purrrock/purrmidi/Platform/display/st7735/README.md

# Драйвер ST7735 (STMicroelectronics BSP)

Четыре файла скопированы без изменений из репозитория WeActStudio/MiniSTM32H7xx
(коммит `0425ea9ff305205aff1c62a85c2e8b0f32a143bc`):

`SDK/HAL/STM32H743/08-DCMI2LCD/Drivers/BSP/ST7735/{st7735.c, st7735.h, st7735_reg.c, st7735_reg.h}`

Лицензия этих файлов — BSD-3-Clause (указана в заголовках, © STMicroelectronics).
Остальной репозиторий MiniSTM32H7xx лицензирован GPL-3.0 и в проект не входит.
