purrrock/purrmidi/PINOUT.md

# PurrMidi — Физическое подключение (Распиновка)

Целевая платформа: **WeAct STM32H743VIT6 Mini**.

## Сводка зарезервированных выводов MCU
* **PA8–PA12:** USB-интерфейс.
* **PA13, PA14:** Отладка SWD.
* **PE4, PE5, PE6:** Аудиовыход SAI1 Block A.
* **PB10, PB11:** Диагностический UART (USART3).
* **PE3:** Отладочный светодиод (DEBUG_LED).
* **PE10–PE14:** Встроенный TFT-экран ST7735 (SPI4 + управляющие линии).
* **PC8–PC12, PD2 (+PD4):** Встроенный слот microSD / SDMMC1 *(см. ниже)*.
* **PB2, PB6, PD11, PD12, PD13, PE2:** Встроенная QSPI Flash 8 МБ (QUADSPI, банк SoundFont в режиме XIP).

## USB MIDI Host
Интерфейс USB OTG FS.
**Внимание к VBUS:** MIDI-клавиатуре требуется питание **5 В USB VBUS**. На физической плате наличие 5В на USB отсутствует. Вам нужно внешнее питание MIDI-клавиатуры, рекомендуется Y-разветвитель.

| Вывод STM32 | Назначение | Подключение |
|---|---|---|
| PA11 | USB_OTG_FS_DM | USB D− | белый
| PA12 | USB_OTG_FS_DP | USB D+ | зеленый
| PA10 | USB ID | *зарезервировано* |
| PA9 | USB VBUS | *зарезервировано* |
| PA8 | USB SOF | *зарезервировано* |

## Аудио ЦАП PCM5102A
Используется интерфейс **SAI1 Block A**. Сигнал MCLK не используется, ЦАП подключен по трёхпроводной схеме.

| Вывод STM32 | Сигнал SAI | Подключение PCM5102A |
|---|---|---|
| PE6 | SAI1_SD_A | DIN (Данные) |
| PE5 | SAI1_SCK_A | BCK (Тактирование) |
| PE4 | SAI1_FS_A | LRCK / WS (Выбор канала) |
| - | - | GND → GND (Земля) |
| - | - | VCC → Внешнее питание |
| - | - | OUTL/OUTR → Аудиовыход (Наушники/Усилитель) |

## Диагностический UART
Используется для вывода отладочных логов процесса запуска, состояния USB, MIDI и синтезатора.
Настройки: `115200, 8N1`.

| Вывод STM32 | Назначение | Подключение к USB-UART адаптеру |
|---|---|---|
| PB10 | USART3_TX | RX (белый)
| PB11 | USART3_RX | TX (зеленый)
| GND | GND | GND (черный)

## Встроенный TFT-экран ST7735
Экран 160×80 на плате WeAct, подключён к SPI4 (только передача, режим Simplex Bidirectional Master). Используется для вывода статуса MIDI, активных нот и названия аккорда.

| Вывод STM32 | Сигнал | Назначение |
|---|---|---|
| PE12 | SPI4_SCK | LCD_SCL |
| PE14 | SPI4_MOSI | LCD_SDA |
| PE11 | GPIO Output | LCD_CS (программный) |
| PE13 | GPIO Output | LCD_DC (команда/данные) |
| PE10 | GPIO Output | LCD_BL (подсветка, **включается низким уровнем**) |

## Отладочный светодиод
| Вывод STM32 | Назначение |
|---|---|
| PE3 | DEBUG_LED: горит, пока удерживается хотя бы одна нота |

## microSD / SDMMC1
Слот microSD на плате WeAct подключён к периферии SDMMC1. Используется 4-битный режим. Для загрузки банков `.SF2` при запуске устройства.

| Вывод STM32 | Сигнал SDMMC1 | Линия карты |
|---|---|---|
| PC8 | SDMMC1_D0 | DAT0 |
| PC9 | SDMMC1_D1 | DAT1 |
| PC10 | SDMMC1_D2 | DAT2 |
| PC11 | SDMMC1_D3 | DAT3 / CD |
| PC12 | SDMMC1_CK | CLK |
| PD2 | SDMMC1_CMD | CMD |

**Примечания:**
* Линия датчика карты PD4 не используется.
* На линиях D0–D3 и CMD должны быть включены подтяжки к питанию.
* Для всех линий SDMMC1 задаётся скорость выводов `Very High`.
* Настройки CubeMX (тактирование, делитель, NVIC, FatFs) описаны в разделе «Работа с SD-картой» файла `README_RU.md`.

## QSPI Flash (банк SoundFont, XIP)
Встроенная на плате микросхема Winbond W25Q64 (8 МБ) подключена к QUADSPI, Bank1. Линии разведены на плате жёстко,
поэтому в CubeMX нужно выбрать именно эти выводы (настройки и логика: `docs/SOUNDFONT_QSPI_SYNTH.md`):

| Вывод | Сигнал | AF | Назначение |
|---|---|---|---|
| PB2 | QUADSPI_CLK | AF9 | Тактирование |
| PB6 | QUADSPI_BK1_NCS | AF10 | Выбор кристалла |
| PD11 | QUADSPI_BK1_IO0 | AF9 | Данные 0 |
| PD12 | QUADSPI_BK1_IO1 | AF9 | Данные 1 |
| PE2 | QUADSPI_BK1_IO2 | AF9 | Данные 2 |
| PD13 | QUADSPI_BK1_IO3 | AF9 | Данные 3 |

* **IO3 - только PD13.** `PA1` тоже умеет `QUADSPI_BK1_IO3`, и CubeMX может назначить его по умолчанию, но на плате WeAct
  линия IO3 флеша заведена на PD13. С PA1 флеш не определится (JEDEC ID `00 00 00` / `FF FF FF`). PA1 остаётся свободным.
* Скорость всех шести выводов - `Very High` (по умолчанию CubeMX ставит Low, на 80-120 МГц это приводит к ошибкам чтения).
* Подтяжки не нужны, DMA и прерывания QUADSPI не используются. Flash Size в CubeMX - 22 (8 МБ).

## Интерфейс отладки (SWD)
Этот порт должен всегда оставаться доступным для прошивки.

| Вывод | Назначение |
|---|---|
| PA13 | SWDIO |
| PA14 | SWCLK |
| NRST | Reset (Сброс) |

## Временно не используется
Следующая периферия намеренно исключена из распиновки и не используется:
* Вторая внешняя память: 8 МБ SPI Flash (QSPI Flash используется, см. раздел «QSPI Flash»).
* Камера DCMI.
