purrrock/purrmidi/docs/PCM5102A_PINOUT.md

| STM32| Функция | PCM5102A |
| --- | --- | --- |
| ****  | I2S2_CK | BCK |
| ****  | I2S2_WS | LRCK / LCK |
| ****  | I2S2_SD | DIN |
| **3.3V**  | питание | VCC |
| **GND** | земля | GND |

Один из самых главных нюансов фиолетовых плат PCM5102A. Если оставить перемычки нераспаянными, модуль вообще не будет выдавать звук (уйдёт в режим «Mute») или начнёт сильно искажать аудиопоток из-за неверного формата данных. 
На оборотной стороне платы  расположены четыре конфигурационные группы контактов: H1L, H2L, H3L и H4L. Центральная площадка в каждой группе соединена с конкретной ножкой микросхемы, а боковые — с высоким уровнем (H — 3.3V) или низким (L — GND).
Для стандартных DIY-проектов (например, воспроизведение MP3/FLAC через ESP32 или Raspberry Pi) их необходимо распаять строго определённым образом, соединив каплей припоя центральный контакт с нужной буквой: 

## Стандартная конфигурация перемычек для большинства проектов
* 
* H1L (FLT) — Запаять на L (GND): Переключает цифровой фильтр в режим обычного времени задержки (Normal latency FIR filter) для стандартного качественного звука.
* H2L (DEMP) — Запаять на L (GND): Отключает функцию деэмфазиса (уменьшение искажений для старых CD-форматов 44.1 кГц). В обычном состоянии она должна быть выключена.
* H3L (XSMT) — Запаять на H (3.3V): Самая критичная перемычка. Переводит плату в рабочий режим (Soft un-mute). Если оставить её пустой или припаять к L, плата останется в беззвучном режиме сна (Mute).
* H4L (FMT) — Запаять на L (GND): Задаёт формат входящих цифровых данных как стандартный I2S. Если припаять к H, активируется формат Left-Justified, и вместо музыки вы услышите громкий цифровой шум. 
* 
------------------------------
## Перемычка SCK на лицевой стороне
На лицевой стороне платы (рядом с надписью SCK) есть ещё одна нераспаянная перемычка. Она замыкает пин системного тактового сигнала SCK на GND.
* 
* Зачем это нужно: Такие микроконтроллеры, как ESP32 или Raspberry Pi, выдают только 3 сигнальные линии (BCK, LCK, DIN) и не генерируют мастер-клок SCK. Замыкание этой перемычки заставляет внутренний умножитель частоты (PLL) чипа PCM5102A генерировать SCK автоматически из сигнала BCK.
* Рекомендация: Её тоже желательно капнуть припоем, чтобы не тянуть лишний внешний провод от пина SCK к земле вручную. 
*
