purrrock/purrmidi/docs/SD_CARD_AND_QSPI.md

# SD-карта (SDMMC1) и QSPI Flash

Как прибор обновляет банк SoundFont и что делать, если карта не читается. Устройство QSPI XIP и синтезатора SoundFont — в [SOUNDFONT_QSPI_SYNTH.md](SOUNDFONT_QSPI_SYNTH.md).

## Обновление банка SoundFont

SD-карта нужна **только для обновления банка**. Банк SoundFont хранится во внешней QSPI Flash и читается синтезатором оттуда (XIP); с SD-карты звук не воспроизводится. Чтобы обновить банк, положите новый файл в корень microSD-карты по пути `0:/SNDFNT.SF2`, вставьте карту и включите прибор. Если карты нет, прибор запускается с банком, который уже записан во флеш. Карту можно вынимать после старта.

При старте микроконтроллера загрузчик проверяет заголовок во внешней QSPI Flash W25Q64:
- Если заголовок совпадает с файлом на картe (размер, штамп времени, CRC32), старт происходит мгновенно, и синтезатор читает сэмплы напрямую из флеш-памяти в режиме XIP.
- Если файла на карте нет, но во флеш-памяти закоммичен валидный банк, синтезатор запускается сразу из флеш-памяти.
- Если банк на карте новый или изменён, загрузчик автоматически стирает и переписывает QSPI Flash (30–60 секунд, прогресс виден на дисплее и в UART).

Основные настройки CubeMX для SDMMC1:

1. **Connectivity → SDMMC1:** режим `SD 4 bits Wide bus`, Clock Edge — Rising, Clock Power Save — Disable, Hardware Flow Control — Disable.
2. **Clock divide factor:** `4` при источнике SDMMC 192 МГц, что даёт частоту SDMMC_CK 24 МГц по формуле `192 МГц / (2 × 4)`.
3. **GPIO:** скорость выводов `Very High`; подтяжки вверх на D0–D3 и CMD, без подтяжки на CLK.
4. **Clock Configuration:** источник тактирования SDMMC — PLL1Q (192 МГц).
5. **Middleware → FATFS:** режим `User-defined` (диск-драйвер — `Platform/sd/sd_storage.c`, только чтение; вызовы `MX_SDMMC1_SD_Init` и `MX_FATFS_Init` в CubeMX отключены), `USE_LFN` — Enabled with static working buffer, `MAX_SS`/`MIN_SS` — 512, `USE_FASTSEEK` — Enabled, **`FS_READONLY` — 1 (Read only)**, **`FS_LOCK` — 0** (при `FS_READONLY = 1` блокировки файлов должны быть отключены), `USE_MKFS` — 0.

> Почему не режим «SD Card» в CubeMX: сгенерированная инициализация SDMMC1 при отсутствии карты вызывает `Error_Handler()` и вешает прибор, а теперь карта вставлена только на время обновления. Кроме того, IDMA SDMMC1 не видит DTCM (там `.bss` и буферы FatFs), и сгенерированному драйверу нужны ручные обходы; в `sd_storage.c` они уже есть (bounce-буфер, проверка выравнивания и кэша).

Карту следует форматировать в FAT32.

### Диагностика: SD не монтируется / файл не открывается
При сбое в UART выводятся строки `[SD] ...` и `[SF2] ...`, по ним видно, на каком этапе остановилось:

| Строка в логе | Что означает |
|---|---|
| `SD mount failed: INIT`, `hsd.ErrorCode=0x...` | `HAL_SD_Init` не смог поднять карту: контакт, питание, тактирование, несовместимая карта. Код расшифровывается по маске `HAL_SD_ERROR_*`. |
| `SD mount failed: LINK` | `FATFS_LinkDriver` не удался: в проекте остался вызов `MX_FATFS_Init` или `_VOLUMES` ≠ 1. |
| `SD mount failed: MOUNT`, `f_mount=13` | Карта читается, но FatFs не нашёл файловую систему (`FR_NO_FILESYSTEM`). Проверьте разметку и формат. |
| `SD mount failed: MOUNT`, `f_mount=1`, `first read failure: stage=...` | `FR_DISK_ERR`: чтение сектора не удалось. `stage=1` - карта не вернулась в состояние TRANSFER, `2` - `HAL_SD_ReadBlocks_DMA` отказал, `3` - таймаут/ошибка DMA; рядом печатаются `hsd.ErrorCode` и состояние карты. |
| `f_open(...) failed: FRESULT=4` | Файла с таким именем в корне нет. Следом печатается список корня `[SD] root directory`, там видны реальные имена (частый случай: Windows скрыл расширение, и файл называется `SNDFNT.SF2.sf2`). |

Датчик наличия карты (`SD_DETECT`, PD4) не используется: карта определяется самой инициализацией `HAL_SD_Init`.

Подробности работы QSPI Flash XIP и конфигурации сэмплирования: `docs/SOUNDFONT_QSPI_SYNTH.md`.
