purrrock/purrmidi/docs/USB-UART adapter.md

Преобразователь USB - UART PL2303TA (с кабелем)
USB к UART TTL кабель PL2303 TA RS232 передаёт информацию со скоростью от 75 до 128 000 Кбит/с. Кабель может работать с 3.3 В или 5 В выходным напряжением, которое чаще всего имеют микроконтроллеры. Поддерживает USB 1.1 и 2.0.

На одном конце имеется USB разъём, а на другом – 4 разъёма-вывода «мама», которые удобно подсоединяются к любой плате с UART интерфейсом. Красный провод – Vcc c +5 В, белый – RXD, зелёный – TXD, чёрный – GND.
