purrrock/purrmidi/ROADMAP.md

# PurrMIDI: планы развития

 Что планируется сделать и в каком порядке.

**Главный принцип:** PurrMIDI остаётся простым в использовании. Собрать и настроить и использовать прибор должен уметь человек без опыта в электронике и без знаний музыкальной теории. Любая новая возможность либо работает «из коробки» с разумными значениями по умолчанию, либо остаётся необязательной.

Обозначения: `[ ]` — не начато, `[~]` — сделано частично, `[x]` — готово.

## Приоритеты

| Очередь | Что делаем | Зачем | Статус |
| --- | --- | ----- | --- |
| 1 | Сайт на GitHub Pages, фото и видео, FAQ, «Что умеет и чего нет» | Проект понятен новичку | сделана заготовка, нужны фото и видео |
| 2 | Единая таблица CC | Понятно, что делают ручки клавиатуры | таблица и иллюстрация готовы, осталось описать конкретные клавиатуры |
| 2 | Подбор ЦАП без пайки | Меньше барьеров при сборке | — |
| 2 | Опрос: нужен ли вариант без внешнего ЦАП | Понять, что важнее: простота сборки или качество звука | форма и блок на сайте добавлены, ждём ответов |
| 3 | Общая реверберация (и, возможно, хорус) | Заметно более «взрослый» звук | реверберация готова в коде и тестах, нужны замер времени и прослушивание на плате |
| 3 | CC и ударные в SoundFont | Больше возможностей банков | — |
| 4 | Новые движки | Больше тембров | — |
| 4 | Версии для Linux и macOS | Больше пользователей, которые могут проверить звук на ПК | — |

Очередь 1 — первым делом, 4 — когда остальное стабилизируется.

## 1. Релизы и прошивка

Цель: чтобы получить рабочий прибор, не требовалось собирать проект.

- [X] **Веб-прошивальщик (WebUSB DFU)**: `site/flash/` (страницы `/flash/` и `/ru/flash/`), без зависимостей и без отправки файлов на сервер.
- [x] **Проверено на реальной плате (Windows, Chrome)**: стирание двух секторов, запись 163 КБ блоками по 1024 Б, чтение назад и запуск прошивки прошли; драйвер ставить не нужно, STM32CubeProgrammer после веб-прошивки по-прежнему видит плату. Chrome не передаёт имя интерфейса, поэтому прошивальщик берёт alt 0 как внутреннюю flash (запасной вариант в `dfuse.js`).
  - [ ] Проверить Linux (правило udev), macOS и Android.

## 2. Сайт проекта

## 3. Единое поведение движков

**Сделано.** Описание нового поведения — в `docs/ENGINES.md`, раздел «Единое поведение движков»; тесты — `tests/test_engine_unified.cpp`. Ниже сохранён исходный план.

### Единая таблица CC

Для новичка полезнее картинка «что делают ручки вашей клавиатуры», чем описание по движкам.

- [x] Таблица типовых контроллеров: что делает каждый CC в каждом движке одной строкой на контроллер (готовая версия — в `docs/ENGINES.md`, раздел «Что делают ручки и колёса вашей клавиатуры»; ниже сохранён исходный набросок):

  | CC | Типичное название на клавиатуре | Что меняет |
  | -- | ------------------------------- | ---------- |
  | 1 | Mod wheel | «живее, ярче»: яркость (E-Piano, Pluck), фильтр (Lead), вибрато (Violin, SoundFont), хорус (Organ); в нуле звук не меняется |
  | 7 | Volume | общая громкость |
  | 64 | Sustain | педаль сустейна |
  | 71 | Resonance / Harmonic | резонанс или яркость (по движку) |
  | 74 | Brightness / Cutoff | яркость или срез фильтра |
  | 91 | Reverb | глубина реверберации (реализована) |
  | 93 | Chorus | глубина хоруса (после появления эффекта) |

- [x] Иллюстрация «ручки и колёса клавиатуры → что они делают» (SVG, русская и английская): `docs/controls_{ru,en}.svg`, `site/controls_{ru,en}.svg`; используется в README, `docs/ENGINES.md` и на сайте. Пересборка: `python3 tools/gen_controls_svg.py`.
- [ ] Отдельно описать, какие контроллеры есть на типовых недорогих клавиатурах (например, у NTK-61 и SMK-25 их набор отличается), чтобы пользователь понимал, что доступно именно ему. Общая подсказка («двигайте ручку, на дисплее появится её название или номер CC») уже в `docs/ENGINES.md`; конкретные модели нужно проверить на приборе, это пересекается с `docs/KEYBOARDS.md` (раздел 7).
- [x] Коротко показывать на дисплее подсказку при изменении CC («Bright 80%») и статус педалей (SUSTAIN ON/OFF): `Display_ShowControl()`.

## 4. Звук: эффекты и SoundFont

### Общая реверберация и хорус

Глобального эффекта сейчас нет (хорус есть только внутри Organ). Реверберация сильнее всего улучшает звучание при минимальной сложности для пользователя.

- [x] Выбрать алгоритм реверберации: лёгкий, с небольшим объёмом памяти. Выбрана FDN из 8 линий (Хаусхолдер, потери высоких частот, два диффузора, моно вход и стерео выход), `Engine/synth/reverb.h`. Варианты на 4, 6 и 8 линий сравнивались по импульсному отклику: время плотности эхо 127 / 99 / 65 мс, память 25 / 34 / 38 КБ; взято 8 линий (≈38 КБ).
- [ ] **Измерить бюджет рендера на плате.** По сгенерированному коду (около 300 инструкций на кадр) эффект занимает порядка 3–4,5% бюджета блока (2,67 мс), но это оценка, не замер. Нужно:
  - собрать диагностическую сборку (`-DAUDIO_DIAG_UART=1 -DSF2_DIAG_STATS=1`) и измерить время рендера с эффектом (`CC91 = 40`) и без него (`CC91 = 0`) на плотных аккордах SoundFont;
  - проверить, что пороги защиты (`SYNTH_REVERB_SHED_PCT` = 70%, `SYNTH_REVERB_RESTORE_PCT` = 55%) не отключают эффект на обычной игре.
- [x] **Что делать при нехватке времени:** реверберация плавно отключается раньше, чем гасятся голоса (`synth::ReverbLoadGuard`, порог 70% против 75% у SoundFont), и возвращается с гистерезисом.
- [x] Один параметр для пользователя; значение по умолчанию «немного» (`SYNTH_REVERB_DEFAULT` = 20; в GM по умолчанию 40). **Подобрать на слух:** кривую `SYNTH_REVERB_MAX_WET * (CC/127)^1.25`, значения по умолчанию и время затухания (`kRt60Seconds`, `kDamping` в `reverb.h`) выбирал расчёт по уровню (хвост ≈ −15 дБ при CC91 = 40), а не прослушивание.
- [x] **CC91** для тех, кто хочет управлять. **Значение намеренно не сохраняется:** после включения всегда «немного» (в RTC хранятся только инструмент и громкость), чтобы забытая ручка не портила звук. **CC93** (хорус) не реализован.
- [x] Буферы эффекта лежат в DTCM (`.bss`, ≈38 КБ): занятость DTCM 36% → 66%, AXI SRAM не изменилась (≈80%), FLASH +2,4 КБ. `tools/check_firmware_size.sh` и `tools/check_firmware_flags.sh` проходят.
- [ ] Хорус как второй шаг, только если останется запас по CPU (после замера на плате). Это необязательно.
- [x] Тесты: `tests/test_reverb.cpp` (обход бит-в-бит при нуле, спад, устойчивость, уровень, стерео, отсутствие щелчков при изменении глубины, Kill, защита по нагрузке) и `tests/test_engine_reverb.cpp` (CC91, сохранение при смене инструмента и Panic, сброс хвоста, All Sound Off, громкость 0, перегрузка). Существующие golden-тесты теперь идут с включённой реверберацией.

### SoundFont: контроллеры и ударные

- [ ] **Пробросить CC в SoundFont.** Сейчас у движка нет собственных CC. Как минимум: колесо модуляции (CC1), яркость (CC74), реверберация (CC91 уже есть на общем уровне, в TinySoundFont она не нужна), хорус (CC93). Проверить, какие из них TinySoundFont поддерживает штатно, а что придётся добавить.
- [ ] **Ударные (канал 10).** Сейчас канал не учитывается (omni), поэтому ударные из GM-банка на канале 10 не сыграют. Сначала проверить, как банк `__Florestan_Basic_GM_GS.sf2` ведёт себя в Windows-приложении и на приборе. Затем один из вариантов:
  - поддержать канал 10 как отдельный режим (ударная пресет-банка 128);
  - либо честно написать в документации, что ударные не поддерживаются, и объяснить, как выбрать ударный пресет вручную через Program Change.
- [ ] Оценить стоимость: отдельная обработка канала означает, что событие MIDI должно нести номер канала. Сейчас диспетчер его отбрасывает (`MIDI_Dispatch` не передаёт канал). Это затрагивает `midi_event.h`, `usb_midi_packet.c` и тесты.

## 5. Документация и сообщество

- [ ] **Фото готового устройства и короткое видео** (подключение и первый звук) в начале README и на сайте.
- [ ] **Список проверенных клавиатур** (`docs/KEYBOARDS.md`). Сейчас проверены:
  - NTK-61;
  - SMK-25.
  Для каждой указать: питание, какие CC и Program Change она отправляет, известные особенности (в `ARCHITECTURE.md` упомянут случай клавиатур на чипах Jieli, которым нужно восстановление USB-порта). Принимать дополнения от сообщества через Issues.
- [ ] Двуязычность (русский и английский) документации в `docs/`.

## 6. Аппаратная часть: ЦАП без пайки

Сейчас PCM5102A без пайки перемычек не работает: нужны H1L–H4L и перемычка SCK (см. `docs/HARDWARE.md`). Это главный барьер для людей без паяльника.

- [~] **Опрос: нужен ли дополнительный вариант без внешнего ЦАП.** ЦАП PCM5102A остаётся основным вариантом. Вопрос в том, нужен ли ещё и упрощённый: звук выводит встроенный ЦАП микроконтроллера (PA4 и PA5, 12 бит), а вместо модуля нужны только гнездо 3,5 мм и разделительный конденсатор. Форма голосования: `.github/ISSUE_TEMPLATE/audio_poll.yml` (метка `poll`), блок «Нужен ли вариант проще?» на сайте.
  - [ ] Собрать ответы и записать итог здесь. Заранее решить, какой результат считать достаточным для начала работы.
  - [ ] Если вариант нужен, сначала собрать прототип на плате и измерить уровень шума и фона от питания (USB, дисплей, QSPI). Только после этого обещать качество в документации.
  - [ ] При положительном решении: параметр сборки `AUDIO_OUT` (`I2S` по умолчанию, `DAC` как дополнительный), без удаления пути I2S. Для `DAC`: DAC1 + TIM6/TIM7 + DMA, преобразование знаковых отсчётов в беззнаковые, плавный старт и остановка против щелчков, при необходимости дизеринг. Описать в `docs/HARDWARE.md` схему с конденсатором и RC-фильтром и оговорить, что наушники напрямую подключать не стоит.
- [ ] **Критерии подбора ЦАП:**
  - работает с тремя линиями I2S (BCK, LRCK, DIN), без MCLK, 16 бит, 48 кГц;
  - питание 3,3 В;
  - не требует пайки (выводы уже распаяны, настройка перемычками-джамперами или вообще не нужна);
  - доступен и недорог, продаётся под понятным названием;
  - линейный выход подходит для наушников и усилителя; желательно с разъёмом 3,5 мм.
- [ ] **Кандидаты для проверки** (не проверены на приборе, это только список для проверки):
  - модули на PCM5102A, у которых нужные перемычки уже выставлены на заводе (в продаже встречаются варианты, где SCK замкнут на GND и формат I2S установлен изначально), нужно найти конкретные модели и сверить схему;
  - модули на UDA1334A (например, Adafruit I2S Stereo Decoder): ЦАП сам получает такт из BCK и не требует MCLK, настройка делается без пайки. Проверить формат данных (16 бит, 48 кГц) и уровень выхода.
- [ ] Для каждого проверенного модуля: фото, схема подключения, список настроек, результат прослушивания (шум, искажения, уровень).
- [ ] Обновить `docs/HARDWARE.md`, список покупок и сайт. Если подключение другого ЦАП меняет код (например, формат данных SAI), вынести его в параметр сборки или документированную настройку.

## 7. Новые движки

Одновременно звучит один движок, и они делят общую арену голосов (72 КБ). Новый движок не должен превышать размер самого большого (Pluck, 66 КБ), иначе придётся увеличивать арену (`SYNTH_ARENA_BYTES`).

- [ ] **Духовые** (флейта, саксофон, труба): физическая модель с волноводом и шумом дыхания либо субтрактивный синтез. Управление дыханием через aftertouch и CC2/CC11.
- [ ] **Ударные**: отдельный движок или режим SoundFont-канала 10 (см. раздел 4). Простой синтез барабанов (бочка, малый, хэт) может быть компактнее сэмплов.
- [ ] **Бас**: простой субтрактивный или FM-бас.
- [ ] **Пэд** (медленные струнные/«облачные» звуки): несколько детюнированных генераторов с медленной атакой.
- [ ] **Клавинет**: щипково-клавишный звук, близкий по устройству к Pluck/E-Piano.

Для каждого нового движка:

- [ ] строка в `docs/ENGINES.md` (голоса, описание, управление) и в таблицу Program Change;
- [ ] хостовый тест и golden-тест (`tests/`);
- [ ] проверка размера арены, времени рендера и размера прошивки;
- [ ] поддержка Pitch Bend, All Notes Off и единого смысла CC1 с самого начала (раздел 3).

## 8. Другие платформы

Хостовые тесты на Linux уже собираются в CI, RtMidi кроссплатформенный.

- [ ] **Linux:** сборка Windows-приложения (`Platform/windows/`) под Linux. Для этого, вероятно, нужно переименовать каталог в нейтральное имя (например, `Platform/desktop/`) и заменить Windows-специфичный вывод звука на miniaudio или аналог. Добавить сборку в CI.
- [ ] **macOS:** то же самое; учесть права доступа к MIDI и аудио.
- [ ] Обновить `docs/WINDOWS_BUILD.md` (переименовать в общий `DESKTOP_BUILD.md` или добавить разделы).

## 9. Идеи на потом

Идеи, которые пока не берём в работу, но не забываем:

- Профили velocity (мягкая / обычная / жёсткая) для клавиатур с плохой динамикой.
- Транспонирование.
- Разделение клавиатуры (split) на два инструмента.
- MIDI DIN вход (UART 31250 бод + оптрон) для старых клавиатур. Это уже электроника, поэтому только как необязательное расширение.
- Потенциометр громкости на АЦП или энкодер как необязательное расширение корпуса.
- USB-MIDI Device (подключение к ПК как MIDI-интерфейс): на плате WeAct есть только один USB-порт, поэтому потребовало бы другого аппаратного решения.
- Запись игры (MIDI-файл или WAV) на microSD.
- Метроном.

## Как предложить идею или помочь

Идеи, замечания и результаты проверки оборудования (клавиатуры, ЦАП) присылайте через [Issues](https://github.com/purrrock/purrmidi/issues). Чем подробнее описание (модель, что на дисплее, что в UART), тем легче воспроизвести проблему.
