purrrock/purrmidi/Review.md

## Ошибки и недоработки (на основе кода и TODO.md)

### Производительность и математика
*   **Использование `double`:** В `TODO.md` отмечено использование `double` в фильтрах и расчетах `pow`/`tan`. Для аудио-синтеза на Cortex-M7 (даже с DP-FPU) `float` является стандартом. `double` в два раза медленнее в некоторых операциях и увеличивает нагрузку на память/кэш.
*   **Вычислительная стоимость SoundFont:** 300 тактов на голос — это много для линейной интерполяции. Вероятно, проблема в отсутствии использования CMSIS-DSP или неоптимальном доступе к памяти QSPI.

### Аудио-тракт
*   **Отсутствие единообразного AutoGain:** В некоторых движках (Lead, Violin) зафиксировано усиление, что может приводить к клиппингу на плотных аккордах. 
*   **Обработка ошибок:** `Error_Handler()`, который просто перезагружает прибор, недопустим для конечного продукта. Пользователь не должен слышать резкий щелчок и ждать перезагрузки при возникновении программной ошибки.
Вместо простого ребута в Error_Handler, записывать код ошибки и адрес инструкции в небольшую область SRAM (которая не затирается при Soft Reset) и выводить краткий код ошибки на TFT-дисплей

## Рекомендации по улучшению

### Оптимизация (Performance)
1.  **Миграция на `float`:** Замените все `double` на `float`. Используйте литералы `0.0f` вместо `0.0`.
2.  **CMSIS-DSP:** Интегрируйте библиотеку `arm_math.h`. Вместо самописных функций используйте `arm_sin_f32`, `arm_exp_f32` и т.д. Они оптимизированы под инструкции SIMD Cortex-M7.
3.  **TCM для критических циклов:** Если джиттер в аудио-потоке сохранится, попробуйте перенести наиболее часто вызываемые функции рендеринга (inner loops) в **ITCM** (Instruction Tightly Coupled Memory), чтобы исключить влияние кэша инструкций.

### Функциональность и UX
1.  **Персистентность настроек:** Сейчас выбор инструмента не запоминается. Рекомендую выделить небольшой сектор во внутренней Flash (или использовать EEPROM/Backup SRAM) для сохранения последнего выбранного пресета и настроек громкости.
2.  **Сглаживание (Interpolation):** Для параметров CC (например, громкость или частота среза) внедрите простую линейную интерполяцию между кадрами (smoothing), чтобы избежать «ступенчатого» звука (zipper noise).

### Тестирование
1.  **CI/CD для Windows-версии:** Настройте GitHub Actions для автоматического прогона тестов в `tests/` при каждом пуше.
2.  **Unit-тесты на граничные случаи:** Добавьте тесты на «панику» (одновременное нажатие 128 нот) для проверки устойчивости `SynthArena` и `SoftLimit`.

### Прочее

Перевести README.md на English, Ссылку на README_RU.md сделать в начале.

Добавьте проверку, что SNDFNT.SF2 < 8МБ перед загрузкой

---
**Итог:** Основной вектор развития сейчас — переход от «работающего прототипа» к «оптимизированному продукту» через замену `double` на `float` и внедрение CMSIS-DSP.
