purrrock/purrmidi/docs/ENGINES.md

# Звуковые движки и управление

Справочник по инструментам PurrMidi: список движков, выбор программы, управление с MIDI-клавиатуры и устройство каждого
движка. Краткая инструкция по работе с прибором — в [README](../README_RU.md), внутреннее устройство прошивки — в
[ARCHITECTURE.md](ARCHITECTURE.md), банк SoundFont — в [SOUNDFONT.md](SOUNDFONT.md).

## Список движков

Одновременно звучит один движок. Один и тот же код работает в прошивке и в Windows-приложении.

| Программа | Инструмент | Голоса | Описание | Исходники (`Engine/synth/`) |
| ---: | --- | -----: | --- | --- |
| `0` | **E-Piano** | 8 | FM-электропиано в духе Rhodes / DX7 (по умолчанию) | `epiano_synth.cpp` |
| `1` | **Pluck** | 8 | Нейлоновая гитарная струна (Карплус — Стронг + корпус) | `pluck_synth.cpp` |
| `2` | **Lead** | 8 | Аналоговый субтрактивный лид на DaisySP (`Oscillator`, `Svf`, `Adsr`) | `lead_synth.cpp` |
| `3` | **Organ** | 12 | Тонколесный орган на `bfreeOrgan2`, drawbars и хорус | `organ_synth.cpp` |
| `4` | **Violin** | 8 | Физическая модель смычковой струны (волновод, как STK `Bowed`) и резонансы деки | `violin_synth.cpp` |
| `5…` | **SoundFont** | до 32 | SoundFont2 на TinySoundFont: каждый пресет банка — отдельная программа | `soundfont_synth.cpp` |

## Выбор инструмента (Program Change)

Нумерация значения Program Change (`data1`) начинается с нуля. Некоторые клавиатуры показывают номера с единицы, тогда `127`
отображается как №128. На дисплее номер тоже показан с единицы (программа `0` → «01»).

Всего программ `5 + N`, где `N` — число пресетов в загруженном SF2. Если банка нет, `N` считается равным 1: под номером `5`
остаётся программа «SoundFont», выбор которой сообщает об ошибке. Число программ возвращает `SynthEngine_GetProgramCount()`.

| `data1` | Действие |
| ---: | --- |
| `0…4` | Выбрать E-Piano, Pluck, Lead, Organ, Violin |
| `5…(5+N−1)` | Выбрать SoundFont и его пресет №(`data1` − 5) |
| до `126` | Номера за пределами списка: `program % (5 + N)` |
| **`127`** | **Следующая программа по кругу** (Next Instrument) |

Порядок цикла `127`: E-Piano → Pluck → Lead → Organ → Violin → SF: пресет 1 → … → SF: пресет N → E-Piano.
Недоступные движки (например, SoundFont без банка) пропускаются. Напрямую выбрать программу `127` нельзя.

Правила переключения:

* Канал не учитывается (omni).
* Повторный выбор активного инструмента состояние не сбрасывает. Смена пресета SoundFont внутри активного движка не обрывает
  звучащие ноты: они доигрывают прежним тембром, новые берут новый пресет. Выбранный пресет сохраняется при `Panic` и при
  переключении на другой инструмент и обратно.
* При смене инструмента новый движок стартует с чистого состояния; возможна короткая пауза тишины.
* **Кнопка K1 (PC13)** на плате работает как Program Change `127`, с неблокирующим debounce.
  Если ваш контроллер умеет отправлять Program Change, назначьте `127` на любую кнопку (например, SUS).
* **Сохранение.** На STM32 выбор программы и громкость сохраняются в резервных регистрах RTC (`Platform/system/backup.c`) и
  восстанавливаются после перезапуска. После отключения питания они остаются только при установленной батарейке на VBAT
  (см. [HARDWARE.md](HARDWARE.md#батарейка-vbat-необязательно)). Без батарейки, а также при пустых или повреждённых данных
  запускается E-Piano (`SYNTH_ENGINE_DEFAULT` в `synth_engine.h`).
* В UART выводится строка `[PC] program N -> <имя>`.

## Общая громкость (CC7)

Громкость всего синтезатора задаётся Control Change **CC7** (канал не учитывается). У PCM5102A нет аппаратной регулировки, поэтому
`SynthEngine_FillStereoBuffer()` умножает выход активного движка на коэффициент.

* Кривая квадратичная: `127` → 1,0, `64` → ≈0,25 (−12 дБ), `0` → тишина.
* Коэффициент меняется плавно внутри блока, щелчков при вращении ручки нет.
* CC7 перехватывается в `SynthEngine_ControlChange()` и в движки не передаётся.
* Громкость не сбрасывается при смене инструмента; начальное значение — `SYNTH_MASTER_VOLUME_DEFAULT` (127).
* Макросы `SYNTH_MASTER_VOLUME_CC`, `SYNTH_MASTER_VOLUME_DEFAULT`; API: `SynthEngine_SetMasterVolume()` / `GetMasterVolume()`.

## Общая реверберация (CC91)

Один эффект поверх звука любого инструмента: добавляет ощущение помещения, не меняя тембр. Управляется Control Change **CC91**
(канал не учитывается); пользователю нужен всего один параметр.

* **По умолчанию «немного»:** значение `40` (так в стандарте GM), хвост примерно на 15 дБ тише прямого звука. `0` выключает
  эффект полностью (звук бит-в-бит такой же, как без него, процессор не тратится), `127` даёт заметный «зал».
* **Не сохраняется при выключении.** После включения питания реверберация всегда стартует со значения по умолчанию. Это
  сделано намеренно: в RTC сохраняются только выбранный инструмент и громкость, а любую другую настройку (в том числе
  забытую в максимуме ручку) выключение питания сбрасывает, чтобы прибор не звучал «плохо» из-за вчерашней крутилки.
* **Как громкость, это общая настройка прибора:** она не сбрасывается сменой инструмента и `Panic()`. А вот *хвост* эффекта
  сбрасывается при смене инструмента и `Panic()` (звук предыдущего инструмента не «перетекает» в новый), а CC120 (All Sound
  Off) гасит его за ~21 мс вместе с голосами; после этого ещё ~170 мс вход эффекта заглушён, чтобы доигрывающие остатки
  движка не породили новый хвост. CC123 хвост не трогает: ноты отпускаются как обычно, хвост затухает сам.
* **Стоит до регулятора громкости**, поэтому CC7 = 0 заглушает и хвост.
* **Без щелчков:** любое изменение глубины, включение и выключение идут линейной рампой внутри блока (2,67 мс).
* **Защита от перегрузки.** Если сам движок занял больше 70% бюджета блока два блока подряд (`SYNTH_REVERB_SHED_PCT`),
  реверберация плавно отключается, чтобы не мешать, а голоса SoundFont (см. [SOUNDFONT.md](SOUNDFONT.md), «Защита от
  перегрузки») начинают гаситься только с 75%. Вернётся она, когда нагрузка будет ниже 55% 128 блоков подряд (≈0,34 с).
  Время меряется по самому движку без эффекта, поэтому решение не раскачивается. На ПК часов нет, там эффект всегда включён.
* **Алгоритм** (`Engine/synth/reverb.h`): сеть задержек с обратной связью (FDN) из 8 линий 13–37 мс с матрицей Хаусхолдера,
  потерями высоких частот и двумя диффузорами на входе; вход моно, выход стерео с разными ортогональными наборами для левого и
  правого канала. Время затухания около 1,4 с. Состояние занимает ≈38 КБ в `.bss` (DTCM), AXI SRAM не затрагивается.
* **Цена.** Около 300 инструкций на кадр, то есть по оценке 3–4,5% бюджета блока; это оценка по сгенерированному коду, на плате
  время не измерялось (см. ROADMAP). Хорус (CC93) пока не реализован и CC93 игнорируется.
* Макросы `SYNTH_REVERB_ENABLE` (0 убирает эффект из сборки целиком), `SYNTH_REVERB_CC`, `SYNTH_REVERB_DEFAULT`,
  `SYNTH_REVERB_MAX_WET`, `SYNTH_REVERB_SHED_PCT`, `SYNTH_REVERB_RESTORE_PCT`, `SYNTH_REVERB_RESTORE_BLOCKS`; API:
  `SynthEngine_SetReverb()` / `GetReverb()` / `IsReverbShed()`. Тесты: `test_reverb` (алгоритм) и `test_engine_reverb` (CC91,
  смена инструмента, All Sound Off, перегрузка).

## Что делают ручки и колёса вашей клавиатуры

Ручки и колёса клавиатуры и что они делают в PurrMidi

Одна строка на контроллер. Названия в колонке «Как называется на клавиатуре» типовые: на вашей модели надпись может быть
другой, важен **номер CC**. Если инструмент контроллер не использует, он просто игнорируется.

| CC | Как называется на клавиатуре | Что меняет |
| -: | --- | --- |
| Pitch Bend | Колесо высоты тона | Высота звука ±2 полутона, во всех инструментах |
| 1 | Mod wheel, мод-колесо | «Живее, ярче»; в нуле звук не меняется. E-Piano, Pluck: яркость. Lead: глубина огибающей фильтра. Violin, SoundFont: вибрато. Organ: с 64 и выше включает хорус |
| 2, 11 | Breath, Expression | Violin: экспрессия (сила смычка). SoundFont: CC11 меняет экспрессию (TinySoundFont); CC2 не используется. Остальные: ничего |
| 7 | Volume, громкость | Общая громкость, во всех инструментах |
| 10 | Pan, панорама | Только SoundFont (обрабатывает TinySoundFont) |
| 20–28 | Drawbars, фейдеры | Только Organ: регистры 16′ … 1′ |
| 64 | Sustain, педаль | Педаль сустейна, во всех инструментах, кроме Organ (у органа сустейна нет) |
| 70 | Sound Variation | Organ: хорус вкл/выкл. Violin: положение смычка |
| 71 | Resonance, Harmonic | E-Piano, Pluck: яркость. Lead: резонанс фильтра. Organ: скорость хоруса. Violin: прижим смычка |
| 72 | Release, отпускание | E-Piano, Lead, Violin: время отпускания. Pluck: длительность затухания. Organ: глубина хоруса |
| 73 | Attack, атака | Lead, Violin: время атаки |
| 74 | Brightness, Cutoff | E-Piano, Pluck, Violin: яркость. Lead: частота среза фильтра |
| 75 | Sound Controller 6 | Violin: шум смычка |
| 77, 78 | Sound Controller 8, 9 | Только Organ: атака и отпускание |
| 91 | Reverb | Общая реверберация, во всех инструментах: «немного» после включения, не сохраняется при выключении (раздел выше) |
| 93 | Chorus | Пока не используется (появится вместе с общим хорусом) |
| 120 | All Sound Off | Мгновенная тишина, во всех инструментах |
| 123 | All Notes Off | Отпустить все ноты, во всех инструментах |

Channel Pressure (aftertouch) использует только Violin: сильнее нажали на уже взятые клавиши, смычок звучит активнее.

**Как узнать, что отправляет ваша ручка.** Двигайте её при включённом приборе: на дисплее примерно на секунду появится
название контроллера и полоса со значением («Bright 80%»). Для ручек без названия показывается номер («CC 21»), а
педали показывают «ON» и «OFF». Ручка, номера которой нет в таблице, просто ничего не меняет; многие клавиатуры позволяют
назначить ручке другой CC в собственном редакторе.

## Управление с клавиатуры

Общее для **всех** движков (одинаково, независимо от выбранного инструмента):

| Сообщение | Что делает |
| --- | --- |
| Pitch Bend | ±2 полутона (у SoundFont — по RPN 0, по умолчанию тоже ±2) |
| CC1 (мод-колесо) | «Живее / ярче»: в нуле звук ровно такой, как без колеса, вверх — добавляется выразительность (см. таблицу ниже) |
| CC7 | общая громкость (в движки не передаётся) |
| CC91 | общая реверберация (в движки не передаётся; по умолчанию «немного», не сохраняется при выключении) |
| CC64 | педаль сустейна (кроме Organ: у органа нет сустейна) |
| CC120 | All Sound Off: все голоса и хвост реверберации гаснут быстро (10–20 мс, без щелчка), даже при зажатых клавишах и педали |
| CC123 | All Notes Off: отпускает все удерживаемые ноты и снимает педаль; хвосты доигрывают обычным затуханием |

Подробнее — в разделе «Единое поведение движков» ниже.

| Движок | Управление |
| --- | --- |
| E-Piano | CC71, CC74 — яркость (индекс FM, `64` ≈ штатная); CC1 **добавляет** яркость (до значения, как при CC74 = 127; действует на новые ноты); CC72 — время отпускания 0,08–1,7 с |
| Pluck | CC71, CC74 — яркость (`0` мягкий нейлон … `127` яркий); CC72 — длительность затухания; CC1 (мод-колесо) **добавляет** яркость, в нуле тембр не меняется |
| Lead | CC1 **добавляет** глубину огибающей фильтра (с 4000 до 10 000 Гц: фильтр «раскрывается» сильнее на атаке); CC74 — частота среза (30–12 000 Гц); CC71 — резонанс; CC73 — атака (0,002–1,5 с); CC72 — отпускание (0,02–2 с) |
| Organ | CC20–28 — drawbars (16′ … 1′); CC70 — хорус вкл/выкл; CC1 ≥ 64 — тоже включает хорус (как переключатель Leslie; хорус включён, если включён любым из двух); CC71 / CC72 — скорость / глубина хоруса; CC77 / CC78 — атака / отпускание |
| Violin | CC1 **добавляет** вибрато (в нуле — вибрато по умолчанию, вверх — до максимума); CC2 / CC11 — экспрессия; CC70 — положение смычка; CC71 — прижим; CC72 / CC73 — отпускание / атака; CC74 — яркость; CC75 — шум смычка |
| SoundFont | CC1 — вибрато (качание высоты ±30 центов, 5,5 Гц; делается в движке, TinySoundFont модуляторов не умеет); Pitch Bend по RPN 0 (по умолчанию ±2 полутона) |

**Channel Pressure (aftertouch)**: только Violin (усиливает смычок). Polyphonic Key Pressure доходит до движка, но пока не
используется ни одним. Остальные движки aftertouch игнорируют. Velocity меняет громкость, а у E-Piano, Pluck и Violin ещё и тембр.

## Единое поведение движков

Поведение для четырёх сообщений одинаково во всех шести движках
(`tests/test_engine_unified.cpp` проверяет каждое из них на каждом движке).

**Pitch Bend (±2 полутона).** Хранится как «последнее значение» без очереди: потеря промежуточных значений безвредна, а возврат
в центр потеряться не может. Положение колеса сглаживается (≈1–2 мс), поэтому при плавном ходе колеса щелчков нет. Новая нота
сразу берёт текущее положение колеса. Как это сделано в каждом движке:

| Движок | Как меняется высота |
| --- | --- |
| E-Piano, Violin, SoundFont | как раньше (множитель частоты голосов; у SoundFont — колесо канала TinySoundFont, диапазон по RPN 0) |
| Pluck | Перестраивается линия задержки струны: целая задержка и all-pass дробной части пересчитываются раз в 16 отсчётов. При смене целой части задержки согласуется состояние all-pass (иначе на каждом переходе щёлкало бы). Хвост линии обнуляется при каждой ноте, чтобы удлинение задержки не читало остатки прошлой ноты. Частота зажимается в допустимый диапазон (линия 2048 отсчётов, потолок 0,45·fs). Остаточные слабые «тики» (порядка 2× от обычных пиков сигнала) возможны на быстром ходе колеса: это свойство перестройки физической модели |
| Lead | Частота осциллятора каждого голоса умножается на множитель колеса на control-rate тике (каждые 8 отсчётов); фаза не сбрасывается |
| Organ | Общая временная ось тоновых колёс получила дробную часть: все колёса сдвигаются на одно отношение, фаза непрерывна. Реализовано в `bfreeOrgan2` (`synth_organ::set_pitch_delta`, `voice_organ::render_block_bent`); пока колесо в центре и ни разу не двигалось, используется прежний путь (звук бит-в-бит прежний). После первого движения колеса остаётся путь с дробной частью (чуть дороже по CPU), чтобы возврат в центр не сдвигал фазу колёс |

**All Notes Off (CC123)** выполняется в общем коде `SynthEngine`, а не в движках. `SynthEngine` ведёт счётчик нажатий по нотам
(по входящим Note On / Note Off) и по CC123 отправляет движку обычные Note Off для всех удерживаемых нот, затем снимает педаль
(CC64 = 0). Поэтому отпускание идёт тем же путём, что и от настоящей клавиатуры (очередь событий, естественное затухание,
педаль); результат бит-в-бит совпадает с ручным отпусканием всех нот и снятием педали (тест). Ноты, которые держала только
педаль, тоже затухают. Счётчик сбрасывается при смене инструмента, `Panic` и All Sound Off.

**All Sound Off (CC120)**: `SynthEngine` сбрасывает счётчик удерживаемых нот и передаёт CC120 движку; как именно гасить голоса,
знает только движок, поэтому здесь код разный, а результат одинаковый — тишина за 10–20 мс без щелчка, педаль сброшена, а
остальные настройки (яркость, регистры органа, колесо высоты тона) не меняются:

| Движок | Реакция на CC120 |
| --- | --- |
| E-Piano | как прежде (быстрое гашение голосов, 20 мс) |
| Pluck | демпфер струн с постоянной 20 мс |
| Lead | отпускание обеих огибающих 10 мс |
| Violin | быстрый спад смычка и струны, 20 мс |
| Organ, SoundFont | как прежде (обрыв голосов органа; `tsf_channel_sounds_off_all`) |

**`Panic()` и смена инструмента** одинаково сбрасывают всё состояние движка: голоса, контроллеры, педаль, очередь событий,
счётчики, генераторы шума. Тест `test_engine_unified` проверяет это для каждого движка: после «грязного» сценария (все
контроллеры, колесо, педаль, ноты, RPN) звук бит-в-бит такой же, как у только что выбранного движка. Эта проверка нашла
ошибку в SoundFont: `tsf_reset()` лишь запускает быстрый спад голосов, и хвост прежних нот несколько миллисекунд попадал в
новый звук. Теперь после `tsf_reset()` вызывается `tsf_kill_all_voices()` (добавлена в TinySoundFont). Исключение, сделанное
намеренно: положение колеса высоты тона `SynthEngine` помнит при смене инструмента (колесо физически стоит где стоит), а
`Panic()` возвращает его в центр. Общая громкость (CC7) и глубина реверберации (CC91) не сбрасываются, а хвост реверберации сбрасывается вместе с голосами.

**CC1 (мод-колесо)** везде означает «звук живее, ярче»; в нуле звук **ровно** такой же, как без колеса (бит-в-бит), а вверх
добавляется выразительность. Технически по-разному: E-Piano и Pluck — яркость (индекс FM / яркость струны), Lead — глубина
огибающей фильтра, Violin — вибрато, Organ — хорус (переключатель, как Leslie «быстро»), SoundFont — вибрато. Изменение
по сравнению с прежним: раньше у E-Piano, Lead и Violin колесо в нуле *понижало* значение параметра ниже штатного (для Lead и
Violin вибрато пропадало совсем), а у Organ и SoundFont колесо не делало ничего.

## E-Piano

FM-синтезатор в духе Rhodes / Yamaha DX7 «E.PIANO 1». Звучит по умолчанию после включения. Все операторы — синусоиды
(таблица 2048 точек, линейная интерполяция), частота ноты `f`:

| Пара | Модулятор → несущая | Роль |
|---|---|---|
| BODY | `1·f → 1·f` | тело звука; индекс растёт с velocity и затухает («лай» при сильном ударе мягчеет) |
| TINE | `14·f → 1·f` | «звон» молоточка, T60 ≈ 0,3 с; отключается плавно, когда `14·f` приближается к 18 кГц (защита от алиасинга) |

`voice = amp_env · velocity_gain · (BODY + tine_level · TINE)`. Индексы модуляции пропорциональны `velocity²`, громкость
~ `velocity^1,5`; к верхним нотам индекс убывает, басы звучат дольше (T60 от ~18 с на C2 до ~4,5 с на C6). После отпускания клавиши
T60 = 0,25 с (CC72), при педали нота затухает по «удерживаемой» огибающей. Повторная нота переиспользует свой голос; при нехватке
голосов крадётся самый тихий отпущенный, затем самый старый (атака 2 мс, без щелчков). Лёгкая панорама по положению клавиши
(`EPIANO_STEREO_SPREAD`, 0 = моно), уровень — `EPIANO_MASTER_GAIN` и мягкий лимитер.

Константы тембра — в начале `epiano_synth.cpp` (`EPIANO_TINE_RATIO`, `EPIANO_BARK_T60_SEC`, `EPIANO_TINE_T60_SEC`,
`EPIANO_MASTER_GAIN`), индексы модуляции — в `start_voice()`. Размер для Cortex-M7: около 3 КБ кода и 9 КБ RAM.

## Pluck

Собственная модель Карплуса — Стронга с корпусом классической гитары. Выход моно, дублируется в оба канала.

```text
шум → два ФНЧ → гребёнка положения щипка → убрать DC → нормировка RMS
                           │ (заполняет линию задержки при Note On)
                           ▼
        ┌────────── линия задержки (2048 сэмплов) ◄───────────┐
        ▼                                                      │
   all-pass (дробная часть задержки) → ФНЧ потерь → усиление g ┘
                           │
                     демпфер (release)
                           ▼
        сумма голосов → корпус → мягкий ограничитель → int16
```

* **Возбуждение.** Шум (xorshift32 со сбросом в `PluckSynth_Init()`, звук воспроизводим бит-в-бит) проходит два ФНЧ со срезом
  `500 + 3000·яркость + 1500·velocity` Гц, затем гребёнку `e[j] −= e[j − P]`, `P = 0,17·длина` (подавляет гармоники, кратные
  положению щипка). Уровень нормируется по RMS, поэтому при одной velocity все ноты одинаково громкие.
* **Петля.** `g` подбирается так, чтобы основной тон падал на 60 дБ за T60, а ФНЧ потерь гасит обертоны быстрее. На C4
  `T60 = 5·decay − 1,3` с (ограничено 0,15–3,7 с, по умолчанию `decay = 0,88`, около 3,1 с); для другой высоты умножается на
  `(261,63 / f)^0,35`. Настройка (задержка) считается один раз при Note On.
* **Корпус.** Три общих резонатора на 98 Гц (воздух), 205 Гц (верхняя дека) и 410 Гц.
* **Выход.** Нормировка `1/(1+0,4·(N−1))`, `PLUCK_OUTPUT_GAIN` (1,9), `synth::SoftLimit` (колено 0,85, потолок 0,99).
  После Note Off демпфер гасит струну за 0,2 с (`PLUCK_RELEASE_TIME_SEC`).

Параметры по умолчанию (`pluck_synth.cpp`): `PLUCK_BRIGHT_DEFAULT` 0,40, `PLUCK_DECAY_DEFAULT` 0,88, `PLUCK_PICK_POSITION` 0,17,
`PLUCK_EXCITE_RMS` 0,30. Яркость из CC71/74: `0,10 + значение·0,90`; CC1 даёт `яркость + (1 − яркость)·колесо`; CC72:
`0,50 + значение·0,495`. API: `PluckSynth_SetDecay(0…1)`, `PluckSynth_SetDamp(0…1)` (Damp = яркость).

Ограничения: если менять яркость во время ноты, высота плывёт на несколько центов; минимальная частота около 23,5 Гц; корпус
моделируется тремя резонансами, а не импульсным откликом настоящей гитары.

## Lead

Полифонический субтрактивный синтезатор: осциллятор и фильтр `Svf` из DaisySP, огибающие `Adsr`. Параметры управляются CC
(см. таблицу выше), CC1 добавляет глубину огибающей фильтра. Pitch Bend (±2 полутона) меняет частоту осцилляторов.

## Organ

Адаптер `organ_synth.cpp` над библиотекой `bfreeOrgan2` (`Middlewares/Third_Party/bfreeOrgan2/`). Библиотека доработана
(помечено `PurrMidi` в коде): блочный рендер, нестатичные таблицы и поддержка Pitch Bend (дробная часть общей временной оси,
см. «Единое поведение движков»).
Библиотека рассчитана на большой запас по уровню, поэтому в адаптере добавлено усиление `ORGAN_OUTPUT_GAIN` (×3,5, около +11 дБ)
и мягкий ограничитель `synth::SoftLimit` (колено 0,80, потолок 0,98), как у Lead и Violin. Громкость органа выровнена с остальными
движками по одному и тому же аккорду C–E–G; для коррекции меняется одна константа.

На плотных аккордах фиксированное усиление ×3,5 выводило пик за колено ограничителя и давало хрип. Поэтому усиление ведёт
медленный регулятор `synth::AutoGain` (`synth_common.h`): на 1–3 нотах остаётся ×3,5, на плотных аккордах плавно снижается так,
чтобы пик блока не превышал колено (быстрое снижение за 32 отсчёта, возврат с постоянной времени 0,25 с, `ORGAN_AGC_RELEASE`).
Форма волны не искажается, `SoftLimit` остаётся страховкой. Цена: громкость аккорда перестаёт расти выше примерно −11 дБFS
(RMS), уже звучащие ноты слегка «приседают» при добавлении новых.

## Violin

Физическая модель смычковой струны (волновод + нелинейное трение смычка, как в STK `Bowed`), резонансы деки, 8 голосов.
Управление — в таблице выше; Pitch Bend (±2 полутона) и aftertouch (усиливает смычок) поддерживаются. CC1 добавляет вибрато
к вибрато по умолчанию.

## SoundFont

Синтезатор SoundFont2 на базе TinySoundFont. Сэмплы читаются прямо из QSPI Flash (XIP), банк обновляется с SD-карты при
запуске. На дисплее показывается «SF:имя пресета». Подробности — в [SOUNDFONT.md](SOUNDFONT.md).

## Общий программный интерфейс

* `SynthEngine_Init()` — запуск движка по умолчанию.
* `SynthEngine_NoteOn()`, `SynthEngine_NoteOff()`, `SynthEngine_ControlChange()`.
* `SynthEngine_ProgramChange()` — выбор по номеру программы; `SynthEngine_Select()` — по идентификатору движка;
  `SynthEngine_GetCurrent()`.
* `SynthEngine_FillStereoBuffer()` — заполнение стереобуфера (движок → реверберация → громкость).
* `SynthEngine_SetReverb()` / `GetReverb()` — глубина реверберации (не сохраняется).

`SynthEngine` сам выбор не сохраняет, это делает `main.c`, и сохраняет он **только выбранный инструмент и громкость**: ни реверберация, ни яркость, ни регистры органа, ни другие ручки при выключении не запоминаются. Вызовы управления идут из основного цикла или MIDI-контекста, а
заполнение буфера — из аудиопрерывания (STM32) или аудиопотока (ПК).

## Тесты

Для каждого движка есть хостовой тест `tests/test_<движок>_host.cpp`; `test_queue_dispatch` проверяет цепочку «очередь →
диспетчер → синтезатор», `test_synth_switch` — переключение по Program Change, `test_engine_golden` — бит-в-бит одинаковый
результат при повторных прогонах с переключением движков (с включённой реверберацией), `test_reverb` и `test_engine_reverb` — общую реверберацию. Запуск — в [WINDOWS_BUILD.md](WINDOWS_BUILD.md#прогон-тестов).
