purrrock/purrmidi/docs/Libs.md

# Новые алгоритмы синтеза для PurrMidi

Я изучил основные файлы репозитория [purrrock/purrmidi](https://github.com/purrrock/purrmidi), прежде всего диспетчер звуковых движков, реализацию E-Piano, Pluck и Sine. Для проекта я бы предложил не просто добавлять новые варианты генерации волны, а расширять набор инструментов с принципиально разным тембром и характером звучания, учитывая возможности STM32H743 и существующий аудиотракт.

## 1. Что уже реализовано

0. E-Piano — FM-синтез

[epiano_synth.cpp](https://github.com/purrrock/purrmidi/blob/main/Engine/synth/epiano_synth.cpp)

Полифонический синтез электропиано с модуляцией частоты, затухающими составляющими тембра и стереопанорамированием. До 8 голосов по умолчанию. Подходит для Rhodes-подобных тембров.

1. Pluck — физическое моделирование струны

[pluck_synth.cpp](https://github.com/purrrock/purrmidi/blob/main/Engine/synth/pluck_synth.cpp)

Модель Karplus–Strong через `daisysp::Pluck`. Имитирует возбуждение струны и её затухание. Подходит для щипковых тембров, но в первую очередь ориентирована на одну активную струну.

2. Sine — синусоидальный генератор

[sine_synth.c](https://github.com/purrrock/purrmidi/blob/main/Engine/synth/sine_synth.c)

Одноголосный генератор с огибающей, громкостью и поддержкой sustain. Сейчас это скорее диагностический инструмент, чем полноценный музыкальный тембр.

Источники: [диспетчер движков](https://github.com/purrrock/purrmidi/blob/main/Engine/synth/synth_engine.cpp), [общий интерфейс](https://github.com/purrrock/purrmidi/blob/main/Engine/synth/synth_engine.h).

Уже имеющиеся алгоритмы дают три разных отправных точки: FM, физическое моделирование струны и базовый осциллятор. Поэтому я бы выбирал следующие алгоритмы по двум критериям: насколько новый тембр отличается от существующих и насколько разумно его реализовать на микроконтроллере.

## 2. Какие алгоритмы стоит добавить

Я бы рассматривал следующие шесть вариантов. Они различаются не только вычислительной сложностью, но и тем, какие музыкальные задачи решают.

## 3. Субтрактивный синтез (Subtractive)

Приоритет № 1

Тембры: аналоговые лиды, басы, пэды, синтезаторные струны.

Генерация богатой гармониками волны — saw, square или pulse — с последующей фильтрацией и огибающими ADSR.

Реализация: несколько осцилляторов на голос, цифровой фильтр low-pass (например, biquad или state-variable filter), ADSR и опциональная LFO-модуляция.

Преимущества: очень широкий диапазон узнаваемых синтезаторных тембров при умеренных вычислительных затратах.

Сложность: средняя. Важно реализовать ограничение алиасинга при генерации пилообразных и прямоугольных волн — например, PolyBLEP или таблицы с band-limiting.

Почему нужен: сейчас в проекте нет универсального классического аналогового синтезатора.

## 4. Аддитивный синтез / Tonewheel Organ

Низкая сложность

Тембры: электроорган, церковный орган, мягкие синусоидальные тембры.

Звук формируется суммированием нескольких синусоид с частотами, кратными основной частоте. Для органа особенно удобна модель drawbars: уровни гармоник 1-й, 2-й, 3-й и последующих регулируются независимо.

Реализация: несколько фазовых аккумуляторов и таблица синуса. Для более точного Hammond-подобного характера можно добавить утечки между тональными колёсами и лёгкую модуляцию.

Преимущества: предсказуемая нагрузка, низкие требования к памяти, хорошая полифония.

Сложность: низкая–средняя.

Почему нужен: это принципиально другой способ построения тембра, чем FM, и он особенно подходит для аккордов.

## 5. Wavetable-синтез

Приоритет № 2

Тембры: цифровые синтезаторы, evolving pads, колокольные и стеклянные тембры, классические цифровые лиды.

Вместо вычисления сложной формы волны на каждом сэмпле используется заранее подготовленная таблица. Между таблицами можно плавно переключаться или интерполировать их для изменения тембра.

Реализация: фазовый аккумулятор, таблицы разных гармонических составов, интерполяция и ADSR. Для уменьшения алиасинга полезны таблицы с ограниченным спектром для разных диапазонов высоты ноты.

Преимущества: высокая производительность и возможность получить очень разные тембры без дорогих вычислений на каждом сэмпле.

Сложность: низкая–средняя для фиксированных таблиц, средняя для качественного морфинга.

Почему нужен: удобно получать десятки тембров на основе одного движка, не добавляя десятки отдельных алгоритмов.

## 6. Phase Distortion (фазовое искажение)

Тембры: цифровые басы, яркие лиды, колокольные звуки, ретро-тембры в духе Casio CZ.

Вместо прямого изменения амплитуды волны изменяется скорость прохождения фазового цикла. Это позволяет получать богатый спектр с относительно простой математикой.

Реализация: фазовый аккумулятор с нелинейным отображением фазы, несколько форм фазового преобразования и огибающая глубины искажения.

Преимущества: вычислительно лёгкий алгоритм, который хорошо дополняет существующий FM E-Piano.

Сложность: средняя.

Почему нужен: позволяет получить характерные цифровые тембры, не повторяя в точности FM.

## 7. Modal synthesis — модальное физическое моделирование

Тембры: маримба, ксилофон, колокольчики, металлические пластины, гонги.

Инструмент представляется набором резонансных мод — колебаний на определённых частотах с разными скоростями затухания. Каждая нота возбуждает эти резонансы коротким импульсом или шумом.

Реализация: несколько резонаторов второго порядка на голос, каждый с собственной частотой, коэффициентом затухания и амплитудой.

Преимущества: физически убедительные перкуссионные и колокольные тембры без больших PCM-сэмплов.

Сложность: средняя. Потребление CPU зависит от количества мод и полифонии.

Почему нужен: Pluck моделирует струну, а modal synthesis позволяет перейти к совершенно другим физическим объектам — деревянным и металлическим резонаторам.

## 8. PCM sample playback — воспроизведение сэмплов

Отдельный класс движка

Тембры: акустическое пианино, струнные, духовые, реалистичные гитары и готовые звуки ударных.

Воспроизводятся записанные образцы, подготовленные для отдельных нот или диапазонов нот, с изменением скорости воспроизведения и огибающими.

Реализация: таблица PCM, дробный указатель позиции, интерполяция, управление огибающей и, при необходимости, циклические участки sustain.

Преимущества: реалистичные инструменты, которых трудно добиться чистым алгоритмическим синтезом.

Сложность: низкая для простого воспроизведения, высокая для качественного мультисэмплинга, управления памятью и переключения между слоями velocity.

Почему нужен: открывает путь к значительно более широкому набору GM-подобных инструментов. Основной вопрос — где хранить образцы и как ограничить расход Flash/RAM.

## 3. Сравнение с точки зрения STM32H743

Оценки ниже качественные: фактическая нагрузка зависит от числа голосов, частоты дискретизации, количества осцилляторов и качества фильтрации.

| Алгоритм | CPU | RAM | Полифония | Главная ниша |
| --- | --- | --- | --- | --- |
| Subtractive | Средний | Низкая | Хорошая | Аналоговые синтезаторы |
| Additive / Organ | Низкий–средний | Низкая | Очень хорошая | Органы, аккорды |
| Wavetable | Низкий | Средняя | Очень хорошая | Универсальные цифровые тембры |
| Phase Distortion | Низкий–средний | Низкая | Хорошая | Цифровые лиды и басы |
| Modal synthesis  | Средний | Низкая–средняя | Зависит от числа мод | Колокольные и перкуссионные тембры |
| PCM samples | Низкий–средний | Зависит от хранения | Хорошая при достаточной пропускной способности памяти | Реалистичные инструменты |

На STM32H743 с аудиовыходом 48 кГц все эти направления технически реалистичны. Однако качество реализации и максимальное количество одновременно звучащих нот необходимо проверять измерениями на целевом устройстве.

## 4. Что я рекомендую реализовать первым

Первым — Subtractive Synth

Он добавит самый востребованный класс тембров: аналоговые басы, лиды и пэды. Заодно появится полноценная архитектура осцилляторов, фильтров и ADSR, пригодная для дальнейшего расширения.

Вторым — Wavetable

Он создаст основу для цифровых тембров и позволит добавлять новые звуки преимущественно данными, а не новыми реализациями DSP.

Третьим — Tonewheel Organ

Это относительно недорогой в реализации алгоритм с хорошей музыкальной отдачей. Его можно сделать на основе синусоидальных генераторов и переиспользовать часть инфраструктуры будущего аддитивного движка.

Четвёртым — Modal synthesis

Он добавит семейство ударных и колокольных инструментов, которое практически не пересекается с уже реализованными движками.

PCM я бы оставил на следующий этап: до его разработки стоит определить доступный бюджет памяти, формат хранения сэмплов и механизм загрузки инструментальных банков.

## 5. Как встроить новые алгоритмы в текущую архитектуру

Сейчас в [synth_engine.cpp](https://github.com/purrrock/purrmidi/blob/main/Engine/synth/synth_engine.cpp) используется статическая таблица из трёх движков. Она связывает имя инструмента с функциями `Init`, `NoteOn`, `NoteOff`, `ControlChange` и `FillStereoBuffer`. Общий контракт уже позволяет добавлять новые алгоритмы без изменения MIDI-тракта.

Для каждого нового движка потребуется:

1. Создать отдельные `*_synth.h` и `*_synth.cpp` либо `.c`.

2. Реализовать все функции общего интерфейса, включая обработку MIDI CC и заполнение стереобуфера.

3. Добавить новый идентификатор в `SynthEngineId` и запись в `kEngines`.

4. Обновить тесты рендеринга на ПК: частота основной ноты, поведение Note Off, отсутствие NaN/Inf и клиппинга, корректность стереовыхода.

5. Проверить максимальное время обработки аудиоблока на STM32, особенно при максимальной полифонии.

Есть один важный архитектурный момент: в текущем коде номер MIDI-программы преобразуется по модулю `SYNTH_ENGINE_COUNT`. При добавлении инструментов это поведение сохранится, но нумерацию стоит согласовать с предполагаемым управлением Next/Previous и MIDI Program Change. Если в будущем потребуется полноценный набор General MIDI, простого циклического выбора между алгоритмами будет недостаточно — понадобится таблица пресетов, где несколько программ могут ссылаться на один движок с разными параметрами.

Итог: я бы начал с субтрактивного синтеза, затем добавил wavetable и орган. Эти три направления дадут наиболее полезное расширение тембров при контролируемой сложности и позволят в дальнейшем развивать движок без необходимости писать отдельный DSP-алгоритм для каждого инструмента.
