purrrock/purrmidi/docs/STM32H743VIT6/PCB_sizes.pdf

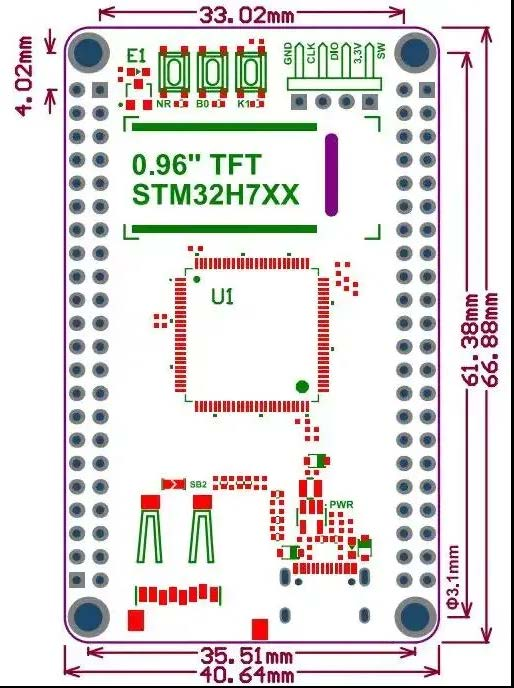
[picture p4: page 1]
