purrrock/purrmidi/OLD_NUCLEO_FILES/README.md

# PurrMidi
**PurrMidi** — экспериментальный автономный MIDI-синтезатор на базе STM32.
Цель проекта — создать компактный аппаратный MIDI-модуль (sound module): подключить USB MIDI-клавиатуру, генерировать звук силами микроконтроллера и выводить его через внешний аудио ЦАП.
Основное направление - качественный звук фортепиано.
Проект развивается как практический embedded-аудио проект с постепенным переходом от простого прототипа к полноценному полифоническому синтезатору.

## Аппаратное обеспечение

### Текущий прототип
* **Микроконтроллер (MCU):***WeAct STM32H743VIT6**
* **Аудио ЦАП (DAC):** PCM5102A (стереовыход, аудиоинтерфейс I2S).
* **MIDI-вход:** USB MIDI-клавиатура.

## Архитектура программного обеспечения и звуковой тракт
Разработка ведётся инкрементально: каждый аппаратный блок сначала тестируется отдельно, а затем интегрируется в синтезатор. Проект задуман достаточно компактным, чтобы его можно было понимать и модифицировать на уровне прошивки без использования громоздких внешних фреймворков.
Прошивка разделяет аппаратно-зависимый код и сам движок синтезатора. Движок не должен напрямую зависеть от API периферии STM32, что позволит разрабатывать и тестировать его независимо от конечного микроконтроллера.

**Основной тракт прохождения сигнала:**
1. Подключение с USB MIDI-клавиатуры.
2. Драйвер USB MIDI и парсер MIDI-событий.
3. Движок синтезатора и аудиомикшер.
4. Заполнение буфера цифровых PCM-сэмплов.
5. Передача данных через периферию I2S с использованием DMA.
6. Внешний аудио ЦАП PCM5102A.
7. Вывод аналогового звука на наушники или колонки.

Использование DMA для непрерывной потоковой передачи аудио позволяет освободить процессор от необходимости ручной отправки каждого сэмпла.

## План разработки
Проект развивается поэтапно.

### Этап 1 — Аппаратный запуск (Hardware bring-up)
* [ ] Базовая настройка прошивки и тактирования STM32H743VIT6.
* [ ] Отладочный UART.
* [ ] Вход USB MIDI и парсер MIDI-сообщений.
* [ ] Подключение PCM5102A и интерфейса I2S.
* [ ] Генерация тестового тона.
* [ ] Воспроизведение тестового тона через PCM5102A.

### Этап 2 — Базовый синтезатор
* [ ] Обработка MIDI-событий Note On / Note Off.
* [ ] Один осциллятор и выбор базовых форм волны.
* [ ] Несколько одновременных голосов.
* [ ] Огибающая ADSR.
* [ ] Регулировка общей громкости (Master volume).
* [ ] Воспроизведение звука на базе аудиобуфера и DMA.

### Этап 3 — Полноценный инструмент
* [ ] Полифония.
* [ ] Обработка скорости нажатия клавиш (Velocity).
* [ ] Изменение высоты тона (Pitch bend).
* [ ] Поддержка педали сустейна.
* [ ] Поддержка послекасания.
* [ ] Обработка MIDI Control Change.
* [ ] Пресеты.

* [ ] Управление с помощью кнопок и светодиодная индикация.

### Этап 4 — Звуковой движок
Возможные технологии синтеза:
* Субтрактивный синтез.
* Таблично-волновой синтез (wavetable).
* Воспроизведение сэмплов.
* Цифровые фильтры, генераторы низкой частоты (LFO), модуляция и эффекты.

Точная архитектура звукового движка будет зависеть от возможностей целевого микроконтроллера и требований к звучанию.

## Текущий статус
**Ранняя стадия разработки.**
Текущий приоритет — проверка аппаратной части и создание минимально работающего тракта: клавиатура → микроконтроллер → тон → I2S → ЦАП → звук. Как только этот базовый путь заработает надёжно, начнётся постепенная разработка движка синтезатора.

## Репозиторий
Исходный код проекта: github.com/purrrock/purrmidi
