purrrock/purrmidi/docs/NUCLEO-F446RE/front.jpg

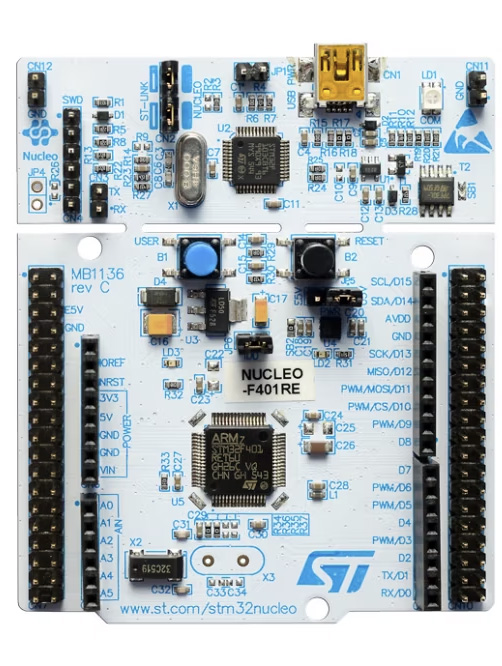
docs/NUCLEO-F446RE/front.jpg
