purrrock/purrmidi/docs/NUCLEO-F446RE/nucleo-f446re pinout.png

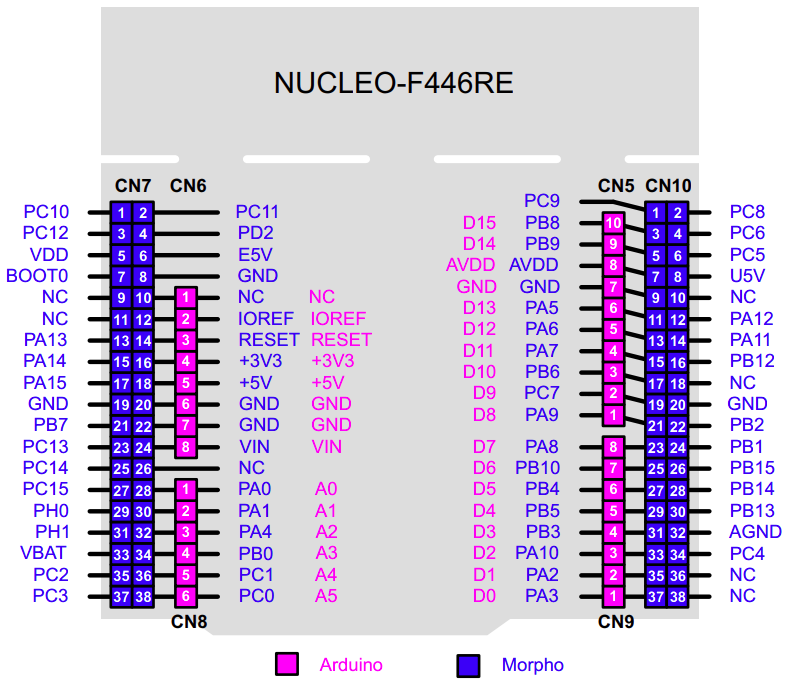
docs/NUCLEO-F446RE/nucleo-f446re pinout.png
