purrrock/purrmidi/docs/PCM5102 board sizes.png

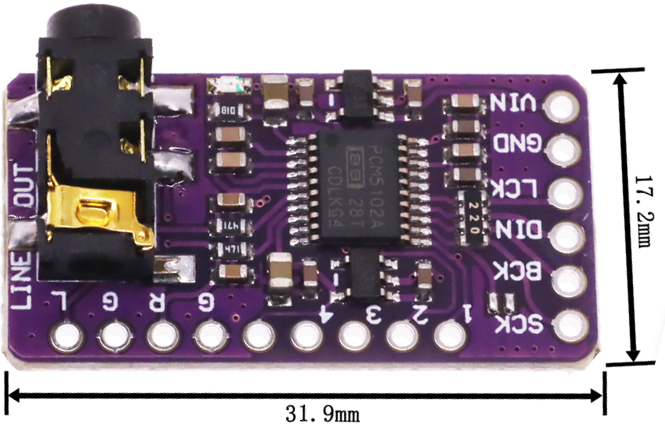
docs/PCM5102 board sizes.png
