purrrock/purrmidi/docs/PCM5102.webp

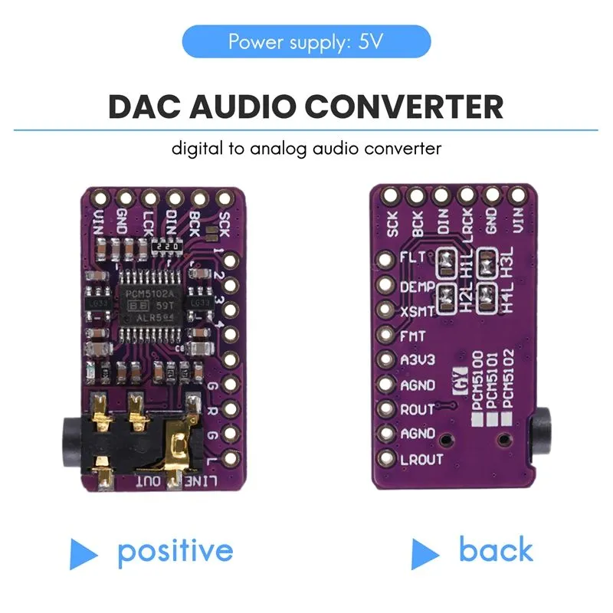
docs/PCM5102.webp
