purrrock/purrmidi/docs/STM32H743VIT6/WeAct_STM32H743VIT6_mini.png

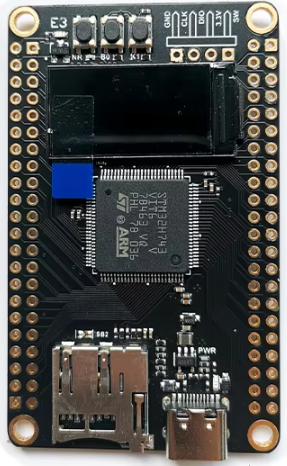
docs/STM32H743VIT6/WeAct_STM32H743VIT6_mini.png
