purrrock/purrmidi/docs/STM32H743VIT6/WeActStudio_Mini_STM32H7xx_pinout.png

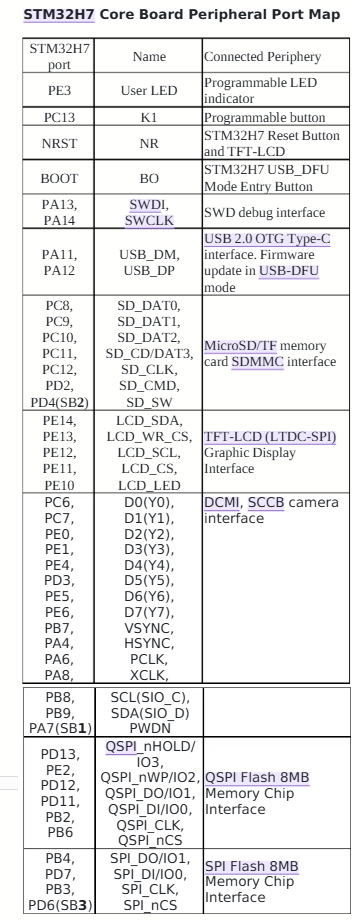
docs/STM32H743VIT6/WeActStudio_Mini_STM32H7xx_pinout.png
