purrrock/purrmidi/enclosure/preview_layout_top.png

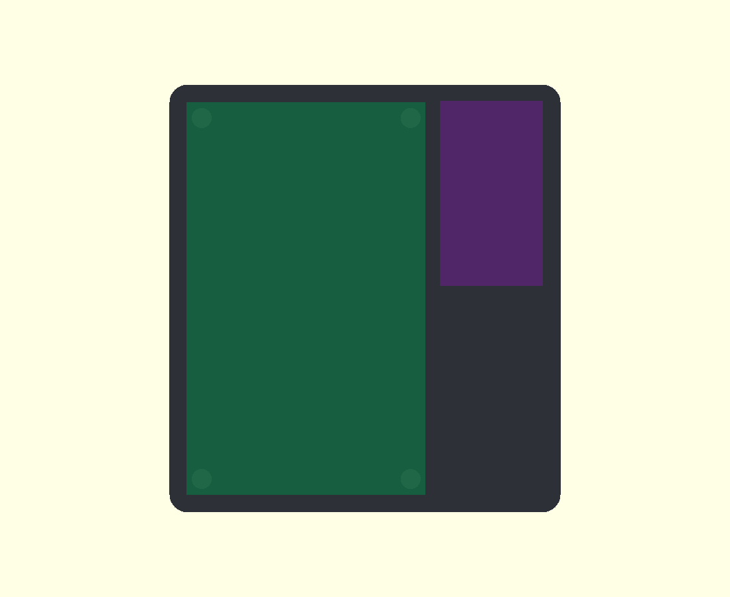
enclosure/preview_layout_top.png
