purrrock/purrmidi/enclosure/WeAct MiniH7 box - 4940529/images/MiniSTM32H7xx_box_bottom.png

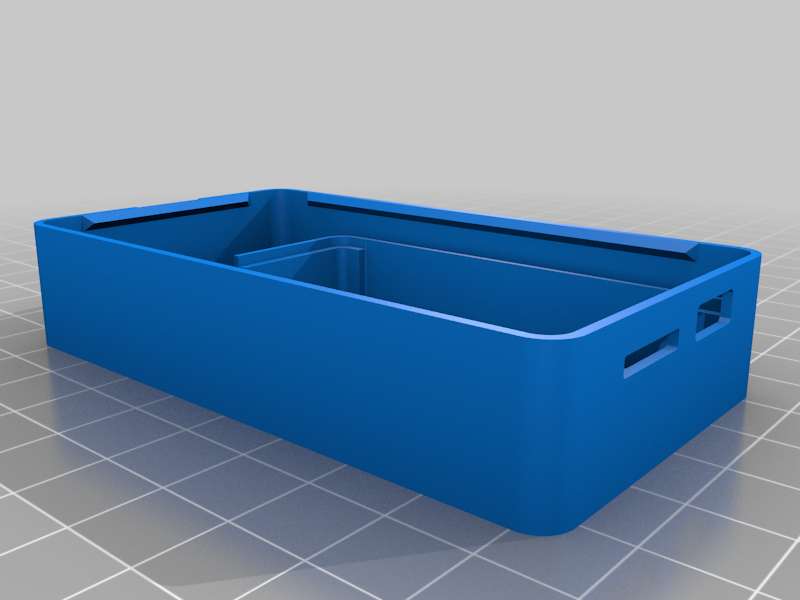
enclosure/WeAct MiniH7 box - 4940529/images/MiniSTM32H7xx_box_bottom.png
