purrrock/purrmidi/site/og-image.png

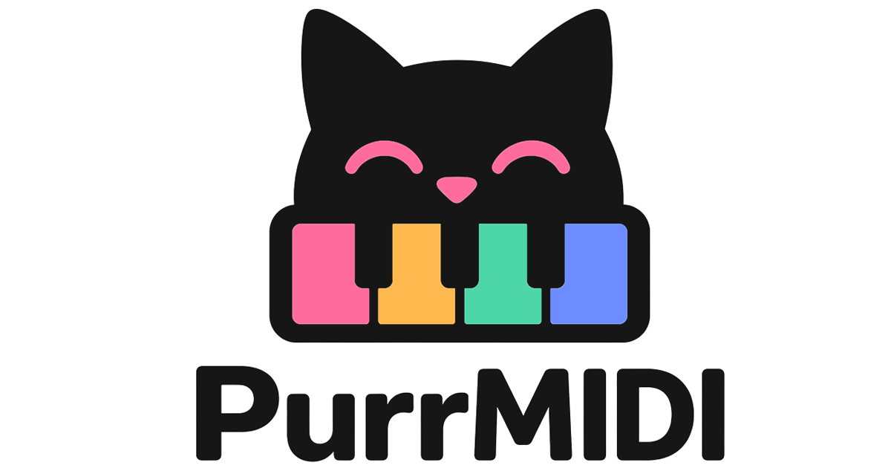
site/og-image.png
