purrrock/purrmidi/site/PCM5102.webp

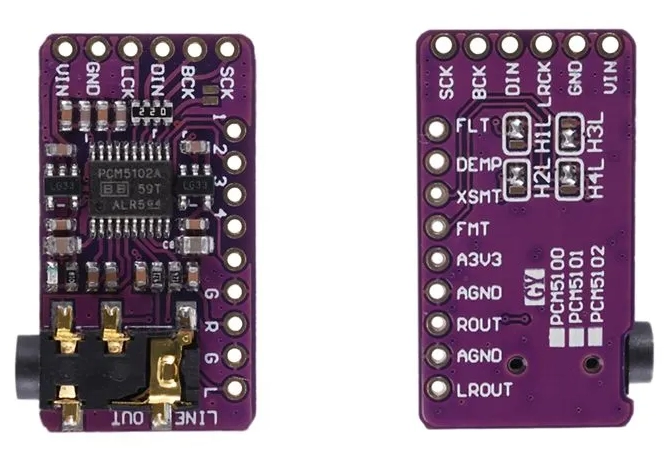
site/PCM5102.webp
