purrrock/purrmidi/site/PurrMIDI_without_enclosure.png

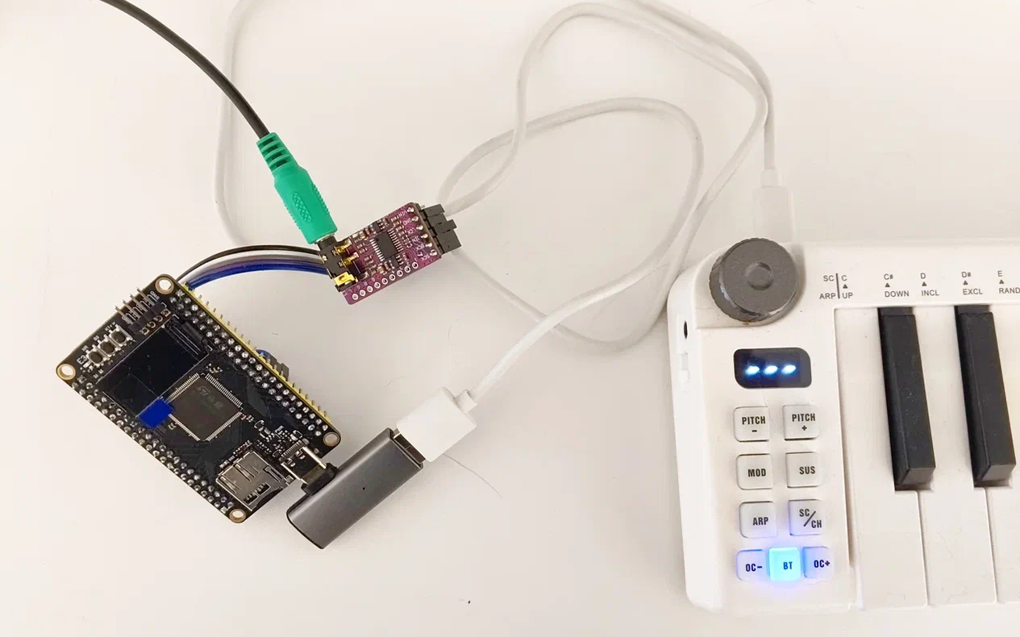
site/PurrMIDI_without_enclosure.png
