purrrock/purrmidi/enclosure/MiniSTM32H7xx_box_top_dac.stl

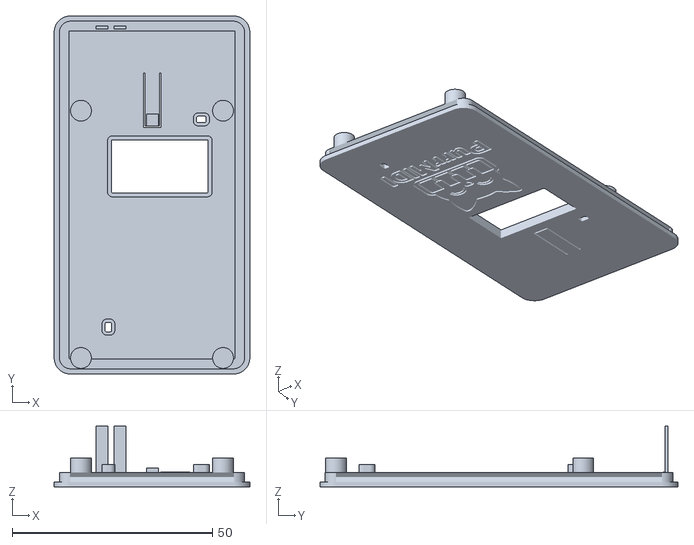
[picture p17: CAD file, 2026-10-23]
enclosure/MiniSTM32H7xx_box_top_dac.stl
48.8 x 89.3 x 15.1
