purrrock/purrmidi/enclosure/WeAct MiniH7 box - 4940529/files/MiniSTM32H7xx.stl

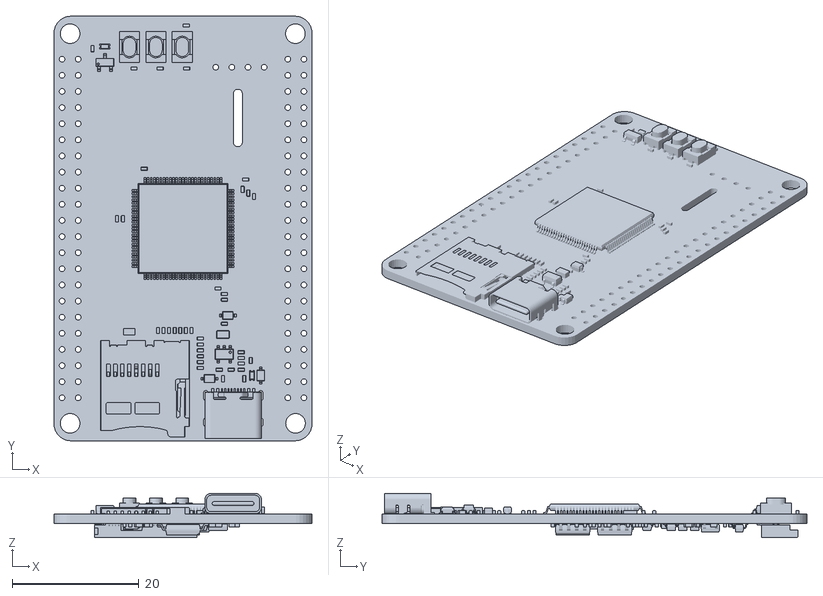
[picture p18: CAD file, 2026-10-23]
enclosure/WeAct MiniH7 box - 4940529/files/MiniSTM32H7xx.stl
40.6 x 66.9 x 6.98
