purrrock/purrmidi/enclosure/MiniSTM32H7xx_box_bottom_dac.stl

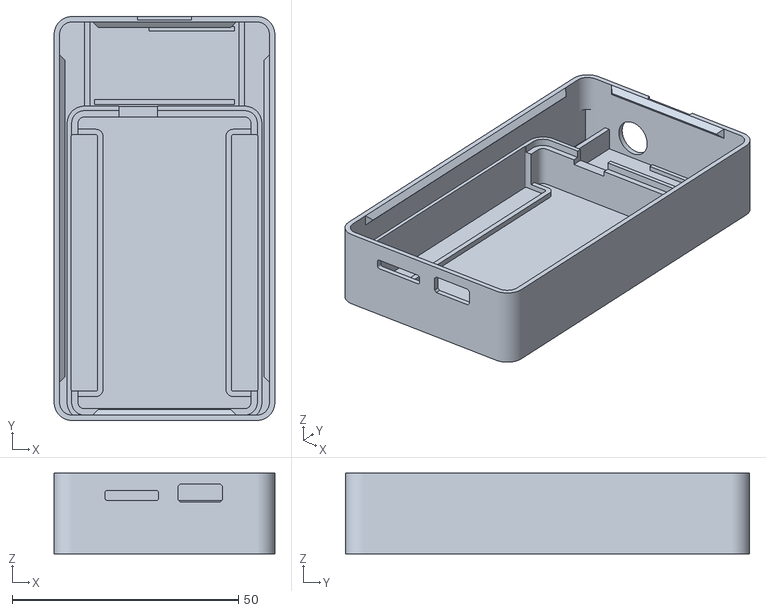
[picture p19: CAD file, 2026-10-22]
enclosure/MiniSTM32H7xx_box_bottom_dac.stl
48.8 x 89.3 x 17.8
