purrrock/purrmidi/enclosure/MiniSTM32H7xx_box_bottom_closed.stl

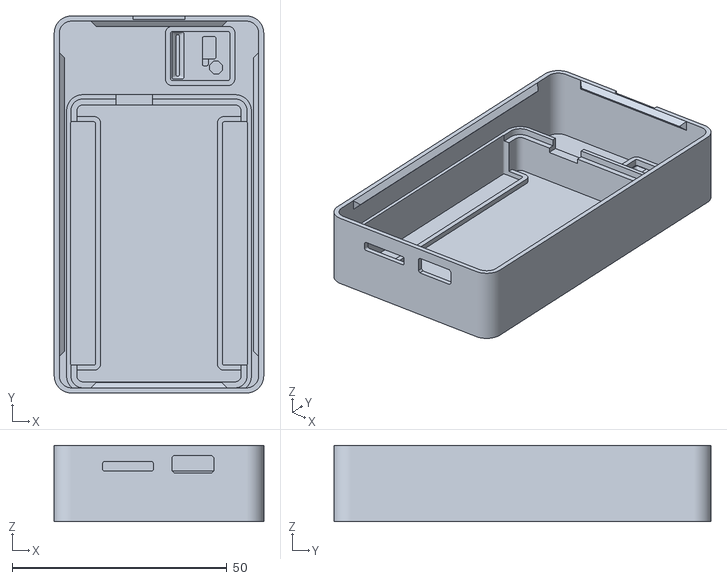
[picture p21: CAD file, 2026-10-22]
enclosure/MiniSTM32H7xx_box_bottom_closed.stl
48.8 x 87.8 x 17.8
