purrrock/purrmidi/enclosure/WeAct MiniH7 box - 4940529/files/MiniSTM32H7xx_box_bottom.stl

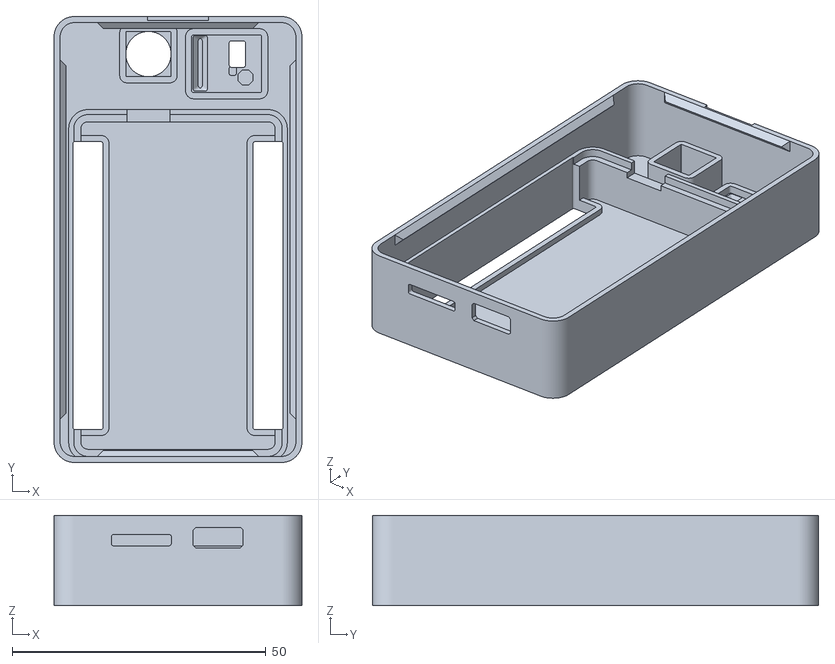
[picture p22: CAD file, 2026-10-22]
enclosure/WeAct MiniH7 box - 4940529/files/MiniSTM32H7xx_box_bottom.stl
48.8 x 87.8 x 17.8
