purrrock/purrmidi/enclosure/PCM5102_DAC_top.stl

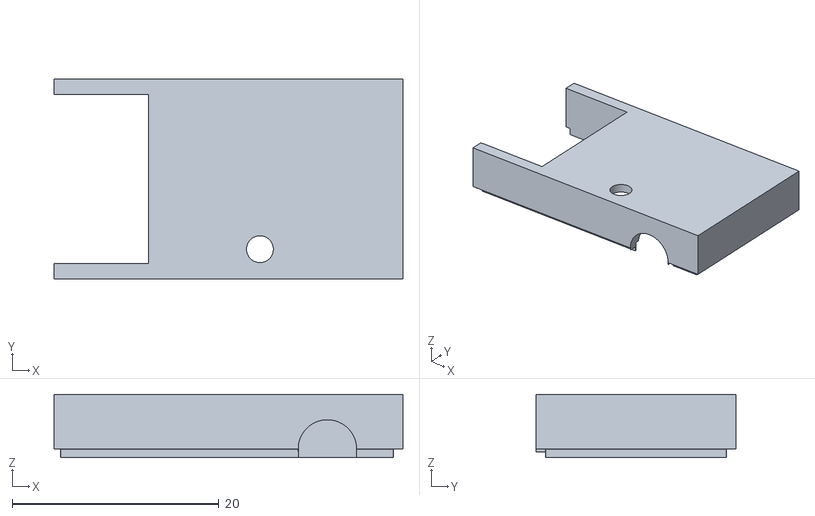
[picture p23: CAD file, 2026-10-22]
enclosure/PCM5102_DAC_top.stl
33.7 x 19.4 x 6.10
