purrrock/purrmidi/enclosure/PCM5102_DAC_bottom.stl

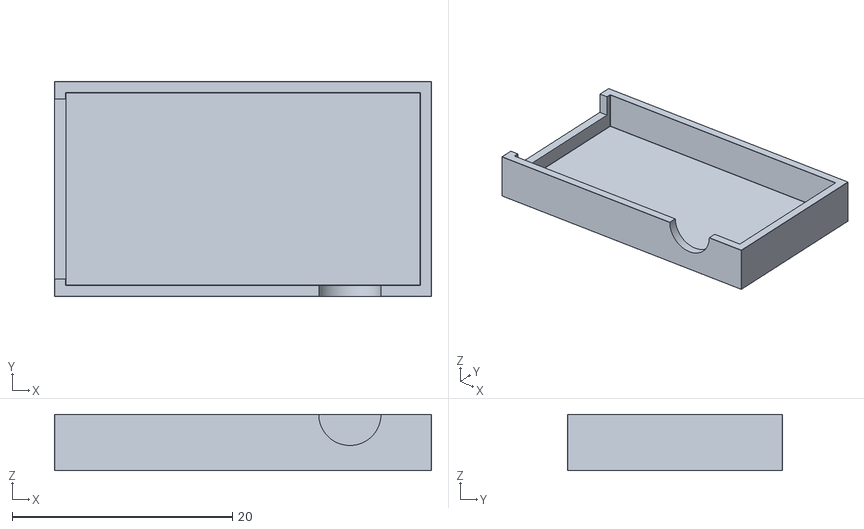
[picture p24: CAD file, 2026-10-22]
enclosure/PCM5102_DAC_bottom.stl
34.3 x 19.6 x 5.12
