purrrock/purrmidi/enclosure/box_esp32S3zero_pcm1502A.stl

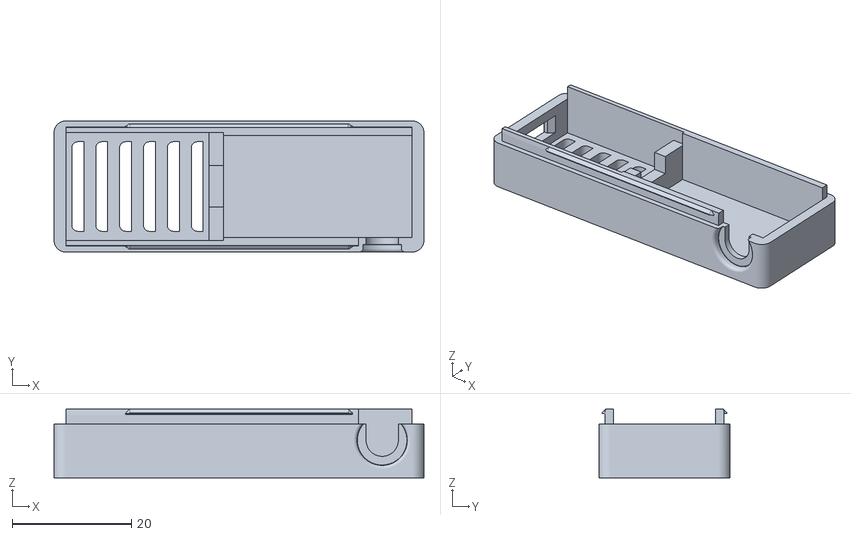
[picture p25: CAD file, 2026-10-22]
enclosure/box_esp32S3zero_pcm1502A.stl
62.0 x 22.0 x 11.5
