purrrock/purrmidi/enclosure/lid_esp32S3zero_pcm1502A.stl

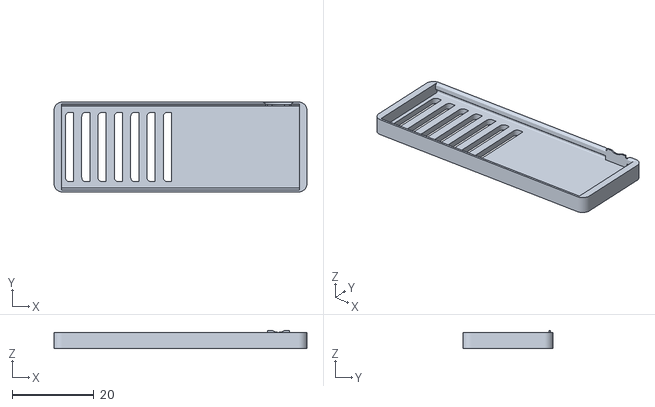
[picture p26: CAD file, 2026-10-22]
enclosure/lid_esp32S3zero_pcm1502A.stl
62.0 x 22.0 x 4.50
