purrrock/purrmidi/enclosure/k1_cap.stl

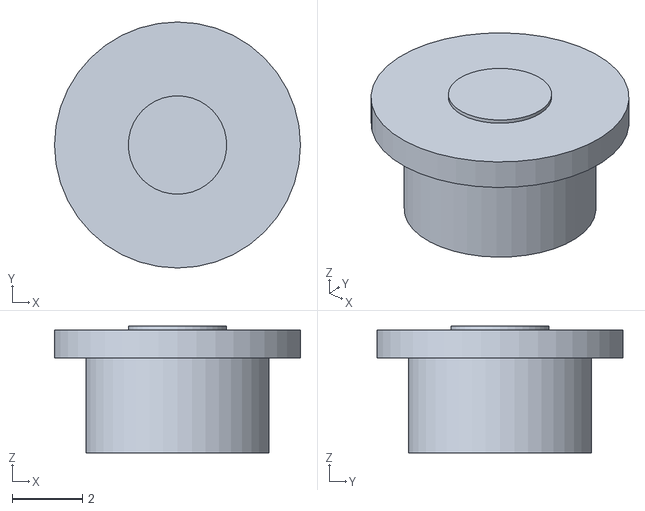
[picture p27: CAD file, 2026-10-21]
enclosure/k1_cap.stl
7.00 x 7.00 x 3.60
