purrrock/purrmidi/enclosure/lid.stl

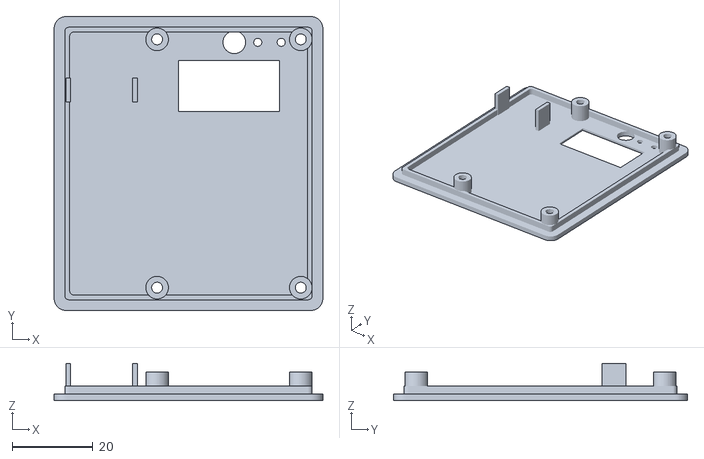
[picture p28: CAD file, 2026-10-21]
enclosure/lid.stl
66.4 x 72.7 x 9.20
