purrrock/purrmidi/enclosure/base.stl

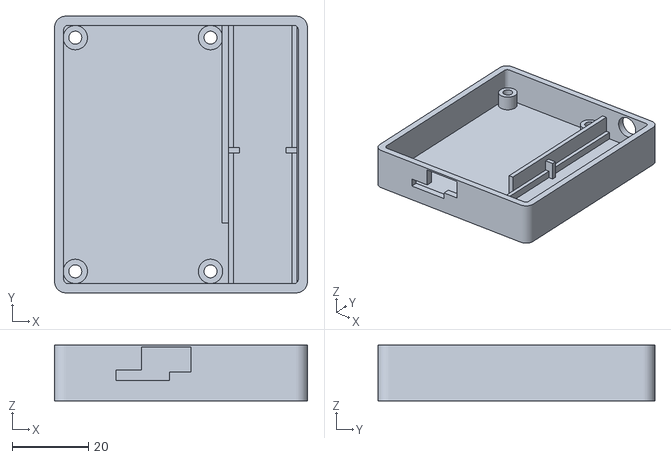
[picture p29: CAD file, 2026-10-21]
enclosure/base.stl
66.4 x 72.7 x 14.7
