purrrock/purrmidi/(list of files, cad)

Other CAD files:
enclosure/STM32H7xx CoreBoard WeAct Studio V12 3D.step
enclosure/PurrMIDI_enclosure.STL
