purrrock/purrmidi/enclosure/preview_assembly.png

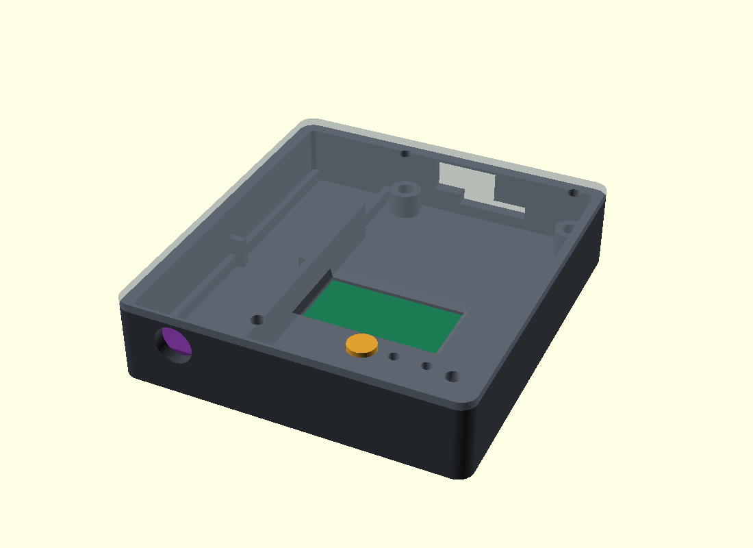
enclosure/preview_assembly.png
