purrrock/purrmidi/TODO.md

# TODO

## Тестирование и проверка на железе

- [ ] **P1. Пройти `docs/BOARD_CHECKLIST.md` на плате** перед тем, как считать текущее состояние готовым: в Release выключена
  диагностика, арена голосов уменьшена до 72 КБ, `Error_Handler()` теперь перезапускает прибор.
- [ ] **P1. Проверить на плате раздел 6 `docs/BOARD_CHECKLIST.md`** (плотные аккорды Organ и SoundFont после `AutoGain` и
  регулятора нагрузки). Для SoundFont пришлите строки `[SF2] 1s: ...`: в них число голосов, регионов на ноту и время обработки
  событий. Без них порог `SF2_EVENT_BUDGET_PCT` и цену старта голоса можно только оценивать.
- [ ] **P2. SoundFont: узнать, чем стоит голос.** Измеренная нагрузка (1,4–1,7 мс на 4–5 клавиш, то есть порядка 300 тактов на
  голос на отсчёт) заметно выше ожидаемой для линейной интерполяции с биквадом. Кандидаты после замеров: чтение банка из
  QSPI (частота QSPI 80 МГц, промахи кэша на 32-байтную строку), фильтр `tsf_voice_lowpass_process` в `double`, старт голоса
  с десятками `pow`/`tan`/`log10` в `double` (кэшировать или заменить на `float`). Менять только после цифр, звук трогать нельзя.
  План после замеров (по `Review.md`, с поправками): `double` заменять на `float` **точечно**, а не везде. Он есть только
  в сторонней `TinySoundFont` (`Middlewares/Third_Party/TinySoundFont/tsf.h`), а в собственном коде движков уже `float`.
  Кандидаты на `float`: расчёт старта голоса (`pow`/`tan`/`log10`) и `tsf_voice_lowpass_process`. **Не** трогать
  `sourceSamplePosition` и `pitchRatio`: во `float` (24 бита мантиссы) позиция в длинном сэмпле теряет дробную часть, и
  питч начинает «плыть». Любое изменение `tsf.h` оформлять отдельным патчем и вносить в `THIRD_PARTY_NOTICES.md`; проверять
  `test_engine_golden` и на слух. Если после замеров узким местом окажется внутренний цикл рендера, проверить запас ITCM
  (64 КБ, сейчас там код органа) и вынести в него цикл `tsf_voice_render`, как уже сделано для органа.

## Надёжность и диагностика сбоев

- [ ] **P2. Постоянная запись о сбое (post-mortem) вместо «тихого» ребута.** Сейчас `Error_Handler()` и fault-обработчики
  печатают `LR`/регистры в UART3 и перезапускают прибор; на самом приборе, без UART, причину увидеть нельзя. Сделать: при
  сбое записывать в отдельную `NOLOAD`-секцию (magic, версия, тип сбоя, `PC`/`LR`, `CFSR`/`HFSR`, счётчик) и показывать
  короткий код на TFT после перезапуска (плюс в UART). Включить в запись также сброс по IWDG (флаги `RCC->RSR`).
  Ограничения: `ram_init.c` обнуляет AXI SRAM и D2 SRAM целиком, поэтому секцию нужно размещать в DTCM или SRAM4
  (RAM_D3), вне `.bss`; после включения питания (POR/BOR) содержимое случайное и без ECC-инициализации чтение может дать
  ошибку шины, поэтому при POR/BOR сначала записать область нулями 32-битными словами и только после программного сброса
  читать и проверять magic+CRC. «Восстановление без ребута» для `Error_Handler()` из `MX_*_Init()` не имеет смысла: это
  ошибки инициализации, звука там ещё нет (SD уже обрабатывается отдельно, см. `sd_storage.c`).
- [ ] **P3. Стресс-тест «128 нот».** Для каждого движка (включая SoundFont) подать на `SynthEngine` одновременно 128 Note On
  (и отдельно через `midi_queue`, где лимит 28 из 32 слотов), затем несколько блоков рендера: проверить отсутствие
  NaN/inf, пик не выше потолка `SoftLimit`/`AutoGain`, отсутствие падений под ASan/UBSan, а после `All Notes Off`
  возврат к тишине и к исходному состоянию `SynthArena`. Сейчас отдельных тестов на `SynthArena` под такой нагрузкой нет
  (есть лимиты очереди в `test_synth_common.cpp` и переполнение в `test_organ_host.cpp`).

## Функциональность и UX

- [ ] **P2. Запоминать выбор при выключении питания.** Сейчас после включения всегда стартует E-Piano. Сохранять: движок,
  номер пресета SoundFont и master-громкость. Варианты хранилища: последний сектор внутренней Flash (128 КБ; лог из записей
  с CRC, чтобы не изнашивать сектор; запись не раньше чем через 1–2 с после последнего изменения и не во время игры;
  проверить, что стирание не останавливает аудио, т. к. код исполняется из Flash) или резервный сектор QSPI. Backup SRAM
  годится, только если на VBAT есть батарейка (на плате WeAct её, как правило, нет), иначе содержимое пропадёт с
  питанием. Учесть, что клавиатура может сама слать CC7 при подключении и перезаписывать сохранённую громкость.
