purrrock/purrmidi/docs/FAQ.md

# Вопросы и ответы

Ответы на самые частые вопросы по сборке и использованию PurrMIDI. Если ответа нет, расскажите о проблеме в [Issues](https://github.com/purrrock/purrmidi/issues/new/choose): какая клавиатура, что показывает дисплей и что выводит UART (если у вас есть USB-UART адаптер).

* [Клавиатура не определяется](#клавиатура-не-определяется)
* [Нет звука](#нет-звука)
* [Звук искажён или громко шумит](#звук-искажён-или-громко-шумит)
* [Как поменять SoundFont](#как-поменять-soundfont)
* [SoundFont не загружается](#soundfont-не-загружается)
* [Как переключать инструменты, если клавиатура не умеет Program Change](#как-переключать-инструменты-если-клавиатура-не-умеет-program-change)
* [Инструмент и громкость не запоминаются](#инструмент-и-громкость-не-запоминаются)
* [Красная плашка с кодом ошибки](#красная-плашка-с-кодом-ошибки)
* [Что умеет и чего нет](#что-умеет-и-чего-нет)

## Клавиатура не определяется

Точка в шапке дисплея показывает состояние: **серая** — клавиатуры нет, **жёлтая** — идёт определение, **зелёная** — готово.

1. **Питание клавиатуры.** Плата не подаёт 5 В на разъём USB (см. [HARDWARE.md](HARDWARE.md#usb-midi-host)), поэтому клавиатуре нужно внешнее питание. Если плата и клавиатура питаются от одного USB-источника, используйте Y-разветвитель.
2. **Кабель.** Нужен кабель с передачей данных, не «только для зарядки».
3. **Клавиатура должна быть USB MIDI.** Устройства с обычным MIDI-разъёмом (DIN) не подходят, это пока не поддерживается.
4. Отключите и снова подключите клавиатуру. Если точка остаётся жёлтой больше 5 секунд, появится ошибка E01 (см. [таблицу ниже](#красная-плашка-с-кодом-ошибки)).
5. Если клавиатура всё равно не работает, сообщите в Issues её модель. Известные работающие модели: NTK-61, SMK-25.

## Нет звука

1. **Перемычка H3L (XSMT) на PCM5102A должна быть замкнута на H.** Без этого ЦАП остаётся в режиме Mute.
2. **Перемычка SCK на лицевой стороне модуля** должна быть замкнута: она подаёт на ЦАП такт, который STM32 не выводит.
3. Проверьте подключение: PE6 → DIN, PE5 → BCK, PE4 → LCK, питание 3,3 В и общая земля. Таблица — в [HARDWARE.md](HARDWARE.md#аудио-цап-pcm5102a).
4. Проверьте громкость (CC7) на клавиатуре: при значении `0` звука нет.
5. Убедитесь, что выбран инструмент, который доступен. Если выбран SoundFont, а банк не загружен, появится ошибка E06 и звука не будет. Переключитесь на E-Piano кнопкой K1.
6. Проверьте наушники или усилитель: подключены ли они к выходам L/R модуля ЦАП.

## Звук искажён или громко шумит

Самая частая причина — перемычка **H4L (FMT)** замкнута на H. Для формата I2S она должна быть замкнута на **L**. Остальные перемычки: H1L (FLT) → L, H2L (DEMP) → L, H3L (XSMT) → H. Подробности — в [HARDWARE.md](HARDWARE.md#перемычки-на-плате-pcm5102a).

Если звук искажается только на плотных аккордах, возможно, не хватает вычислительного времени. Это показывает ошибка E05 (см. [таблицу](#красная-плашка-с-кодом-ошибки)).

## Как поменять SoundFont

1. Назовите файл **`SNDFNT.SF2`** и положите его в корень карты microSD (FAT32).
2. Размер не более **8 384 512 байт**. Если больше, уменьшите банк онлайн-инструментом на сайте, скриптом `SoundFonts/sf2_shrink.py` или бесплатной программой Polyphone.
3. Вставьте карту и включите прибор. Запись во флеш занимает 30–60 секунд, ход виден на дисплее.
4. Когда прибор заработает, карту можно вынуть: во время игры она не нужна.

Подробности — в [SOUNDFONT.md](SOUNDFONT.md).

## SoundFont не загружается

* Проверьте имя файла: ровно `SNDFNT.SF2` и в **корне** карты, не в папке.
* Карта должна быть отформатирована в **FAT32**.
* Размер файла не больше 8 384 512 байт.
* Если банка нет ни на карте, ни во флеш-памяти, пресеты SoundFont недоступны, а остальные пять инструментов работают как обычно.
* Подробные причины отказа выводятся в UART (строки `[SF2]`, `[SD]`, `[QSPI]`), см. раздел «Диагностика» в [SOUNDFONT.md](SOUNDFONT.md#диагностика).

## Как переключать инструменты, если клавиатура не умеет Program Change

Нажимайте кнопку **K1** на плате: она переключает на следующий инструмент по кругу (так же работает Program Change `127`). Порядок: E-Piano → Pluck → Lead → Organ → Violin → пресеты SoundFont → снова E-Piano.

## Инструмент и громкость не запоминаются

Выбранный инструмент и громкость хранятся в резервных регистрах RTC. Без батарейки они переживают только перезапуск, но не отключение питания. Чтобы они сохранялись, поставьте 3 В батарейку (например, CR2032) на вывод VBAT, см. [HARDWARE.md](HARDWARE.md#батарейка-vbat-необязательно). Без неё после включения всегда запускается E-Piano.

## Красная плашка с кодом ошибки

Красная плашка в шапке дисплея показывает код ошибки.

| Код | Текст | Что значит и что делать |
| --- | ----- | --- |
| E01 | USB ENUM FAIL | Клавиатура не определилась за 5 секунд. Проверьте внешнее питание клавиатуры и кабель, переподключите клавиатуру. |
| E02 | AUDIO DMA ERROR | Сбой аудиотракта. Гаснет через 3 секунды. Если повторяется, проверьте питание платы и сообщите в Issues. |
| E03 | MIDI QUEUE FULL | Очередь MIDI-событий переполнена. Гаснет через 3 секунды. Обычно возникает при очень плотном потоке событий. |
| E04 | USB RX ERROR | Ошибка приёма по USB. Гаснет через 3 секунды. Попробуйте другой кабель, переподключите клавиатуру. |
| E05 | AUDIO OVERLOAD | Прибор не успевает рассчитать звук (много голосов), часть блоков заменена тишиной. Гаснет через 3 секунды. Играйте с меньшим числом одновременных нот или выберите другой инструмент. |
| E06 | SF2 NOT LOADED | Выбран SoundFont, но банк не загружен. Проверьте карту и файл `SNDFNT.SF2` (см. выше) или переключитесь на другой инструмент. |

## Что умеет и чего нет

**Умеет:** работать как USB Host с USB MIDI-клавиатурой; шесть звуковых движков (E-Piano, Pluck, Lead, Organ, Violin, SoundFont); показывать ноты, аккорды и инструмент на дисплее; запоминать инструмент и громкость (с батарейкой на VBAT).

**Пока не умеет:**

* отправлять MIDI на компьютер (USB-MIDI в сторону ПК);
* принимать MIDI через разъём DIN;
* записывать игру;
* питать клавиатуру по USB (нужно внешнее питание).

Планы развития — в [ROADMAP.md](../ROADMAP.md).
