purrrock/purrmidi/PurrMidi.ioc

Mcu.UserName=STM32H743VITx
PA11.Signal=USB_OTG_FS_DM
PA12.Signal=USB_OTG_FS_DP
PA8.Signal=USB_OTG_FS_SOF
PA9.Signal=USB_OTG_FS_VBUS
PB10.Signal=USART3_TX
PB11.Signal=USART3_RX
PB2.Signal=QUADSPI_CLK
PB6.Signal=QUADSPI_BK1_NCS
PC10.Signal=SDMMC1_D2
PC11.Signal=SDMMC1_D3
PC12.Signal=SDMMC1_CK
PC13.GPIO_Label=USER_KEY_K1
PC13.Signal=GPIO_Input
PC8.Signal=SDMMC1_D0
PC9.Signal=SDMMC1_D1
PD11.Signal=QUADSPI_BK1_IO0
PD12.Signal=QUADSPI_BK1_IO1
PD13.Signal=QUADSPI_BK1_IO3
PD2.Signal=SDMMC1_CMD
PE10.GPIO_Label=LCD_BL
PE10.Signal=GPIO_Output
PE11.GPIO_Label=LCD_CS
PE11.Signal=GPIO_Output
PE12.Signal=SPI4_SCK
PE13.GPIO_Label=LCD_DC
PE13.Signal=GPIO_Output
PE14.Signal=SPI4_MOSI
PE2.Signal=QUADSPI_BK1_IO2
PE3.GPIO_Label=DEBUG_LED
PE3.Signal=GPIO_Output
PE4.Signal=SAI1_FS_A
PE5.Signal=SAI1_SCK_A
PE6.Signal=SAI1_SD_A
