purrrock/purrmidi/Core/Inc/main.h

#define DEBUG_LED_Pin GPIO_PIN_3
#define DEBUG_LED_GPIO_Port GPIOE
#define USER_KEY_K1_Pin GPIO_PIN_13
#define USER_KEY_K1_GPIO_Port GPIOC
#define LCD_BL_Pin GPIO_PIN_10
#define LCD_BL_GPIO_Port GPIOE
#define LCD_CS_Pin GPIO_PIN_11
#define LCD_CS_GPIO_Port GPIOE
#define LCD_DC_Pin GPIO_PIN_13
#define LCD_DC_GPIO_Port GPIOE
