purrrock/purrmidi/Platform/display/display.c

#include "display.h"
#include "chord_detector.h"

#include "main.h"
#include "stm32h7xx_hal.h"

#include "st7735.h"
#include "font_ascii.h"
#include "splash_logo.h"   /* логотип заставки (tools/gen_splash_logo.py) */
#include "version.h"

#include <stdio.h>
#include <string.h>

/* ------------------------------------------------------------------------- */
/* Hardware                                                                  */
/* ------------------------------------------------------------------------- */

#define DISPLAY_WIDTH   160U
#define DISPLAY_HEIGHT   80U

#define LCD_CS_PORT      GPIOE
#define LCD_CS_PIN       GPIO_PIN_11

#define LCD_DC_PORT      GPIOE
#define LCD_DC_PIN       GPIO_PIN_13

#define LCD_BL_PORT      GPIOE
#define LCD_BL_PIN       GPIO_PIN_10

/* Подсветка на этой плате включается низким уровнем */
#define LCD_BL_ON        GPIO_PIN_RESET
#define LCD_BL_OFF       GPIO_PIN_SET

extern SPI_HandleTypeDef hspi4;

/* 1 = поле canvas уходит на панель через DMA (SPI4_TX, DMA1_Stream0), процессор не ждёт ~5,5 мс на поле.
 * 0 = прежний блокирующий вывод построчно (для отладки). */
#define DISPLAY_USE_DMA 1

static ST7735_Object_t st7735;
static ST7735_Ctx_t st7735_ctx;
static bool display_ready = false;   /* true только после успешной инициализации */
static bool splash_active = false;   /* заставка на экране: Display_Task() не рисует интерфейс поверх неё */

/* ------------------------------------------------------------------------- */
/* Layout / palette                                                          */
/* ------------------------------------------------------------------------- */

#define HDR_Y        0U
#define HDR_H       14U
#define INS_Y       16U
#define INS_H       16U
#define NOTE_Y      34U
#define NOTE_H      32U
#define VOL_Y       67U
#define VOL_H       13U

#define DOT_X        3U
#define DOT_Y        3U
#define DOT_SIZE     7U

#define MIN_DRAW_INTERVAL_MS   10U   /* пауза между отрисовками полей        */
#define ERROR_TIMEOUT_MS     3000U   /* время показа "временной" ошибки      */
#define ENUM_TIMEOUT_MS      5000U   /* энумерация дольше этого -> E01       */
#define CC_TOAST_MS          1200U   /* сколько держится подсказка CC/педали  */

#define RGB565(r, g, b) \
    ((uint16_t)((((r) & 0xF8U) << 8) | (((g) & 0xFCU) << 3) | (((b) & 0xFFU) >> 3)))

#define C_BLACK     RGB565(  0,   0,   0)
#define C_WHITE     RGB565(240, 240, 240)
#define C_DIM       RGB565(105, 110, 125)
#define C_GRAY      RGB565( 90,  90, 100)
#define C_IDLE      RGB565( 70,  70,  80)
#define C_HDR       RGB565( 22,  27,  42)
#define C_CYAN      RGB565(  0, 200, 230)
#define C_AMBER     RGB565(255, 190,  40)
#define C_MINT      RGB565(120, 255, 160)
#define C_RED       RGB565(225,  45,  45)
#define C_GREEN     RGB565( 40, 220,  80)
#define C_YELLOW    RGB565(240, 210,  40)

/* Заставка (логотип слева, версия справа). Логотип - SPLASH_LOGO_W x SPLASH_LOGO_H, цвет фона задан генератором. */
#define C_SPLASH_BG    RGB565(SPLASH_BG_R, SPLASH_BG_G, SPLASH_BG_B)
#define C_SPLASH_TEXT  RGB565( 24,  24,  24)
#define SPLASH_LOGO_X  6U
#define SPLASH_LOGO_Y  ((DISPLAY_HEIGHT - SPLASH_LOGO_H) / 2U)
#define SPLASH_TEXT_X0 (SPLASH_LOGO_X + SPLASH_LOGO_W + 4U)   /* правая область: от логотипа до края экрана */

/* Поля, которые можно перерисовать независимо */
#define F_HEADER    (1U << 0)
#define F_INSTR     (1U << 2)
#define F_NOTE      (1U << 3)
#define F_VOLUME    (1U << 4)
#define F_ALL       (F_HEADER | F_INSTR | F_NOTE | F_VOLUME)

/* ------------------------------------------------------------------------- */
/* UI state                                                                  */
/* ------------------------------------------------------------------------- */

typedef enum { NOTE_KIND_NONE = 0, NOTE_KIND_SINGLE, NOTE_KIND_CHORD } NoteKind_t;

typedef struct
{
    bool     active;
    uint32_t expire;      /* tick, когда временная ошибка гаснет */
    uint32_t stamp;       /* порядковый номер появления          */
} ErrorSlot_t;

static const struct
{
    const char *text;
    bool        sticky;
} error_info[DISPLAY_ERR_COUNT] =
{
    [DISPLAY_ERR_NONE]       = { "",                 false },
    [DISPLAY_ERR_USB_ENUM]   = { "USB ENUM FAIL",    true  },
    [DISPLAY_ERR_AUDIO_DMA]  = { "AUDIO DMA ERROR",  false },
    [DISPLAY_ERR_MIDI_QUEUE] = { "MIDI QUEUE FULL",  false },
    [DISPLAY_ERR_USB_RX]     = { "USB RX ERROR",     false },
    [DISPLAY_ERR_AUDIO_OVERLOAD] = { "AUDIO OVERLOAD", false },
    [DISPLAY_ERR_SF2]        = { "SF2 NOT LOADED",   false },
};

static struct
{
    Display_Link_t link;
    uint32_t       link_since;       /* tick последней смены состояния линка */
    char           device[13];

    NoteKind_t     kind;
    bool           note_live;        /* клавиши сейчас нажаты; иначе - серая "последняя" */
    uint8_t        note;
    uint16_t       key_count;
    char           chord[16];
    uint8_t        velocity;
    bool           sustain;

    uint8_t        patch_index;
    char           patch_name[18];

    uint8_t        voices_used;
    uint8_t        voices_max;

    bool           volume_valid;
    uint8_t        volume;
    bool           clip;

    ErrorSlot_t    errors[DISPLAY_ERR_COUNT];
    uint32_t       error_stamp;

    uint32_t       dirty;
    uint32_t       last_draw_tick;
} ui =
{
    .link        = DISPLAY_LINK_NONE,
    .patch_index = 1,
    .patch_name  = "Pluck",
    .dirty       = F_ALL,
};

/* ---- Кратковременная подсказка (toast) в строке инструмента: ручка (CC) или педаль ----
 * Живёт в ui-состоянии только пока не истёк expire; Display_Task() убирает её и возвращает строку инструмента. */
typedef enum { TOAST_NONE = 0, TOAST_CC, TOAST_PEDAL } ToastKind_t;

static struct
{
    ToastKind_t kind;
    uint32_t    expire;     /* tick, когда подсказка гаснет */
    uint8_t     cc;
    uint8_t     value;      /* 0..127 (для педали не используется) */
    bool        on;         /* для педали */
} toast;

/* Состояние педалей (CC64/66/67): подсказка показывается только при смене ON/OFF, а не на каждое значение
 * (полупедаль шлёт CC потоком). */
static const struct { uint8_t cc; const char *name; } pedal_info[3] =
{
    { 64, "SUSTAIN"   },
    { 66, "SOSTENUTO" },
    { 67, "SOFT"      },
};
static bool pedal_on[3];

/* Имена CC для подсказки (до 8 символов, ASCII). Остальные показываются как "CC <номер>". */
static const struct { uint8_t cc; const char *name; } cc_names[] =
{
    {  1, "Mod"     }, {  2, "Breath"  }, { 10, "Pan"     }, { 11, "Expr"    },
    { 71, "Reson"   }, { 72, "Release" }, { 73, "Attack"  }, { 74, "Bright"  },
    { 91, "Reverb"  }, { 93, "Chorus"  },
};

static const char * const note_names[12] =
{
    "C", "C#", "D", "D#", "E", "F",
    "F#", "G", "G#", "A", "A#", "B"
};

/* ------------------------------------------------------------------------- */
/* ST7735 bus interface                                                      */
/* ------------------------------------------------------------------------- */

static int32_t Display_BusInit(void)
{
    return ST7735_OK;
}

static int32_t Display_GetTick(void)
{
    return (int32_t)HAL_GetTick();
}

/* Признак «DMA-передача поля ещё идёт». Сбрасывается в HAL_SPI_TxCpltCallback()/HAL_SPI_ErrorCallback()
 * (прерывание SPI4) - там же снимается CS. */
static volatile bool lcd_dma_busy = false;

/* Ждёт окончания DMA-передачи. Любое обращение к шине SPI4 (команды, блокирующая заливка) должно
 * сначала вызвать эту функцию: пока DMA занимает SPI, HAL_SPI_Transmit() вернёт HAL_BUSY.
 * Кадр занимает ~5,5 мс; при зависании (>50 мс) передача принудительно прерывается. */
static void Display_WaitIdle(void)
{
    if (!lcd_dma_busy) { return; }

    const uint32_t t0 = HAL_GetTick();
    while (lcd_dma_busy)
    {
        if ((HAL_GetTick() - t0) > 50U)
        {
            (void)HAL_SPI_Abort(&hspi4);
            HAL_GPIO_WritePin(LCD_CS_PORT, LCD_CS_PIN, GPIO_PIN_SET);
            lcd_dma_busy = false;
            break;
        }
    }
}

void HAL_SPI_TxCpltCallback(SPI_HandleTypeDef *hspi)
{
    if (hspi->Instance == SPI4)
    {
        HAL_GPIO_WritePin(LCD_CS_PORT, LCD_CS_PIN, GPIO_PIN_SET);
        lcd_dma_busy = false;
    }
}

void HAL_SPI_ErrorCallback(SPI_HandleTypeDef *hspi)
{
    if (hspi->Instance == SPI4)
    {
        HAL_GPIO_WritePin(LCD_CS_PORT, LCD_CS_PIN, GPIO_PIN_SET);
        lcd_dma_busy = false;
    }
}

static int32_t Display_WriteReg(
    uint8_t reg,
    uint8_t *data,
    uint32_t length)
{
    int32_t result;

    Display_WaitIdle();

    HAL_GPIO_WritePin(LCD_CS_PORT, LCD_CS_PIN, GPIO_PIN_RESET);
    HAL_GPIO_WritePin(LCD_DC_PORT, LCD_DC_PIN, GPIO_PIN_RESET);

    result = HAL_SPI_Transmit(&hspi4, &reg, 1, 100);

    if (result == HAL_OK && length > 0U)
    {
        HAL_GPIO_WritePin(LCD_DC_PORT, LCD_DC_PIN, GPIO_PIN_SET);
        result = HAL_SPI_Transmit(&hspi4, data, length, 500);
    }

    HAL_GPIO_WritePin(LCD_CS_PORT, LCD_CS_PIN, GPIO_PIN_SET);

    return (result == HAL_OK) ? ST7735_OK : ST7735_ERROR;
}

static int32_t Display_SendData(
    uint8_t *data,
    uint32_t length)
{
    int32_t result;

    Display_WaitIdle();
    HAL_GPIO_WritePin(LCD_CS_PORT, LCD_CS_PIN, GPIO_PIN_RESET);
    HAL_GPIO_WritePin(LCD_DC_PORT, LCD_DC_PIN, GPIO_PIN_SET);

    result = HAL_SPI_Transmit(&hspi4, data, length, 500);

    HAL_GPIO_WritePin(LCD_CS_PORT, LCD_CS_PIN, GPIO_PIN_SET);

    return (result == HAL_OK) ? ST7735_OK : ST7735_ERROR;
}

static ST7735_IO_t st7735_io =
{
    .Init     = Display_BusInit,
    .DeInit   = NULL,
    .Address  = 0,
    .WriteReg = Display_WriteReg,
    .ReadReg  = NULL, // Чтение недоступно
    .SendData = Display_SendData,
    .RecvData = NULL, // Чтение недоступно
    .GetTick  = Display_GetTick
};

/* ------------------------------------------------------------------------- */
/* Canvas: поле рисуется целиком в RAM и уходит на экран одним блитом        */
/* (нет мерцания "стёрли -> нарисовали", меньше SPI-команд)                  */
/* ------------------------------------------------------------------------- */

#define CANVAS_MAX_W   DISPLAY_WIDTH
#define CANVAS_MAX_H   32U

/* Буфер лежит в D2 SRAM (секция .dma_buffer, Non-cacheable по MPU): DMA1 не видит DTCM, а в D2 не нужна
 * очистка/инвалидация D-cache. 160x32x2 = 10 240 байт. */
static uint16_t canvas[CANVAS_MAX_W * CANVAS_MAX_H] __attribute__((section(".dma_buffer"), aligned(32)));
static uint16_t canvas_w;
static uint16_t canvas_h;

/*
 * ST7735_FillRGBRect() отправляет байты в порядке памяти (на Cortex-M это
 * младший байт первым), а панель ждёт старший первым. Поэтому в буфере
 * хранится цвет с переставленными байтами. (FillRect/DrawHLine меняют байты
 * сами - с ними такой проблемы нет.)
 */
static inline uint16_t Swap16(uint16_t c)
{
    return (uint16_t)((c << 8) | (c >> 8));
}

static void Canvas_Begin(uint16_t w, uint16_t h, uint16_t bg)
{
    Display_WaitIdle();   /* буфер ещё может уходить на панель по DMA */
    canvas_w = w;
    canvas_h = h;

    const uint16_t v = Swap16(bg);
    for (uint32_t i = 0; i < (uint32_t)w * h; i++)
    {
        canvas[i] = v;
    }
}

static void Canvas_Rect(int x, int y, int w, int h, uint16_t color)
{
    const uint16_t v = Swap16(color);

    for (int yy = y; yy < y + h; yy++)
    {
        if (yy < 0 || yy >= (int)canvas_h) { continue; }

        for (int xx = x; xx < x + w; xx++)
        {
            if (xx >= 0 && xx < (int)canvas_w)
            {
                canvas[yy * canvas_w + xx] = v;
            }
        }
    }
}

/*
 * Формат шрифта asc2_1206 / asc2_1608: глиф хранится по столбцам слева
 * направо, каждый столбец занимает (size + 7) / 8 байт, внутри байта
 * старший бит - верхняя строка. Рисуются только "включённые" пиксели,
 * фон уже залит Canvas_Begin().
 */
static void Canvas_Char(int x, int y, char c, uint8_t size, uint8_t scale, uint16_t color)
{
    if (c < ' ' || c > '~' || (size != 12U && size != 16U))
    {
        return;
    }

    const uint8_t width     = size / 2U;
    const uint8_t col_bytes = (size + 7U) / 8U;
    const uint8_t *glyph    = (size == 12U) ? asc2_1206[c - ' ']
                                            : asc2_1608[c - ' '];

    for (uint8_t col = 0; col < width; col++)
    {
        for (uint8_t row = 0; row < size; row++)
        {
            const uint8_t bits = glyph[col * col_bytes + (row >> 3)];

            if (bits & (0x80U >> (row & 7U)))
            {
                Canvas_Rect(x + col * scale, y + row * scale, scale, scale, color);
            }
        }
    }
}

/* Возвращает X сразу за последним символом */
static int Canvas_Text(int x, int y, const char *text, uint8_t size, uint8_t scale, uint16_t color)
{
    for (; *text != '\0'; text++)
    {
        Canvas_Char(x, y, *text, size, scale, color);
        x += (size / 2) * scale;
    }
    return x;
}

static void Canvas_Flush(uint16_t x, uint16_t y)
{
    if (!display_ready) { return; }

#if DISPLAY_USE_DMA
    /* Окно панели при инициализации задано на весь экран, поэтому при ширине поля = ширине экрана достаточно
     * один раз поставить курсор в начало поля: дальше строки заполняются подряд, и весь буфер уходит одним
     * DMA-запросом. Остальные случаи (и сбой запуска DMA) - прежним блокирующим путём. */
    if (x == 0U && canvas_w == DISPLAY_WIDTH)
    {
        Display_WaitIdle();
        if (ST7735_SetCursor(&st7735, x, y) == ST7735_OK)
        {
            HAL_GPIO_WritePin(LCD_CS_PORT, LCD_CS_PIN, GPIO_PIN_RESET);
            HAL_GPIO_WritePin(LCD_DC_PORT, LCD_DC_PIN, GPIO_PIN_SET);
            lcd_dma_busy = true;
            if (HAL_SPI_Transmit_DMA(&hspi4, (uint8_t *)canvas, (uint16_t)(canvas_w * canvas_h * 2U)) == HAL_OK)
            {
                return;   /* CS снимет HAL_SPI_TxCpltCallback() */
            }
            lcd_dma_busy = false;
            HAL_GPIO_WritePin(LCD_CS_PORT, LCD_CS_PIN, GPIO_PIN_SET);
        }
    }
#endif

    ST7735_FillRGBRect(&st7735, x, y, (uint8_t *)canvas, canvas_w, canvas_h);
}

/* ------------------------------------------------------------------------- */
/* Helpers                                                                   */
/* ------------------------------------------------------------------------- */

static void CopyText(char *dst, size_t dst_size, const char *src)
{
    if (src == NULL) { src = ""; }

    size_t i = 0;
    for (; i + 1 < dst_size && src[i] != '\0'; i++)
    {
        /* шрифт только ASCII */
        dst[i] = (src[i] >= ' ' && src[i] <= '~') ? src[i] : '?';
    }
    dst[i] = '\0';
}

static void MarkDirty(uint32_t fields)
{
    ui.dirty |= fields;
}

/* Какую ошибку показывать: липкая важнее временной, среди равных - более новая */
static Display_Error_t Error_Pick(uint8_t *extra)
{
    Display_Error_t best = DISPLAY_ERR_NONE;
    uint8_t count = 0;

    for (uint8_t i = 1; i < DISPLAY_ERR_COUNT; i++)
    {
        if (!ui.errors[i].active) { continue; }
        count++;

        if (best == DISPLAY_ERR_NONE)
        {
            best = (Display_Error_t)i;
            continue;
        }

        const bool best_sticky = error_info[best].sticky;
        const bool cur_sticky  = error_info[i].sticky;

        if ((cur_sticky && !best_sticky) ||
            (cur_sticky == best_sticky && ui.errors[i].stamp > ui.errors[best].stamp))
        {
            best = (Display_Error_t)i;
        }
    }

    if (extra != NULL) { *extra = (count > 0) ? (uint8_t)(count - 1) : 0; }
    return best;
}

/* ------------------------------------------------------------------------- */
/* Field renderers                                                           */
/* ------------------------------------------------------------------------- */

static uint16_t Dot_Color(void)
{
    if (ui.errors[DISPLAY_ERR_USB_ENUM].active) { return C_RED; }

    switch (ui.link)
    {
        case DISPLAY_LINK_READY:
            return C_GREEN;
        case DISPLAY_LINK_ENUMERATING:
            return C_YELLOW;
        default:
            return C_GRAY;
    }
}

static void Canvas_Dot(int x, int y, uint16_t color)
{
    /* Круг 7x7; бит 6 - левый столбец */
    static const uint8_t mask[DOT_SIZE] = { 0x1C, 0x3E, 0x7F, 0x7F, 0x7F, 0x3E, 0x1C };

    for (int row = 0; row < (int)DOT_SIZE; row++)
    {
        for (int col = 0; col < (int)DOT_SIZE; col++)
        {
            if (mask[row] & (0x40U >> col))
            {
                Canvas_Rect(x + col, y + row, 1, 1, color);
            }
        }
    }
}

static void Draw_Header(void)
{
    uint8_t extra = 0;
    const Display_Error_t err = Error_Pick(&extra);

    if (err != DISPLAY_ERR_NONE)
    {
        /* Красная плашка вместо шапки: "! E03 MIDI QUEUE FULL +1" (до 26 символов) */
        char text[32];
        snprintf(text, sizeof(text), "! E%02u %s", (unsigned)err, error_info[err].text);

        if (extra > 0)
        {
            size_t len = strlen(text);
            if (len > 22) { len = 22; }
            snprintf(&text[len], sizeof(text) - len, " +%u", (unsigned)extra);
        }
        text[26] = '\0';

        Canvas_Begin(DISPLAY_WIDTH, HDR_H, C_RED);
        Canvas_Text(2, 1, text, 12, 1, C_WHITE);
        Canvas_Flush(0, HDR_Y);
        return;
    }

    Canvas_Begin(DISPLAY_WIDTH, HDR_H, C_HDR);
    Canvas_Dot(DOT_X, DOT_Y, Dot_Color());

    const char *name;
    uint16_t name_color = C_DIM;

    switch (ui.link)
    {
        case DISPLAY_LINK_READY:
            name = (ui.device[0] != '\0') ? ui.device : "USB MIDI";
            name_color = C_WHITE;
            break;
        case DISPLAY_LINK_ENUMERATING:
            name = "connecting...";
            break;
        default:
            name = "no keyboard";
            break;
    }
    Canvas_Text(14, 1, name, 12, 1, name_color);

    /* Правая часть: [SUS] [V used/max], выравнивание по правому краю */
    int right = (int)DISPLAY_WIDTH - 2;

    if (ui.voices_max > 0)
    {
        char voices[10];
        snprintf(voices, sizeof(voices), "V%u/%u", (unsigned)ui.voices_used, (unsigned)ui.voices_max);
        right -= (int)strlen(voices) * 6;
        Canvas_Text(right, 1, voices, 12, 1, C_DIM);
        right -= 6;
    }

    if (ui.sustain)
    {
        right -= 18;
        Canvas_Text(right, 1, "SUS", 12, 1, C_AMBER);
    }

    Canvas_Flush(0, HDR_Y);
}

/* true для CC, которые не нужно показывать ручкой: педали (у них своя подсказка), Bank Select, Data Entry,
 * (N)RPN и канальные команды 120..127 (All Sound Off, Reset Controllers, All Notes Off и т. д.) */
static bool Toast_IsIgnoredCC(uint8_t cc)
{
    return cc == 0U || cc == 32U || cc == 6U || cc == 38U ||
           (cc >= 96U && cc <= 101U) || cc >= 120U;
}

static void Draw_Toast(void)
{
    Canvas_Begin(DISPLAY_WIDTH, INS_H, C_BLACK);

    if (toast.kind == TOAST_PEDAL)
    {
        const char *name = "PEDAL";
        for (uint8_t i = 0; i < 3U; i++)
        {
            if (pedal_info[i].cc == toast.cc) { name = pedal_info[i].name; }
        }
        Canvas_Text(2, 0, name, 16, 1, C_WHITE);

        /* Плашка справа: ON - залитая янтарная, OFF - серая рамка */
        if (toast.on)
        {
            Canvas_Rect(112, 0, 46, 16, C_AMBER);
            Canvas_Text(127, 0, "ON", 16, 1, C_BLACK);
        }
        else
        {
            Canvas_Rect(112, 0, 46, 16, C_GRAY);
            Canvas_Rect(113, 1, 44, 14, C_BLACK);
            Canvas_Text(123, 0, "OFF", 16, 1, C_DIM);
        }
    }
    else
    {
        char label[10] = "";
        for (size_t i = 0; i < sizeof(cc_names) / sizeof(cc_names[0]); i++)
        {
            if (cc_names[i].cc == toast.cc) { snprintf(label, sizeof(label), "%s", cc_names[i].name); }
        }
        if (label[0] == '\0') { snprintf(label, sizeof(label), "CC %u", (unsigned)toast.cc); }
        Canvas_Text(2, 0, label, 16, 1, C_AMBER);

        /* Полоса 56x10 (внутри 54x8) и проценты справа */
        const unsigned percent = ((unsigned)toast.value * 100U + 63U) / 127U;
        Canvas_Rect(74, 3, 56, 10, C_GRAY);
        Canvas_Rect(75, 4, 54, 8, C_BLACK);
        Canvas_Rect(75, 4, ((int)toast.value * 54) / 127, 8, C_CYAN);

        char text[8];
        snprintf(text, sizeof(text), "%3u%%", percent);
        Canvas_Text(134, 2, text, 12, 1, C_WHITE);
    }

    Canvas_Flush(0, INS_Y);
}

static void Draw_Instrument(void)
{
    if (toast.kind != TOAST_NONE)
    {
        Draw_Toast();
        return;
    }

    char number[4];
    snprintf(number, sizeof(number), "%02u", (unsigned)(ui.patch_index % 100U));

    Canvas_Begin(DISPLAY_WIDTH, INS_H, C_BLACK);
    Canvas_Text(2, 0, number, 16, 1, C_DIM);
    Canvas_Text(24, 0, ui.patch_name, 16, 1, C_CYAN);
    Canvas_Flush(0, INS_Y);
}

static void Draw_Note(void)
{
    Canvas_Begin(DISPLAY_WIDTH, NOTE_H, C_BLACK);

    if (ui.kind != NOTE_KIND_NONE)
    {
        char text[16];
        uint16_t color;

        if (ui.kind == NOTE_KIND_SINGLE)
        {
            /* Нота 0..11 -> октава -1, поэтому знаковый int */
            const int octave = (int)(ui.note / 12U) - 1;
            snprintf(text, sizeof(text), "%s%d", note_names[ui.note % 12U], octave);
            color = ui.note_live ? C_AMBER : C_IDLE;
        }
        else
        {
            snprintf(text, sizeof(text), "%s", ui.chord);
            color = ui.note_live ? C_MINT : C_IDLE;
        }

        const int len = (int)strlen(text);

        /* Крупно (16x32), если помещается в 160 px, иначе обычным 8x16 */
        const uint8_t scale = (len * 16 + 2 <= (int)DISPLAY_WIDTH) ? 2 : 1;
        const int y = (scale == 2) ? 0 : 8;
        const int end_x = Canvas_Text(2, y, text, 16, scale, color);

        char side[12];

        if (ui.kind == NOTE_KIND_SINGLE && ui.note_live)
        {
            snprintf(side, sizeof(side), "NOTE %3u", (unsigned)ui.note);
            Canvas_Text(70, 1, side, 12, 1, C_DIM);

            if (ui.velocity > 0)
            {
                snprintf(side, sizeof(side), "VEL  %3u", (unsigned)ui.velocity);
                Canvas_Text(70, 16, side, 12, 1, C_DIM);
            }
        }
        else if (end_x + 4 <= 124)
        {
            if (ui.note_live)
            {
                snprintf(side, sizeof(side), "x%u", (unsigned)ui.key_count);
                Canvas_Text(124, 18, side, 12, 1, C_DIM);
            }
            else
            {
                Canvas_Text(124, 18, "last", 12, 1, C_GRAY);
            }
        }
    }

    Canvas_Flush(0, NOTE_Y);
}

static void Draw_Volume(void)
{
    Canvas_Begin(DISPLAY_WIDTH, VOL_H, C_BLACK);

    Canvas_Text(2, 0, "VOL", 12, 1, C_DIM);

    /* Рамка 102x10 и внутренняя область 100x8 */
    Canvas_Rect(26, 2, 102, 10, C_GRAY);
    Canvas_Rect(27, 3, 100, 8, C_BLACK);

    char text[8];

    if (ui.volume_valid)
    {
        Canvas_Rect(27, 3, ui.volume, 8, ui.clip ? C_RED : C_GREEN);
        snprintf(text, sizeof(text), "%3u%%", (unsigned)ui.volume);
        Canvas_Text(132, 0, text, 12, 1, C_WHITE);
    }
    else
    {
        Canvas_Text(132, 0, " --%", 12, 1, C_DIM);
    }

    Canvas_Flush(0, VOL_Y);
}

/* Рисует одно "грязное" поле; возвращает true, если что-то нарисовано */
static bool Draw_NextField(void)
{
    if (ui.dirty & F_HEADER)
    {
        ui.dirty &= ~F_HEADER;
        Draw_Header();
    }
    else if (ui.dirty & F_NOTE)
    {
        ui.dirty &= ~F_NOTE;
        Draw_Note();
    }
    else if (ui.dirty & F_INSTR)
    {
        ui.dirty &= ~F_INSTR;
        Draw_Instrument();
    }
    else if (ui.dirty & F_VOLUME)
    {
        ui.dirty &= ~F_VOLUME;
        Draw_Volume();
    }
    else
    {
        return false;
    }

    return true;
}

/* ------------------------------------------------------------------------- */
/* Splash screen                                                             */
/* ------------------------------------------------------------------------- */

/* Одна горизонтальная полоса заставки (canvas вмещает до CANVAS_MAX_H строк): логотип, версия и четыре цветные
 * "клавиши" под ней (цвета клавиш логотипа). y0 - первая строка полосы на экране. */
static void Splash_DrawStrip(uint16_t y0, uint16_t h, const char *text, uint8_t font,
                             int text_x, int text_y)
{
    static const uint16_t key_colors[4] =
    {
        RGB565(255, 107, 157), RGB565(255, 184,  77), RGB565( 77, 214, 166), RGB565(110, 142, 255)
    };

    Canvas_Begin(DISPLAY_WIDTH, h, C_SPLASH_BG);

    for (uint16_t row = 0; row < h; row++)
    {
        const int ly = (int)(y0 + row) - (int)SPLASH_LOGO_Y;
        if (ly < 0 || ly >= (int)SPLASH_LOGO_H) { continue; }

        const uint16_t *src = &splash_logo[(uint32_t)ly * SPLASH_LOGO_W];
        uint16_t       *dst = &canvas[(uint32_t)row * DISPLAY_WIDTH + SPLASH_LOGO_X];
        for (uint16_t x = 0; x < SPLASH_LOGO_W; x++)
        {
            dst[x] = Swap16(src[x]);
        }
    }

    Canvas_Text(text_x, text_y - (int)y0, text, font, 1, C_SPLASH_TEXT);
    for (int i = 0; i < 4; i++)
    {
        Canvas_Rect(text_x + 12 * i, text_y + (int)font + 4 - (int)y0, 10, 4, key_colors[i]);
    }

    Canvas_Flush(0, y0);
}

void Display_ShowSplash(void)
{
    splash_active = true;
    if (!display_ready) { return; }

    char text[16];
    snprintf(text, sizeof(text), "v%s", PURRMIDI_VERSION_STRING);

    /* Версия крупным шрифтом (8 px на символ); длинная (например, "v1.0.3-dev") - мелким (6 px), чтобы поместиться */
    const int avail = (int)DISPLAY_WIDTH - (int)SPLASH_TEXT_X0 - 4;
    uint8_t   font  = 16U;
    int       width = (int)strlen(text) * (font / 2);
    if (width > avail)
    {
        font  = 12U;
        width = (int)strlen(text) * (font / 2);
    }
    const int text_x = (int)SPLASH_TEXT_X0 + (avail - width) / 2;
    const int text_y = ((int)DISPLAY_HEIGHT - ((int)font + 8)) / 2;   /* текст + зазор + полоска клавиш */

    for (uint16_t y0 = 0; y0 < DISPLAY_HEIGHT; y0 += CANVAS_MAX_H)
    {
        const uint16_t h = (DISPLAY_HEIGHT - y0 < CANVAS_MAX_H) ? (uint16_t)(DISPLAY_HEIGHT - y0) : CANVAS_MAX_H;
        Splash_DrawStrip(y0, h, text, font, text_x, text_y);
    }
}

void Display_EndSplash(void)
{
    splash_active = false;
    if (!display_ready) { return; }

    Display_WaitIdle();
    ST7735_FillRect(&st7735, 0, 0, DISPLAY_WIDTH, DISPLAY_HEIGHT, C_BLACK);

    /* Интерфейс рисуется сразу целиком, без ожидания Display_Task() */
    MarkDirty(F_ALL);
    while (Draw_NextField()) { }
    ui.last_draw_tick = HAL_GetTick();
}

/* ------------------------------------------------------------------------- */
/* Public API: lifecycle                                                     */
/* ------------------------------------------------------------------------- */

void Display_Init(void)
{
    /* Пока в памяти дисплея мусор, подсветка должна быть выключена */
    HAL_GPIO_WritePin(LCD_BL_PORT, LCD_BL_PIN, LCD_BL_OFF);

    memset(&st7735_ctx, 0, sizeof(st7735_ctx));

    /* Конфигурация из примера WeAct 0.96" TFT */
    st7735_ctx.Orientation = ST7735_ORIENTATION_LANDSCAPE_ROT180;
    st7735_ctx.Panel       = HannStar_Panel;
    st7735_ctx.Type        = ST7735_0_9_inch_screen;

    if (ST7735_RegisterBusIO(&st7735, &st7735_io) != ST7735_OK)
    {
        printf("Display: ST7735_RegisterBusIO failed, continuing without display\r\n");
        return;
    }

    if (ST7735_Init(&st7735, ST7735_FORMAT_RBG565, &st7735_ctx) != ST7735_OK)
    {
        printf("Display: ST7735_Init failed, continuing without display\r\n");
        return;
    }
    display_ready = true;

    /* Единственная полная очистка экрана, дальше поля перекрывают друг друга сами */
    ST7735_FillRect(&st7735, 0, 0, DISPLAY_WIDTH, DISPLAY_HEIGHT, C_BLACK);

    /* Вместо интерфейса при включении - заставка с логотипом и версией (main.c убирает её через Display_EndSplash()).
     * Поля интерфейса помечены грязными (F_ALL) и нарисуются при её снятии. */
    MarkDirty(F_ALL);
    Display_ShowSplash();
    ui.last_draw_tick = HAL_GetTick();

    ST7735_DisplayOn(&st7735);
    HAL_GPIO_WritePin(LCD_BL_PORT, LCD_BL_PIN, LCD_BL_ON); // включаем подсветку
}

void Display_ShowBootProgress(const char *text, uint8_t percent)
{
    if (!display_ready) { return; }
    if (percent > 100U) { percent = 100U; }

    const int bar_w = DISPLAY_WIDTH - 8;

    Canvas_Begin(DISPLAY_WIDTH, CANVAS_MAX_H, C_BLACK);
    Canvas_Text(4, 0, (text != NULL) ? text : "", 16, 1, C_AMBER);
    Canvas_Rect(4, 20, bar_w, 10, C_IDLE);
    Canvas_Rect(5, 21, ((bar_w - 2) * (int)percent) / 100, 8, C_GREEN);
    Canvas_Flush(0, 24);
}

void Display_EndBootProgress(void)
{
    if (!display_ready) { return; }

    ST7735_FillRect(&st7735, 0, 0, DISPLAY_WIDTH, DISPLAY_HEIGHT, C_BLACK);
    MarkDirty(F_ALL);   /* Display_Task() перерисует интерфейс */
}

void Display_Task(void)
{
    if (!display_ready || splash_active) { return; }

    const uint32_t now = HAL_GetTick();

    /* Гасим временные ошибки */
    for (uint8_t i = 1; i < DISPLAY_ERR_COUNT; i++)
    {
        if (ui.errors[i].active && !error_info[i].sticky &&
            (int32_t)(now - ui.errors[i].expire) >= 0)
        {
            ui.errors[i].active = false;
            MarkDirty(F_HEADER);
        }
    }

    /* Гасим подсказку CC/педали: возвращаем строку с названием инструмента */
    if (toast.kind != TOAST_NONE && (int32_t)(now - toast.expire) >= 0)
    {
        toast.kind = TOAST_NONE;
        MarkDirty(F_INSTR);
    }

    /* Энумерация затянулась: библиотека USB-хоста сама об этом не сообщает */
    if (ui.link == DISPLAY_LINK_ENUMERATING && !ui.errors[DISPLAY_ERR_USB_ENUM].active &&
        (now - ui.link_since) >= ENUM_TIMEOUT_MS)
    {
        Display_ShowError(DISPLAY_ERR_USB_ENUM);
    }

    if (ui.dirty == 0U || (now - ui.last_draw_tick) < MIN_DRAW_INTERVAL_MS || lcd_dma_busy)
    {
        return;   /* нечего рисовать, рано или предыдущее поле ещё уходит по DMA */
    }

    /* Не больше одного поля за вызов, чтобы не задерживать USB/MIDI */
    Draw_NextField();
    ui.last_draw_tick = HAL_GetTick();
}

/* ------------------------------------------------------------------------- */
/* Public API: connection                                                    */
/* ------------------------------------------------------------------------- */

void Display_SetLinkState(Display_Link_t state)
{
    if (ui.link == state) { return; }

    ui.link       = state;
    ui.link_since = HAL_GetTick();
    ui.errors[DISPLAY_ERR_USB_ENUM].active = false;   /* новое состояние линка - ошибка устарела */

    if (state != DISPLAY_LINK_READY)
    {
        /* Клавиатуры нет: сбрасываем всё, что от неё зависело */
        ui.sustain     = false;
        ui.voices_used = 0;
        memset(pedal_on, 0, sizeof(pedal_on));
        if (toast.kind != TOAST_NONE)
        {
            toast.kind = TOAST_NONE;
            MarkDirty(F_INSTR);
        }

        if (ui.note_live)
        {
            ui.note_live = false;
            MarkDirty(F_NOTE);
        }
    }
    MarkDirty(F_HEADER);
}

void Display_SetMidiConnected(bool connected)
{
    if (connected)
    {
        Display_SetLinkState(DISPLAY_LINK_READY);
    }
    else if (ui.link == DISPLAY_LINK_READY)
    {
        /* Идущую энумерацию не затираем: ею управляет USB-колбэк */
        Display_SetLinkState(DISPLAY_LINK_NONE);
    }
}

void Display_SetDeviceName(const char *name)
{
    char tmp[sizeof(ui.device)];
    CopyText(tmp, sizeof(tmp), name);

    if (strcmp(tmp, ui.device) != 0)
    {
        memcpy(ui.device, tmp, sizeof(ui.device));
        MarkDirty(F_HEADER);
    }
}

/* ------------------------------------------------------------------------- */
/* Public API: notes                                                         */
/* ------------------------------------------------------------------------- */

void Display_SetLastNote(uint8_t note)
{
    Display_SetNoteState(NULL, 1, note);
}

void Display_SetNoteState(
    const uint8_t *active_notes,
    uint16_t active_note_count,
    uint8_t last_note)
{
    if (active_note_count == 0)
    {
        /* Клавиши отпущены: оставляем последнюю ноту/аккорд серым */
        if (ui.kind != NOTE_KIND_NONE && ui.note_live)
        {
            ui.note_live = false;
            MarkDirty(F_NOTE);
        }
        return;
    }

    NoteKind_t kind = NOTE_KIND_SINGLE;
    char chord[sizeof(ui.chord)] = "";

    if (active_note_count >= 3 && active_notes != NULL)
    {
        kind = NOTE_KIND_CHORD;

        /* Имя считаем сразу: active_notes действителен только на время вызова */
        if (!ChordDetector_Detect(active_notes, active_note_count, chord, sizeof(chord)))
        {
            snprintf(chord, sizeof(chord), "???");
        }
    }

    if (ui.kind == kind && ui.note_live && ui.note == last_note &&
        ui.key_count == active_note_count && strcmp(ui.chord, chord) == 0)
    {
        return;   /* ничего не изменилось */
    }

    ui.kind      = kind;
    ui.note_live = true;
    ui.note      = last_note;
    ui.key_count = active_note_count;
    memcpy(ui.chord, chord, sizeof(ui.chord));
    MarkDirty(F_NOTE);
}

void Display_SetVelocity(uint8_t velocity)
{
    if (ui.velocity == velocity) { return; }

    ui.velocity = velocity;
    if (ui.note_live && ui.kind == NOTE_KIND_SINGLE)
    {
        MarkDirty(F_NOTE);
    }
}

void Display_SetSustain(bool on)
{
    if (ui.sustain == on) { return; }

    ui.sustain = on;
    MarkDirty(F_HEADER);
}

/* ------------------------------------------------------------------------- */
/* Public API: instrument, voices, volume                                    */
/* ------------------------------------------------------------------------- */

void Display_SetPatch(uint8_t index, const char *name)
{
    char tmp[sizeof(ui.patch_name)];
    CopyText(tmp, sizeof(tmp), name);

    if (ui.patch_index == index && strcmp(tmp, ui.patch_name) == 0) { return; }

    ui.patch_index = index;
    memcpy(ui.patch_name, tmp, sizeof(ui.patch_name));
    toast.kind = TOAST_NONE;   /* новый инструмент должен быть виден сразу, а не через 1,2 с */
    MarkDirty(F_INSTR);
}

void Display_SetVoices(uint8_t used, uint8_t max)
{
    if (ui.voices_used == used && ui.voices_max == max) { return; }

    ui.voices_used = used;
    ui.voices_max  = max;
    MarkDirty(F_HEADER);
}

void Display_SetVolume(uint8_t percent)
{
    if (percent > 100U) { percent = 100U; }

    if (ui.volume_valid && ui.volume == percent) { return; }

    ui.volume_valid = true;
    ui.volume       = percent;
    MarkDirty(F_VOLUME);
}

void Display_SetClip(bool clipping)
{
    if (ui.clip == clipping) { return; }

    ui.clip = clipping;
    MarkDirty(F_VOLUME);
}

/* ------------------------------------------------------------------------- */
/* Public API: controllers (knobs, pedals)                                   */
/* ------------------------------------------------------------------------- */

void Display_ShowControl(uint8_t cc, uint8_t value)
{
    if (!display_ready || splash_active) { return; }

    cc    &= 0x7FU;
    value &= 0x7FU;

    /* Педали: подсказка только при смене состояния */
    for (uint8_t i = 0; i < 3U; i++)
    {
        if (pedal_info[i].cc != cc) { continue; }

        const bool on = (value >= 64U);
        if (on == pedal_on[i]) { return; }

        pedal_on[i]  = on;
        toast.kind   = TOAST_PEDAL;
        toast.cc     = cc;
        toast.on     = on;
        toast.expire = HAL_GetTick() + CC_TOAST_MS;
        MarkDirty(F_INSTR);
        return;
    }

    if (Toast_IsIgnoredCC(cc)) { return; }

    /* Тот же CC с тем же значением (повтор от клавиатуры): только продлеваем показ */
    const bool same = (toast.kind == TOAST_CC && toast.cc == cc && toast.value == value);

    toast.kind   = TOAST_CC;
    toast.cc     = cc;
    toast.value  = value;
    toast.expire = HAL_GetTick() + CC_TOAST_MS;
    if (!same) { MarkDirty(F_INSTR); }
}

/* ------------------------------------------------------------------------- */
/* Public API: errors                                                        */
/* ------------------------------------------------------------------------- */

void Display_ShowError(Display_Error_t code)
{
    if (code <= DISPLAY_ERR_NONE || code >= DISPLAY_ERR_COUNT) { return; }

    ErrorSlot_t *slot = &ui.errors[code];

    slot->expire = HAL_GetTick() + ERROR_TIMEOUT_MS;

    if (!slot->active)
    {
        slot->active = true;
        slot->stamp  = ++ui.error_stamp;
        MarkDirty(F_HEADER);
    }
    /* Повторная ошибка только продлевает показ, без перерисовки */
}

void Display_ClearError(Display_Error_t code)
{
    if (code <= DISPLAY_ERR_NONE || code >= DISPLAY_ERR_COUNT) { return; }

    if (ui.errors[code].active)
    {
        ui.errors[code].active = false;
        MarkDirty(F_HEADER);
    }
}
