purrrock/purrmidi/Engine/synth/lead_synth.cpp

#include "lead_synth.h"
#include "synth_arena.h"
#include "synth_common.h"
#include "Synthesis/oscillator.h"
#include "Filters/svf.h"
#include "Control/adsr.h"
#include "Utility/dsp.h"

#include <atomic>
#include <cmath>
#include <cstring>

using namespace daisysp;

// Параметры конфигурации аудио-тракта и FIFO
#define LEAD_SAMPLE_RATE          48000.0f
#define LEAD_MASTER_GAIN          0.50f   // Запас по динамическому диапазону для 8 голосов
#define EVENT_FIFO_SIZE           32      // Емкость кольцевого FIFO буфера
#define NOTE_ON_FIFO_LIMIT        28      // Порог резервирования слотов для Note Off и CC64

// Диапазоны частот и генерации
#define LEAD_MIN_FREQ             20.0f
#define LEAD_MAX_FREQ             18000.0f

// По умолчанию и ограничения параметров синтеза (настраиваются через CC)
#define LEAD_DEFAULT_CUTOFF       3000.0f
#define LEAD_MIN_CUTOFF           30.0f
#define LEAD_MAX_CUTOFF           12000.0f

#define LEAD_DEFAULT_RES          0.35f
#define LEAD_MIN_RES              0.05f
#define LEAD_MAX_RES              0.95f

#define LEAD_DEFAULT_ENV_AMT      4000.0f
#define LEAD_MAX_ENV_AMT          10000.0f

#define LEAD_DEFAULT_ATTACK       0.005f
#define LEAD_MIN_ATTACK           0.002f
#define LEAD_MAX_ATTACK           1.500f

#define LEAD_DEFAULT_DECAY        0.300f
#define LEAD_DEFAULT_SUSTAIN      0.600f

#define LEAD_DEFAULT_RELEASE      0.250f
#define LEAD_MIN_RELEASE          0.020f
#define LEAD_MAX_RELEASE          2.000f

// Колесо высоты тона и All Sound Off
#define LEAD_BEND_RANGE           2.0f    // полутонов в каждую сторону (как у остальных движков)
#define LEAD_BEND_SMOOTH          0.10f   // сглаживание положения колеса за один control-rate тик (≈1,7 мс)
#define LEAD_KILL_RELEASE_SEC     0.010f  // All Sound Off: быстрое гашение без щелчка

#define LEAD_VELOCITY_MIN_GAIN    0.200f
#define LEAD_VELOCITY_SCALE       0.800f

#define LEAD_FILTER_DECAY_OFFSET  0.050f
#define LEAD_FILTER_SUSTAIN_SCALE 0.700f

// Обновление коэффициентов фильтра с пониженной частотой (control rate).
// Svf::SetFreq()/SetRes() внутри считают sinf() и powf(): вызывать их на каждый сэмпл для каждого голоса
// слишком дорого для ISR (8 голосов x 48 кГц). Период должен быть степенью двойки.
#define LEAD_CTRL_RATE            8
#define LEAD_CUTOFF_EPS           0.25f   // Гц: изменение среза меньше этого порога не пересчитывается

// Динамика суммы голосов.
// Нормировка 1/sqrt(N): некоррелированные голоса складываются по мощности, поэтому громкость аккорда
// остаётся близкой к громкости одной ноты. Коэффициент меняется плавно (быстро вниз, медленно вверх),
// иначе при каждом включении/окончании голоса весь микс скачком меняет уровень (щелчки, «пампинг»).
#define LEAD_GAIN_FALL_SEC        0.005f
#define LEAD_GAIN_RISE_SEC        0.150f

// Мягкий ограничитель на выходе вместо жёсткого среза int16: ниже порога (колена) сигнал не затрагивается,
// выше — плавно (tanh) приближается к потолку. Потолок чуть ниже полной шкалы, поэтому выход
// никогда не упирается в +-32767, даже при редких экстремальных пиках (резонанс + октавные голоса).
#define LEAD_LIMIT_KNEE           0.80f
#define LEAD_LIMIT_CEIL           0.98f

enum LeadEventType : uint8_t {
    EVENT_NOTE_ON,
    EVENT_NOTE_OFF,
    EVENT_CONTROL_CHANGE
};

struct LeadEvent {
    LeadEventType type;
    uint8_t param1; // note or CC control
    uint8_t param2; // velocity or CC value
    float freq;
    float velocity_gain;
};

struct LeadVoice {
    Oscillator osc;
    Svf filter;
    Adsr amp_env;
    Adsr filter_env;

    std::atomic<int32_t> voice_state{-1}; // -1 = свободен, 0..127 = номер ноты
    uint32_t trigger_age{0};
    uint8_t press_count{0};
    float velocity_gain{1.0f};
    float base_freq{440.0f};     // частота ноты без учёта колеса высоты тона
    float applied_ratio{1.0f};   // множитель колеса, с которым последний раз задана частота осциллятора
    float applied_cutoff{-1.0f}; // последняя частота среза, отправленная в Svf (-1 = принудительно обновить)
    float applied_res{-1.0f};    // последнее значение резонанса, отправленное в Svf
    bool gate{false};
    bool sustain_held{false};
};

// Голоса лежат в общей арене памяти (synth_arena.h): одновременно звучит один движок. Указатель устанавливается
// в LeadSynth_Init(); если арену забрал другой движок, SynthArena_IsOwner(&voices) == false.
static LeadVoice* voices = nullptr;

static uint32_t global_trigger_counter = 0;
static uint32_t ctrl_counter = 0;         // счётчик сэмплов для control rate
static float    mix_norm_gain = 1.0f;     // сглаженная нормировка суммы голосов (только аудио-контекст)

static float    mix_gain_fall_coef = 0.0f; // коэффициенты однополюсного сглаживания, считаются в Init()
static float    mix_gain_rise_coef = 0.0f;

// 1/sqrt(N) для N = 0..LEAD_VOICES (N = 0 трактуется как 1)
static const float kVoiceNorm[LEAD_VOICES + 1] = {
    1.0f, 1.0f, 0.70710678f, 0.57735027f, 0.5f, 0.44721360f, 0.40824829f, 0.37796447f, 0.35355339f
};

// Параметры субтрактивного синтезатора (управляются через MIDI CC)
static std::atomic<float> filter_cutoff_base{LEAD_DEFAULT_CUTOFF};
static std::atomic<float> filter_res{LEAD_DEFAULT_RES};
// CC1 (мод-колесо) 0..1: раскрывает фильтр сильнее на атаке (глубина огибающей растёт от LEAD_DEFAULT_ENV_AMT до
// LEAD_MAX_ENV_AMT). В нуле звук такой, как по умолчанию: колесо только добавляет яркости.
static std::atomic<float> filter_mod{0.0f};

// Колесо высоты тона: «последнее значение» без очереди (пишет main, читает аудио)
static std::atomic<int16_t> user_bend{0};
static float bend_semitones = 0.0f;   // сглаженное положение колеса (только аудио-контекст)
static float bend_ratio     = 1.0f;   // множитель частоты всех голосов (только аудио-контекст)

static inline float effective_env_amount(float mod) {
    return LEAD_DEFAULT_ENV_AMT + (LEAD_MAX_ENV_AMT - LEAD_DEFAULT_ENV_AMT) * mod;
}

// Параметры огибающей
static std::atomic<float> env_attack_sec{LEAD_DEFAULT_ATTACK};
static std::atomic<float> env_decay_sec{LEAD_DEFAULT_DECAY};
static std::atomic<float> env_sustain_lvl{LEAD_DEFAULT_SUSTAIN};
static std::atomic<float> env_release_sec{LEAD_DEFAULT_RELEASE};

// Очередь событий, учёт нажатий и протокол аварийного восстановления (общий компонент, см. synth_common.h)
static synth::NoteInput<LeadEvent, EVENT_FIFO_SIZE, NOTE_ON_FIFO_LIMIT> input;
static bool audio_sustain_pedal = false;

static inline float clamp_f(float val, float min_val, float max_val) {
    if (val < min_val) return min_val;
    if (val > max_val) return max_val;
    return val;
}

static inline float soft_limit(float x) {
    return synth::SoftLimit(x, LEAD_LIMIT_KNEE, LEAD_LIMIT_CEIL);
}

void LeadSynth_Init(void) {
    // Голоса создаются в общей арене заново: данные прежнего владельца (другого движка) стираются.
    voices = SynthArena_NewArray<LeadVoice, LEAD_VOICES>(&voices);

    global_trigger_counter = 0;
    ctrl_counter = 0;
    mix_norm_gain = 1.0f;
    mix_gain_fall_coef = 1.0f - expf(-1.0f / (LEAD_GAIN_FALL_SEC * LEAD_SAMPLE_RATE));
    mix_gain_rise_coef = 1.0f - expf(-1.0f / (LEAD_GAIN_RISE_SEC * LEAD_SAMPLE_RATE));
    audio_sustain_pedal = false;

    filter_cutoff_base.store(LEAD_DEFAULT_CUTOFF, std::memory_order_relaxed);
    filter_res.store(LEAD_DEFAULT_RES, std::memory_order_relaxed);
    filter_mod.store(0.0f, std::memory_order_relaxed);
    user_bend.store(0, std::memory_order_relaxed);
    bend_semitones = 0.0f;
    bend_ratio = 1.0f;

    env_attack_sec.store(LEAD_DEFAULT_ATTACK, std::memory_order_relaxed);
    env_decay_sec.store(LEAD_DEFAULT_DECAY, std::memory_order_relaxed);
    env_sustain_lvl.store(LEAD_DEFAULT_SUSTAIN, std::memory_order_relaxed);
    env_release_sec.store(LEAD_DEFAULT_RELEASE, std::memory_order_relaxed);

    for (int i = 0; i < LEAD_VOICES; i++) {
        LeadVoice& v = voices[i];
        v.osc.Init(LEAD_SAMPLE_RATE);
        v.osc.SetWaveform(Oscillator::WAVE_POLYBLEP_SAW);
        v.osc.SetAmp(1.0f);

        v.filter.Init(LEAD_SAMPLE_RATE);
        v.filter.SetDrive(0.1f);
        v.filter.SetRes(LEAD_DEFAULT_RES);

        v.amp_env.Init(LEAD_SAMPLE_RATE);
        v.amp_env.SetAttackTime(LEAD_DEFAULT_ATTACK);
        v.amp_env.SetDecayTime(LEAD_DEFAULT_DECAY);
        v.amp_env.SetSustainLevel(LEAD_DEFAULT_SUSTAIN);
        v.amp_env.SetReleaseTime(LEAD_DEFAULT_RELEASE);

        v.filter_env.Init(LEAD_SAMPLE_RATE);
        v.filter_env.SetAttackTime(LEAD_DEFAULT_ATTACK);
        v.filter_env.SetDecayTime(LEAD_DEFAULT_DECAY + LEAD_FILTER_DECAY_OFFSET);
        v.filter_env.SetSustainLevel(LEAD_DEFAULT_SUSTAIN * LEAD_FILTER_SUSTAIN_SCALE);
        v.filter_env.SetReleaseTime(LEAD_DEFAULT_RELEASE);

        v.voice_state.store(-1, std::memory_order_relaxed);
        v.trigger_age = 0;
        v.press_count = 0;
        v.velocity_gain = 1.0f;
        v.base_freq = 440.0f;
        v.applied_ratio = 1.0f;
        v.applied_cutoff = -1.0f;
        v.applied_res = -1.0f;
        v.gate = false;
        v.sustain_held = false;
    }

    input.Reset();
}

void LeadSynth_NoteOn(uint8_t midi_note, uint8_t velocity) {
    if (velocity == 0) {
        LeadSynth_NoteOff(midi_note);
        return;
    }
    if (midi_note >= 128) return;

    float freq = mtof((float)midi_note);
    freq = clamp_f(freq, LEAD_MIN_FREQ, LEAD_MAX_FREQ);

    float norm_vel = (float)velocity * (1.0f / 127.0f);
    float vel_gain = LEAD_VELOCITY_MIN_GAIN + LEAD_VELOCITY_SCALE * norm_vel;

    LeadEvent event;
    event.type = EVENT_NOTE_ON;
    event.param1 = midi_note;
    event.param2 = velocity;
    event.freq = freq;
    event.velocity_gain = vel_gain;

    input.NoteOn(midi_note, event);
}

void LeadSynth_NoteOff(uint8_t midi_note) {
    if (midi_note >= 128) return;

    LeadEvent event{};
    event.type = EVENT_NOTE_OFF;
    event.param1 = midi_note;
    event.param2 = 0;

    input.NoteOff(midi_note, event);
}

void LeadSynth_PitchBend(int16_t bend) {
    user_bend.store(bend < -8192 ? (int16_t)-8192 : (bend > 8191 ? (int16_t)8191 : bend), std::memory_order_relaxed);
}

bool LeadSynth_IsNoteActive(uint8_t midi_note) {
    if (midi_note >= 128 || !SynthArena_IsOwner(&voices)) return false;
    for (int i = 0; i < LEAD_VOICES; i++) {
        if (voices[i].voice_state.load(std::memory_order_acquire) == (int32_t)midi_note) {
            return true;
        }
    }
    return false;
}

uint32_t LeadSynth_GetDroppedEventsCount(void) {
    return input.Dropped();
}

void LeadSynth_ControlChange(uint8_t control, uint8_t value) {
    float norm = (float)value * (1.0f / 127.0f);

    switch (control) {
        case 1:  // CC 1: Modulation Wheel -> прибавка глубины огибающей фильтра (4000..10000 Гц); в нуле нейтрально
            filter_mod.store(norm, std::memory_order_relaxed);
            break;

        case 71: // CC 71: Resonance (0.05..0.95)
            filter_res.store(LEAD_MIN_RES + norm * (LEAD_MAX_RES - LEAD_MIN_RES), std::memory_order_relaxed);
            break;

        case 74: // CC 74: Filter Cutoff Frequency (30..12000 Гц)
            filter_cutoff_base.store(LEAD_MIN_CUTOFF + norm * (LEAD_MAX_CUTOFF - LEAD_MIN_CUTOFF), std::memory_order_relaxed);
            break;

        case 72: // CC 72: Release Time (0.02..2.02 с)
            env_release_sec.store(LEAD_MIN_RELEASE + norm * LEAD_MAX_RELEASE, std::memory_order_relaxed);
            break;

        case 73: // CC 73: Attack Time (0.002..1.502 с)
            env_attack_sec.store(LEAD_MIN_ATTACK + norm * LEAD_MAX_ATTACK, std::memory_order_relaxed);
            break;

        case 120: // CC 120: All Sound Off (критичное событие, как педаль)
        case 64: { // CC 64: Sustain Pedal
            LeadEvent event{};
            event.type = EVENT_CONTROL_CHANGE;
            event.param1 = control;
            event.param2 = value;
            input.Critical(event);
            break;
        }

        default:
            break;
    }
}

static int16_t LeadSynth_NextSample(void) {
    input.ServiceRecovery([]() {
        audio_sustain_pedal = false;

        for (int i = 0; i < LEAD_VOICES; i++) {
            voices[i].press_count = 0;
            voices[i].sustain_held = false;
            voices[i].gate = false;
            voices[i].voice_state.store(-1, std::memory_order_release);
        }
    });

    LeadEvent event;
    while (input.Pop(event)) {
        if (event.type == EVENT_NOTE_ON) {
            int target_voice = -1;

            // 1. Поиск голоса, уже играющего данную ноту
            for (int i = 0; i < LEAD_VOICES; i++) {
                if (voices[i].voice_state.load(std::memory_order_relaxed) == (int32_t)event.param1) {
                    target_voice = i;
                    break;
                }
            }

            bool is_retrigger = (target_voice != -1);

            // 2. Поиск свободного голоса
            if (target_voice == -1) {
                for (int i = 0; i < LEAD_VOICES; i++) {
                    if (voices[i].voice_state.load(std::memory_order_relaxed) == -1) {
                        target_voice = i;
                        break;
                    }
                }
            }

            // 3. Детерминированное вытеснение самого старого активного голоса
            if (target_voice == -1) {
                uint32_t max_age_diff = 0;
                target_voice = 0;
                for (int i = 0; i < LEAD_VOICES; i++) {
                    uint32_t age_diff = global_trigger_counter - voices[i].trigger_age;
                    if (age_diff >= max_age_diff) {
                        max_age_diff = age_diff;
                        target_voice = i;
                    }
                }
            }

            LeadVoice& v = voices[target_voice];
            v.base_freq = event.freq;
            v.applied_ratio = bend_ratio;
            v.osc.SetFreq(bend_ratio == 1.0f ? event.freq : clamp_f(event.freq * bend_ratio, LEAD_MIN_FREQ, LEAD_MAX_FREQ));
            v.velocity_gain = event.velocity_gain;
            v.trigger_age = ++global_trigger_counter;
            if (is_retrigger) {
                if (v.press_count < 255) v.press_count++;
            } else {
                v.press_count = 1;
            }
            v.sustain_held = false;
            v.gate = true;

            float att = env_attack_sec.load(std::memory_order_relaxed);
            float dec = env_decay_sec.load(std::memory_order_relaxed);
            float sus = env_sustain_lvl.load(std::memory_order_relaxed);
            float rel = env_release_sec.load(std::memory_order_relaxed);

            bool hard_retrigger = !is_retrigger; // Жесткий перезапуск огибающей при выборе/вытеснении нового голоса

            v.amp_env.SetAttackTime(att);
            v.amp_env.SetDecayTime(dec);
            v.amp_env.SetSustainLevel(sus);
            v.amp_env.SetReleaseTime(rel);
            v.amp_env.Retrigger(hard_retrigger);
            v.amp_env.Process(true);

            v.filter_env.SetAttackTime(att);
            v.filter_env.SetDecayTime(dec + LEAD_FILTER_DECAY_OFFSET);
            v.filter_env.SetSustainLevel(sus * LEAD_FILTER_SUSTAIN_SCALE);
            v.filter_env.SetReleaseTime(rel);
            v.filter_env.Retrigger(hard_retrigger);
            const float f_env_start = v.filter_env.Process(true);

            // Фильтр нового голоса настраиваем сразу (а не по ближайшему control-rate тику),
            // иначе первые сэмплы ноты прошли бы через коэффициенты предыдущей ноты этого голоса.
            {
                const float res_now = filter_res.load(std::memory_order_relaxed);
                float cutoff_now = filter_cutoff_base.load(std::memory_order_relaxed)
                                 + f_env_start * effective_env_amount(filter_mod.load(std::memory_order_relaxed));
                cutoff_now = clamp_f(cutoff_now, LEAD_MIN_CUTOFF, LEAD_MAX_CUTOFF);
                v.filter.SetRes(res_now);
                v.filter.SetFreq(cutoff_now);
                v.applied_res = res_now;
                v.applied_cutoff = cutoff_now;
            }

            v.voice_state.store((int32_t)event.param1, std::memory_order_release);

        } else if (event.type == EVENT_NOTE_OFF) {
            uint8_t note = event.param1;
            for (int i = 0; i < LEAD_VOICES; i++) {
                if (voices[i].voice_state.load(std::memory_order_relaxed) == (int32_t)note && voices[i].press_count > 0) {
                    voices[i].press_count--;
                    if (voices[i].press_count == 0) {
                        if (audio_sustain_pedal) {
                            voices[i].sustain_held = true;
                        } else {
                            voices[i].sustain_held = false;
                            voices[i].gate = false;
                        }
                    }
                }
            }
        } else if (event.type == EVENT_CONTROL_CHANGE) {
            if (event.param1 == 120) {
                // All Sound Off: ноты отпускаются с коротким (10 мс) спадом независимо от клавиш и педали
                audio_sustain_pedal = false;
                for (int i = 0; i < LEAD_VOICES; i++) {
                    voices[i].press_count = 0;
                    voices[i].sustain_held = false;
                    voices[i].gate = false;
                    voices[i].amp_env.SetReleaseTime(LEAD_KILL_RELEASE_SEC);
                    voices[i].filter_env.SetReleaseTime(LEAD_KILL_RELEASE_SEC);
                }
            } else if (event.param1 == 64) {
                bool pedal_on = (event.param2 >= 64);
                audio_sustain_pedal = pedal_on;
                if (!pedal_on) {
                    for (int i = 0; i < LEAD_VOICES; i++) {
                        voices[i].sustain_held = false;
                        if (voices[i].press_count == 0) {
                            voices[i].gate = false;
                        }
                    }
                }
            }
        }
    }

    float mix_sum_f = 0.0f;
    uint32_t active_voices_count = 0;

    const bool ctrl_tick = ((ctrl_counter++ & (LEAD_CTRL_RATE - 1U)) == 0U);

    const float base_cutoff = filter_cutoff_base.load(std::memory_order_relaxed);
    const float res_val     = filter_res.load(std::memory_order_relaxed);
    const float env_amt     = effective_env_amount(filter_mod.load(std::memory_order_relaxed));

    // Колесо высоты тона: на control-rate тике сглаживаем положение (без «ступенек»), частоты осцилляторов обновляем
    // только при изменении множителя. Фаза осциллятора не сбрасывается, поэтому щелчков нет.
    if (ctrl_tick) {
        const float target = (float)user_bend.load(std::memory_order_relaxed) * (LEAD_BEND_RANGE / 8192.0f);
        bend_semitones += (target - bend_semitones) * LEAD_BEND_SMOOTH;
        if (fabsf(target - bend_semitones) < 1e-4f) bend_semitones = target;   // точно в цель: центр = ровно 1.0
        bend_ratio = (bend_semitones == 0.0f) ? 1.0f : exp2f(bend_semitones * (1.0f / 12.0f));
    }

    for (int i = 0; i < LEAD_VOICES; i++) {
        LeadVoice& v = voices[i];

        if (v.voice_state.load(std::memory_order_relaxed) >= 0) {
            bool gate = v.gate || v.sustain_held;
            float amp_val = v.amp_env.Process(gate);
            float f_env_val = v.filter_env.Process(gate);

            if (!v.amp_env.IsRunning()) {
                v.voice_state.store(-1, std::memory_order_release);
                v.press_count = 0;
                v.sustain_held = false;
                v.gate = false;
                continue;
            }

            if (ctrl_tick && v.applied_ratio != bend_ratio) {
                v.applied_ratio = bend_ratio;
                v.osc.SetFreq(bend_ratio == 1.0f ? v.base_freq : clamp_f(v.base_freq * bend_ratio, LEAD_MIN_FREQ, LEAD_MAX_FREQ));
            }

            float raw_osc = v.osc.Process();

            // Динамическая модуляция частоты среза LPF огибающей (control rate, без sinf/powf на каждый сэмпл)
            if (ctrl_tick) {
                float cutoff = base_cutoff + f_env_val * env_amt;
                cutoff = clamp_f(cutoff, LEAD_MIN_CUTOFF, LEAD_MAX_CUTOFF);

                bool need_freq = fabsf(cutoff - v.applied_cutoff) > LEAD_CUTOFF_EPS;
                if (v.applied_res != res_val) {
                    v.filter.SetRes(res_val);
                    v.applied_res = res_val;
                    need_freq = true; // SetFreq() пересчитывает демпфирование с новым резонансом
                }
                if (need_freq) {
                    v.filter.SetFreq(cutoff);
                    v.applied_cutoff = cutoff;
                }
            }

            v.filter.Process(raw_osc);

            float filtered_sample = v.filter.Low();
            float sample_f = filtered_sample * amp_val * v.velocity_gain;

            active_voices_count++;
            mix_sum_f += sample_f;
        }
    }

    // Плавная нормировка по числу звучащих голосов (см. LEAD_GAIN_*)
    const float target_gain = kVoiceNorm[active_voices_count];
    const float gain_coef = (target_gain < mix_norm_gain) ? mix_gain_fall_coef : mix_gain_rise_coef;
    mix_norm_gain += gain_coef * (target_gain - mix_norm_gain);

    // 1.0 = полная шкала int16. Мягкий ограничитель гарантирует |y| <= LEAD_LIMIT_CEIL без жёсткого среза.
    const float output_sample_f = soft_limit(mix_sum_f * mix_norm_gain * LEAD_MASTER_GAIN);

    return (int16_t)(output_sample_f * 32767.0f);
}

void LeadSynth_FillStereoBuffer(int16_t *buffer, uint32_t num_frames) {
    if (!SynthArena_IsOwner(&voices)) {     // арену забрал другой движок или Init() ещё не вызывался
        std::memset(buffer, 0, (size_t)num_frames * 2U * sizeof(int16_t));
        return;
    }
    for (uint32_t i = 0; i < num_frames; i++) {
        int16_t sample = LeadSynth_NextSample();
        buffer[i * 2]     = sample; // L
        buffer[i * 2 + 1] = sample; // R
    }
}
