purrrock/purrmidi/Engine/synth/synth_engine.cpp

/*
 * Рантайм-диспетчер звуковых движков: epiano / pluck / lead / organ / violin / soundfont
 * (пресеты SF2 — отдельные программы в конце списка).
 * Выбор движка делается MIDI-сообщением Program Change (см. synth_engine.h).
 *
 * Потоковая модель
 * ----------------
 * Состояние каждого движка принадлежит аудиоконтексту, а события в него
 * приходят из main через собственные lock-free FIFO. Смена движка вызывает
 * Init() нового движка (сброс его FIFO и голосов), поэтому она не должна идти
 * одновременно с FillStereoBuffer(). Для этого используется флаг-замок g_busy:
 *
 *   - FillStereoBuffer берёт замок через test_and_set БЕЗ ожидания; если замок
 *     занят (идёт смена движка) — отдаёт тишину и сразу возвращается. Поэтому
 *     аудио-контекст на STM32 (PendSV) никогда не зависает на замке, который держит main.
 *   - Select() берёт замок с ожиданием. На STM32 рендер идёт в PendSV, который
 *     выполняется до конца и не может быть прерван main (его вытесняют только
 *     другие прерывания, а они движки не трогают), так что замок гарантированно
 *     свободен; на ПК аудио-поток держит замок лишь на время одного блока.
 */

#include "synth_engine.h"
#include "synth_common.h"
#include "epiano_synth.h"
#include "lead_synth.h"
#include "organ_synth.h"
#include "pluck_synth.h"
#include "soundfont_synth.h"
#include "violin_synth.h"
#if SYNTH_REVERB_ENABLE
#include "reverb.h"
#endif

#include <atomic>
#include <cmath>
#include <cstdio>
#include <cstring>
#include <cstdint>

/* Те же правила, что в soundfont_synth.cpp: на ПК (и в тестах) тактов DWT нет. */
#ifndef SYNTH_HOST_MODE
#if defined(PURRMIDI_HOST_BUILD) || defined(_WIN32) || defined(WIN32) || defined(__unix__) || defined(__APPLE__)
#define SYNTH_HOST_MODE 1
#else
#define SYNTH_HOST_MODE 0
#endif
#endif

#if SYNTH_REVERB_ENABLE && !SYNTH_HOST_MODE
#include "stm32h7xx.h"   /* DWT->CYCCNT: время рендера движка для защиты реверберации от перегрузки */
#endif

namespace {

struct Engine {
    const char *name;
    void (*init)(void);
    void (*note_on)(uint8_t, uint8_t);
    void (*note_off)(uint8_t);
    void (*control_change)(uint8_t, uint8_t);
    void (*fill)(int16_t *, uint32_t);
    /* Необязательные обработчики (nullptr = движок не поддерживает, сообщение игнорируется). */
    void (*pitch_bend)(int16_t);
    void (*channel_pressure)(uint8_t);
    void (*poly_pressure)(uint8_t, uint8_t);
};

/* Индекс в таблице == SynthEngineId == номер MIDI-программы. */
const Engine kEngines[SYNTH_ENGINE_COUNT] = {
    /* SYNTH_ENGINE_EPIANO */
    { "epiano", EPianoSynth_Init, EPianoSynth_NoteOn, EPianoSynth_NoteOff,
      EPianoSynth_ControlChange, EPianoSynth_FillStereoBuffer, EPianoSynth_PitchBend, nullptr, nullptr },
    /* SYNTH_ENGINE_PLUCK */
    { "pluck", PluckSynth_Init, PluckSynth_NoteOn, PluckSynth_NoteOff,
      PluckSynth_ControlChange, PluckSynth_FillStereoBuffer, PluckSynth_PitchBend, nullptr, nullptr },
    /* SYNTH_ENGINE_LEAD */
    { "lead", LeadSynth_Init, LeadSynth_NoteOn, LeadSynth_NoteOff,
      LeadSynth_ControlChange, LeadSynth_FillStereoBuffer, LeadSynth_PitchBend, nullptr, nullptr },
    /* SYNTH_ENGINE_ORGAN */
    { "organ", OrganSynth_Init, OrganSynth_NoteOn, OrganSynth_NoteOff,
      OrganSynth_ControlChange, OrganSynth_FillStereoBuffer, OrganSynth_PitchBend, nullptr, nullptr },
    /* SYNTH_ENGINE_VIOLIN */
    { "violin", ViolinSynth_Init, ViolinSynth_NoteOn, ViolinSynth_NoteOff,
      ViolinSynth_ControlChange, ViolinSynth_FillStereoBuffer, ViolinSynth_PitchBend, ViolinSynth_ChannelPressure, nullptr },
    /* SYNTH_ENGINE_SOUNDFONT */
    { "soundfont", SoundFontSynth_Init, SoundFontSynth_NoteOn, SoundFontSynth_NoteOff,
      SoundFontSynth_ControlChange, SoundFontSynth_FillStereoBuffer, SoundFontSynth_PitchBend, nullptr, nullptr },
};

std::atomic<const Engine *> g_active{nullptr};   /* nullptr до первого SynthEngine_Init() */
std::atomic_flag            g_busy = ATOMIC_FLAG_INIT;

/*
 * Общая (master) громкость. PCM5102A не имеет регистров громкости (у него нет ни I2C, ни SPI),
 * поэтому громкость регулируется программно: после рендера активного движка выходные
 * отсчёты умножаются на коэффициент. Значение — MIDI-уровень 0..127 (CC SYNTH_MASTER_VOLUME_CC).
 * Пишется из main, читается из аудио-контекста; атомарно, без замков.
 */
std::atomic<uint8_t> g_master_vol{SYNTH_MASTER_VOLUME_DEFAULT};
float                g_master_gain_applied = 1.0f;   /* коэффициент в конце прошлого блока (только аудио-контекст) */

/* Индекс пресета SF2, выбранный пользователем (имеет смысл, пока активен SoundFont; хранится в main-контексте).
 * Переживает Panic() и повторную активацию движка. */
uint32_t             g_sf_preset = 0;

#if SYNTH_REVERB_ENABLE
/*
 * Общая реверберация. Состояние (около 38 КБ) лежит в .bss, на STM32 это DTCM. Глубина - как громкость: пишется из main,
 * читается из аудио-контекста, атомарно. Решение «разрешена ли» принимает защита по времени рендера движка.
 */
synth::Reverb          g_reverb;
std::atomic<uint8_t>   g_reverb_level{SYNTH_REVERB_DEFAULT};
synth::ReverbLoadGuard g_reverb_guard{SYNTH_REVERB_SHED_PCT, SYNTH_REVERB_RESTORE_PCT, 2U, SYNTH_REVERB_RESTORE_BLOCKS};
std::atomic<bool>      g_reverb_shed{false};   /* зеркало состояния защиты для SynthEngine_IsReverbShed() */

#if !SYNTH_HOST_MODE
inline uint32_t clock_cycles() { return DWT->CYCCNT; }
inline uint32_t block_budget_cycles(uint32_t frames) { return (SystemCoreClock / 48000U) * frames; }
#else
uint32_t (*g_test_clock)(void) = nullptr;
uint32_t   g_test_block_budget = 0U;   /* такты на блок из 128 кадров */
inline uint32_t clock_cycles() { return g_test_clock ? g_test_clock() : 0U; }
inline uint32_t block_budget_cycles(uint32_t frames)
{
    return g_test_clock ? (uint32_t)(((uint64_t)g_test_block_budget * frames) / 128U) : 0U;
}
#endif

/* Глубина 0..127 -> усиление мокрого сигнала: MAX * n^1.25 (n^1.25 = n * sqrt(sqrt(n)), без powf). */
float reverb_level_to_wet(uint8_t level)
{
    if (level == 0U) {
        return 0.0f;
    }
    const float n = (float)level * (1.0f / 127.0f);
    return SYNTH_REVERB_MAX_WET * n * std::sqrt(std::sqrt(n));
}
#endif /* SYNTH_REVERB_ENABLE */

/* Короткие имена встроенных движков для дисплея (до 17 символов, ASCII). Порядок = SynthEngineId. */
const char * const kDisplayNames[SYNTH_ENGINE_SOUNDFONT] = {
    "E-Piano", "Pluck", "Lead", "Organ", "Violin"
};

/* Число пресетов SF2, видимых в списке программ (минимум 1: «SoundFont» как место для ошибки при отсутствии банка). */
uint32_t sf_slot_count()
{
    const uint32_t n = SoundFontSynth_GetPresetCount();
    return n ? n : 1U;
}

/* Положение колеса высоты тона (-8192..8191). Запоминается здесь, чтобы смена движка (его Init() сбрасывает колесо)
 * не «отпускала» удерживаемое колесо. Пишется и читается только из main-контекста. */
int16_t              g_pitch_bend = 0;

/*
 * Какие ноты сейчас удерживаются (число нажатий на ноту, по входящим Note On / Note Off). Нужно для All Notes Off (CC123):
 * он выполняется здесь, в общем коде, одинаково для всех движков - как набор обычных Note Off по всем удерживаемым нотам.
 * Так отпускание идёт через тот же проверенный путь (очередь событий, естественный релиз, педаль), что и у реальной
 * клавиатуры, а не у каждого движка своим кодом. Пишется и читается только из main-контекста.
 */
uint8_t              g_held[128] = {};

/* Сколько Note Off по одной ноте отправляем при All Notes Off (одна нота могла быть нажата несколько раз). */
constexpr uint8_t    kMaxPressesReleased = 8;

void held_clear()
{
    std::memset(g_held, 0, sizeof(g_held));
}

/* All Notes Off: отпустить все удерживаемые ноты и снять педаль (ноты, которые держала педаль, тоже затухают).
 * Звучащие хвосты доигрывают естественным релизом; мгновенное гашение - CC120. */
void all_notes_off(const Engine *e)
{
    for (uint32_t n = 0; n < 128U; ++n) {
        uint8_t cnt = g_held[n];
        if (cnt > kMaxPressesReleased) {
            cnt = kMaxPressesReleased;
        }
        while (cnt--) {
            e->note_off((uint8_t)n);
        }
    }
    held_clear();
    e->control_change(64, 0);
}

/* Уровень 0..127 -> линейный коэффициент. Квадратичная кривая ≈ естественная для слуха; 127 -> 1.0, 0 -> 0. */
float volume_to_gain(uint8_t v)
{
    const float n = (float)v * (1.0f / 127.0f);
    return n * n;
}

/* Применяет master-громкость к блоку. Коэффициент линейно меняется от прошлого значения к новому
 * внутри блока, поэтому при вращении ручки нет «ступенек» и щелчков. */
void apply_master_volume(int16_t *buffer, uint32_t num_frames)
{
    const float target = volume_to_gain(g_master_vol.load(std::memory_order_relaxed));
    float       g      = g_master_gain_applied;

    if (g == target && target == 1.0f) {
        return;   /* единичное усиление: ничего не делаем */
    }

    const float step = (num_frames > 0U) ? (target - g) / (float)num_frames : 0.0f;
    for (uint32_t i = 0; i < num_frames; i++) {
        g += step;
        const int32_t l = (int32_t)((float)buffer[2U * i]      * g);
        const int32_t r = (int32_t)((float)buffer[2U * i + 1U] * g);
        buffer[2U * i]      = (int16_t)(l > 32767 ? 32767 : (l < -32768 ? -32768 : l));
        buffer[2U * i + 1U] = (int16_t)(r > 32767 ? 32767 : (r < -32768 ? -32768 : r));
    }
    g_master_gain_applied = target;
}

/* Включает движок: сбрасывает его состояние и делает активным. Только из main-контекста. */
void activate(SynthEngineId id)
{
    const Engine *next = &kEngines[id];

    while (g_busy.test_and_set(std::memory_order_acquire)) {
        /* ждём, пока аудио-поток (ПК) закончит текущий блок */
    }
    next->init();
#if SYNTH_REVERB_ENABLE
    g_reverb.Init();          /* хвост предыдущего инструмента не переходит в новый: состояние как после включения */
    g_reverb_guard.Reset();
    g_reverb_shed.store(false, std::memory_order_relaxed);
#endif
    held_clear();   /* новый движок стартует «с нуля»: ни одной удерживаемой ноты */
    if (id == SYNTH_ENGINE_SOUNDFONT) {
        SoundFontSynth_SelectPreset(g_sf_preset);   /* Init() ставит пресет 0: возвращаем выбранный */
    }
    if (next->pitch_bend) {
        next->pitch_bend(g_pitch_bend);   /* колесо - физический орган: переносим его положение в новый движок */
    }
    g_active.store(next, std::memory_order_relaxed);
    g_busy.clear(std::memory_order_release);
}

} // namespace

extern "C" {

void SynthEngine_Init(void)
{
    g_master_vol.store(SYNTH_MASTER_VOLUME_DEFAULT, std::memory_order_relaxed);
    g_master_gain_applied = volume_to_gain(SYNTH_MASTER_VOLUME_DEFAULT);
#if SYNTH_REVERB_ENABLE
    g_reverb_level.store(SYNTH_REVERB_DEFAULT, std::memory_order_relaxed);   /* глубина после включения всегда одна и та же */
#endif
    g_pitch_bend = 0;
    held_clear();
    activate(SYNTH_ENGINE_DEFAULT);
}

void SynthEngine_Panic(void)
{
    g_pitch_bend = 0;
    held_clear();   /* после отключения клавиатуры положение колеса неизвестно */
    const Engine *cur = g_active.load(std::memory_order_relaxed);
    if (cur) {
        activate((SynthEngineId)(cur - kEngines));
    }
}

void SynthEngine_SetMasterVolume(uint8_t level)
{
    g_master_vol.store(level > 127U ? (uint8_t)127U : level, std::memory_order_relaxed);
}

uint8_t SynthEngine_GetMasterVolume(void)
{
    return g_master_vol.load(std::memory_order_relaxed);
}

void SynthEngine_SetReverb(uint8_t level)
{
#if SYNTH_REVERB_ENABLE
    g_reverb_level.store(level > 127U ? (uint8_t)127U : level, std::memory_order_relaxed);
#else
    (void)level;
#endif
}

uint8_t SynthEngine_GetReverb(void)
{
#if SYNTH_REVERB_ENABLE
    return g_reverb_level.load(std::memory_order_relaxed);
#else
    return 0U;
#endif
}

int SynthEngine_IsReverbShed(void)
{
#if SYNTH_REVERB_ENABLE
    return g_reverb_shed.load(std::memory_order_relaxed) ? 1 : 0;
#else
    return 0;
#endif
}

#if SYNTH_REVERB_ENABLE && SYNTH_HOST_MODE
void SynthEngine_SetClockForTest(uint32_t (*now)(void), uint32_t block_budget_cycles_per_128)
{
    g_test_clock        = now;
    g_test_block_budget = block_budget_cycles_per_128;
}
#endif

int SynthEngine_Select(SynthEngineId id)
{
    if ((unsigned)id >= (unsigned)SYNTH_ENGINE_COUNT) {
        return 0;
    }
    if (g_active.load(std::memory_order_relaxed) != &kEngines[id]) {
        activate(id);
    }
    return 1;
}

uint32_t SynthEngine_GetProgramCount(void)
{
    return (uint32_t)SYNTH_ENGINE_SOUNDFONT + sf_slot_count();
}

uint32_t SynthEngine_GetProgram(void)
{
    const SynthEngineId id = SynthEngine_GetCurrent();
    return (id == SYNTH_ENGINE_SOUNDFONT) ? (uint32_t)SYNTH_ENGINE_SOUNDFONT + g_sf_preset : (uint32_t)id;
}

int SynthEngine_SelectProgram(uint32_t program)
{
    if (program >= SynthEngine_GetProgramCount()) {
        return 0;
    }
    if (program < (uint32_t)SYNTH_ENGINE_SOUNDFONT) {
        return SynthEngine_Select((SynthEngineId)program);
    }

    g_sf_preset = program - (uint32_t)SYNTH_ENGINE_SOUNDFONT;
    if (g_active.load(std::memory_order_relaxed) != &kEngines[SYNTH_ENGINE_SOUNDFONT]) {
        activate(SYNTH_ENGINE_SOUNDFONT);            /* внутри activate() применяется g_sf_preset */
    } else {
        SoundFontSynth_SelectPreset(g_sf_preset);    /* смена тембра без сброса звучащих нот */
    }
    return 1;
}

void SynthEngine_GetProgramName(uint32_t program, char *out, uint32_t out_size)
{
    if (!out || out_size == 0U) {
        return;
    }
    out[0] = '\0';

    if (program < (uint32_t)SYNTH_ENGINE_SOUNDFONT) {
        std::snprintf(out, out_size, "%s", kDisplayNames[program]);
        return;
    }

    const char *name = SoundFontSynth_GetPresetName(program - (uint32_t)SYNTH_ENGINE_SOUNDFONT);
    if (!name || !name[0]) {
        std::snprintf(out, out_size, "SoundFont");
        return;
    }
    std::snprintf(out, out_size, "SF:%s", name);

    /* Имя пресета в банке дополнено пробелами и может содержать не-ASCII: оставляем печатные символы ASCII. */
    for (uint32_t k = 0; out[k]; ++k) {
        if ((unsigned char)out[k] < 0x20U || (unsigned char)out[k] > 0x7EU) {
            out[k] = '?';
        }
    }
    uint32_t len = (uint32_t)std::strlen(out);
    while (len > 3U && out[len - 1U] == ' ') {
        out[--len] = '\0';
    }
}

SynthEngineId SynthEngine_SelectNext(void)
{
    const uint32_t total = SynthEngine_GetProgramCount();
    uint32_t       prog  = SynthEngine_GetProgram();

    for (uint32_t i = 0; i < total; i++) {
        prog = (prog + 1U) % total;
        const bool is_sf = prog >= (uint32_t)SYNTH_ENGINE_SOUNDFONT;
        if (!is_sf || SynthEngine_IsAvailable(SYNTH_ENGINE_SOUNDFONT)) {
            break;
        }
    }
    SynthEngine_SelectProgram(prog);
    return SynthEngine_GetCurrent();
}

void SynthEngine_ProgramChange(uint8_t program)
{
    SynthEngine_SelectProgram((uint32_t)program % SynthEngine_GetProgramCount());
}

int SynthEngine_IsAvailable(SynthEngineId id)
{
    if ((unsigned)id >= (unsigned)SYNTH_ENGINE_COUNT) {
        return 0;
    }
    if (id == SYNTH_ENGINE_SOUNDFONT) {
        return SoundFontSynth_IsAvailable() ? 1 : 0;
    }
    return 1;
}

SynthEngineId SynthEngine_GetCurrent(void)
{
    const Engine *e = g_active.load(std::memory_order_relaxed);
    return e ? (SynthEngineId)(e - kEngines) : SYNTH_ENGINE_DEFAULT;
}

const char *SynthEngine_GetEngineName(SynthEngineId id)
{
    return ((unsigned)id < (unsigned)SYNTH_ENGINE_COUNT) ? kEngines[id].name : "?";
}

const char *SynthEngine_GetName(void)
{
    return SynthEngine_GetEngineName(SynthEngine_GetCurrent());
}

void SynthEngine_NoteOn(uint8_t midi_note, uint8_t velocity)
{
    if (velocity == 0U) {
        SynthEngine_NoteOff(midi_note);   /* velocity 0 == Note Off */
        return;
    }
    const Engine *e = g_active.load(std::memory_order_relaxed);
    if (e) {
        if (midi_note < 128U && g_held[midi_note] < 255U) {
            g_held[midi_note]++;
        }
        e->note_on(midi_note, velocity);
    }
}

void SynthEngine_NoteOff(uint8_t midi_note)
{
    const Engine *e = g_active.load(std::memory_order_relaxed);
    if (e) {
        if (midi_note < 128U && g_held[midi_note] > 0U) {
            g_held[midi_note]--;
        }
        e->note_off(midi_note);
    }
}

void SynthEngine_ControlChange(uint8_t control, uint8_t value)
{
    if (control == SYNTH_MASTER_VOLUME_CC) {
        /* Общая громкость обрабатывается здесь и в движки не передаётся (чтобы не применялась дважды). */
        SynthEngine_SetMasterVolume(value);
        return;
    }
#if SYNTH_REVERB_ENABLE
    if (control == SYNTH_REVERB_CC) {
        /* Общая реверберация: тоже обрабатывается здесь, движки CC91 не видят. */
        SynthEngine_SetReverb(value);
        return;
    }
#endif

    const Engine *e = g_active.load(std::memory_order_relaxed);
    if (!e) {
        return;
    }

    if (control == 123) {
        /* All Notes Off: общий код для всех движков (см. all_notes_off). */
        all_notes_off(e);
        return;
    }
    if (control == 120) {
        /* All Sound Off: каждый движок гасит свои голоса быстро и без щелчка и сбрасывает педаль; нажатые клавиши
         * после этого считаются отпущенными. Остальные настройки (яркость, регистры органа и т.д.) не меняются. */
        held_clear();
#if SYNTH_REVERB_ENABLE
        g_reverb.Kill();   /* хвост реверберации гаснет вместе с голосами (за ~21 мс) */
#endif
    }
    e->control_change(control, value);
}

void SynthEngine_PitchBend(int16_t bend)
{
    g_pitch_bend = bend < -8192 ? (int16_t)-8192 : (bend > 8191 ? (int16_t)8191 : bend);

    const Engine *e = g_active.load(std::memory_order_relaxed);
    if (e && e->pitch_bend) {
        e->pitch_bend(g_pitch_bend);
    }
}

void SynthEngine_ChannelPressure(uint8_t pressure)
{
    const Engine *e = g_active.load(std::memory_order_relaxed);
    if (e && e->channel_pressure) {
        e->channel_pressure(pressure > 127U ? (uint8_t)127U : pressure);
    }
}

void SynthEngine_PolyPressure(uint8_t midi_note, uint8_t pressure)
{
    const Engine *e = g_active.load(std::memory_order_relaxed);
    if (e && e->poly_pressure && midi_note < 128U) {
        e->poly_pressure(midi_note, pressure > 127U ? (uint8_t)127U : pressure);
    }
}

void SynthEngine_FillStereoBuffer(int16_t *buffer, uint32_t num_frames)
{
    if (g_busy.test_and_set(std::memory_order_acquire)) {
        /* Идёт смена синтезатора: отдаём тишину, не ожидая замка. */
        std::memset(buffer, 0, (size_t)num_frames * 2U * sizeof(int16_t));
        return;
    }

    synth::EnableFlushToZero();   /* денормали сильно замедляют затухающие хвосты (см. synth_common.h) */

    const Engine *e = g_active.load(std::memory_order_relaxed);
    if (e) {
#if SYNTH_REVERB_ENABLE
        const uint32_t t0 = clock_cycles();
        e->fill(buffer, num_frames);
        const uint32_t dt = clock_cycles() - t0;   /* только движок: эффект не должен раскачивать собственное решение */
        const bool allowed = g_reverb_guard.Update(dt, block_budget_cycles(num_frames));
        g_reverb_shed.store(!allowed, std::memory_order_relaxed);
        g_reverb.Process(buffer, num_frames, allowed ? reverb_level_to_wet(g_reverb_level.load(std::memory_order_relaxed)) : 0.0f);
#else
        e->fill(buffer, num_frames);
#endif
        apply_master_volume(buffer, num_frames);
    } else {
        std::memset(buffer, 0, (size_t)num_frames * 2U * sizeof(int16_t));
    }

    g_busy.clear(std::memory_order_release);
}

} // extern "C"
