purrrock/purrmidi/Platform/display/splash_logo.h

/* Создано tools/gen_splash_logo.py из logo/PurrMIDI_03_candy_keys.png. Вручную не править. */
#ifndef SPLASH_LOGO_DATA_H
#define SPLASH_LOGO_DATA_H

#include <stdint.h>

#define SPLASH_BG_R 255
#define SPLASH_BG_G 255
#define SPLASH_BG_B 255

#define SPLASH_LOGO_W 84
#define SPLASH_LOGO_H 72

/* RGB565, строки сверху вниз; цвета уже смешаны со светлым фоном заставки. */
static const uint16_t splash_logo[SPLASH_LOGO_W * SPLASH_LOGO_H] =
{
    0xFFFF, 0xFFFF, 0xFFFF, 0xFFFF, 0xFFFF, 0xFFFF, 0xFFFF, 0xFFFF, 0xFFFF, 0xFFFF, 0xFFFF, 0xFFFF, 0xFFFF, 0xFFFF, 0xFFFF, 0xFFFF, 0xFFFF, 0xFFFF, 0xFFFF, 0xFFFF, 0xFFFF, 0xFFFF, 0xFFFF, 0xFFFF, 0xFFFF, 0xFFFF, 0xFFFF, 0xFFFF, 0xFFFF, 0xFFFF, 0xFFFF, 0xFFFF, 0xFFFF, 0xFFFF, 0xFFFF, 0xFFFF, 0xFFFF, 0xFFFF, 0xFFFF, 0xFFFF, 0xFFFF, 0xFFFF, 0xFFFF, 0xFFFF, 0xFFFF, 0xFFFF, 0xFFFF, 0xFFFF, 0xFFFF, 0xFFFF, 0xFFFF, 0xFFFF, 0xFFFF, 0xFFFF, 0xFFFF, 0xFFFF, 0xFFFF, 0xFFFF, 0xFFFF, 0xFFFF, 0xFFFF, 0xFFFF, 0xFFFF, 0xFFFF, 0xFFFF, 0xFFFF, 0xFFFF, 0xFFFF, 0xFFFF, 0xFFFF, 0xFFFF, 0xFFFF, 0xFFFF, 0xFFFF, 0xFFFF, 0xFFFF, 0xFFFF, 0xFFFF, 0xFFFF, 0xFFFF, 0xFFFF, 0xFFFF, 0xFFFF, 0xFFFF,
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
    0xFFFF, 0xFFFF, 0xFFFF, 0xFFFF, 0xFFFF, 0xFFFF, 0xFFFF, 0xFFFF, 0xFFFF, 0xFFFF, 0xFFFF, 0xFFFF, 0x5ACB, 0x0841, 0x08A2, 0x4146, 0xFB74, 0xFB53, 0xFB53, 0xFB53, 0xFB53, 0xFB53, 0xFB53, 0xFB53, 0xFB94, 0x922B, 0x0081, 0x18A3, 0x10A2, 0x18C2, 0x0862, 0xABE7, 0xFE0A, 0xFDA9, 0xFDC9, 0xFDC9, 0xFDA9, 0xFDE9, 0xD4C8, 0x10A2, 0x10A2, 0x10A2, 0x10C3, 0x1041, 0x2A47, 0x56F5, 0x4EB4, 0x4EB5, 0x4EB5, 0x4EB5, 0x4EB4, 0x56F5, 0x2207, 0x1061, 0x10C3, 0x10A2, 0x10A2, 0x18E4, 0x641D, 0x6C7F, 0x6C5F, 0x6C7F, 0x6C7F, 0x6C7F, 0x6C7F, 0x6C5F, 0x749F, 0x5B98, 0x1081, 0x18C3, 0x0861, 0xC618, 0xFFFF, 0xFFFF, 0xFFFF, 0xFFFF, 0xFFFF, 0xFFFF, 0xFFFF, 0xFFFF, 0xFFFF, 0xFFFF, 0xFFFF, 0xFFFF,
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
};

#endif /* SPLASH_LOGO_DATA_H */
