purrrock/purrmidi/Platform/sd/sd_storage.c

/**
 * @file    sd_storage.c
 * @brief   FatFs-драйвер диска (только чтение) поверх HAL SD (SDMMC1, IDMA) с bounce-буфером.
 *
 * SD-карта нужна прошивке только при запуске: sf2_loader.c читает с неё 0:/SNDFNT.SF2, чтобы обновить
 * SoundFont-банк в QSPI Flash, после чего SDStorage_Unmount() выключает SDMMC1. Запись на карту не нужна.
 *
 * Требования к проекту (см. README, раздел "Работа с SD-картой"):
 *  - в CubeMX включён SDMMC1 (4 бита), FATFS в режиме "User-defined";
 *  - вызов MX_SDMMC1_SD_Init() и MX_FATFS_Init() отключён
 *    (Project Manager -> Advanced Settings -> Generated Function Calls): сгенерированный
 *    MX_SDMMC1_SD_Init() при отсутствии карты вызывает Error_Handler() и вешает прибор, а карта
 *    теперь вставлена только на время обновления банка;
 *  - FatFs: _FS_READONLY = 1, _MIN_SS = _MAX_SS = 512.
 */
#include "sd_storage.h"

#include "main.h"
#include "sdmmc.h"        /* extern SD_HandleTypeDef hsd1 */
#include "ff.h"
#include "ff_gen_drv.h"

#include <stdint.h>
#include <stdio.h>
#include <string.h>

/* ----------------------------- настройки ----------------------------------- */

/* SDMMC_CK = kernel_clk / (2 * SD_CLOCK_DIV). При kernel 192 МГц: 4 -> 24 МГц. */
#ifndef SD_CLOCK_DIV
#define SD_CLOCK_DIV            4U
#endif

/* Размер bounce-буфера в секторах (16 -> 8 КБ в AXI SRAM, секция .sd_dma_buffer). */
#ifndef SD_BOUNCE_SECTORS
#define SD_BOUNCE_SECTORS       16U
#endif

/* Максимум секторов за одну прямую DMA-передачу (128 -> 64 КБ). */
#ifndef SD_DIRECT_MAX_SECTORS
#define SD_DIRECT_MAX_SECTORS   128U
#endif

#ifndef SD_READ_TIMEOUT_MS
#define SD_READ_TIMEOUT_MS      1000U
#endif

#define SD_SECTOR_SIZE          512U

/* IDMA SDMMC1 находится в домене D1 и видит ТОЛЬКО AXI SRAM (ST AN5200). D2 SRAM (.dma_buffer), DTCM и SRAM4 для
 * него недоступны: чтение оттуда даёт зависшую передачу/мусор, и f_mount падает с FR_DISK_ERR. Поэтому и bounce-буфер,
 * и прямые буферы обязаны лежать в AXI SRAM. */
#define DMA_RAM_BASE            0x24000000UL
#define DMA_RAM_SIZE            (512UL * 1024UL)

/* ------------------------------ состояние ---------------------------------- */

static uint8_t s_bounce[SD_BOUNCE_SECTORS * SD_SECTOR_SIZE]
    __attribute__((section(".sd_dma_buffer"), aligned(32)));

static FATFS s_fs;
static char  s_path[4];                 /* заполняет FATFS_LinkDriver: "0:/" */
static volatile uint8_t s_xfer_state;   /* 0 - идёт, 1 - готово, 2 - ошибка */
static uint8_t s_hw_ready;              /* SDMMC1 + карта инициализированы */
static uint8_t s_linked;
static uint8_t s_mounted;
static SDStorage_Diag s_diag = { SDS_OK, -1, -1, 0U, -1, -1, 0, 0U, 0U, 0U };

/* ----------------------- callbacks HAL (вызываются из IRQ) ------------------ */

void HAL_SD_RxCpltCallback(SD_HandleTypeDef *hsd)    { if (hsd == &hsd1) s_xfer_state = 1; }
void HAL_SD_ErrorCallback(SD_HandleTypeDef *hsd)     { if (hsd == &hsd1) s_xfer_state = 2; }
void HAL_SD_AbortCallback(SD_HandleTypeDef *hsd)     { if (hsd == &hsd1) s_xfer_state = 2; }

/* ------------------------------ вспомогательное ----------------------------- */

static inline bool dcache_enabled(void)
{
    return (SCB->CCR & SCB_CCR_DC_Msk) != 0U;
}

/* Буфер можно отдавать IDMA напрямую: он целиком лежит в AXI SRAM и выровнен.
 * 4 байта нужно самому IDMA; при включённом D-cache требуем 32 байта (строка кэша): AXI SRAM кэшируется write-back,
 * а размер передачи (кратный 512 байтам) тогда тоже кратен строке, так что инвалидация не заденет соседние данные. */
static bool buffer_is_dma_safe(const void *p, uint32_t bytes)
{
    uint32_t a = (uint32_t)(uintptr_t)p;
    uint32_t align_mask = dcache_enabled() ? 31U : 3U;

    if ((a & align_mask) != 0U) return false;
    if (a < DMA_RAM_BASE || (a + bytes) > (DMA_RAM_BASE + DMA_RAM_SIZE)) return false;
    return true;
}

/* Запоминает первую ошибку чтения для SDStorage_PrintDiag(): FatFs наружу отдаёт только FR_DISK_ERR. */
static void note_read_fail(int stage, uint32_t sector)
{
    if (s_diag.rd_stage != 0) return;
    s_diag.rd_stage      = stage;
    s_diag.rd_sector     = sector;
    s_diag.rd_error      = HAL_SD_GetError(&hsd1);
    s_diag.rd_card_state = (uint32_t)HAL_SD_GetCardState(&hsd1);
}

static int wait_card_ready(uint32_t timeout_ms)
{
    uint32_t t0 = HAL_GetTick();
    while (HAL_SD_GetCardState(&hsd1) != HAL_SD_CARD_TRANSFER) {
        if ((HAL_GetTick() - t0) > timeout_ms) return -1;
    }
    return 0;
}

static int wait_xfer_done(uint32_t timeout_ms)
{
    uint32_t t0 = HAL_GetTick();
    while (s_xfer_state == 0U) {
        if ((HAL_GetTick() - t0) > timeout_ms) {
            (void)HAL_SD_Abort(&hsd1);
            return -1;
        }
    }
    return (s_xfer_state == 1U) ? 0 : -1;
}

/* Одна DMA-передача n секторов; buf обязан быть DMA-safe. */
static int xfer_read(uint8_t *buf, uint32_t sector, uint32_t n)
{
    if (wait_card_ready(SD_READ_TIMEOUT_MS) != 0) { note_read_fail(1, sector); return -1; }
    /* AXI SRAM кэшируется (write-back): грязные строки буфера не должны вытесниться поверх данных IDMA. */
    if (dcache_enabled()) {
        SCB_InvalidateDCache_by_Addr((uint32_t *)buf, (int32_t)(n * SD_SECTOR_SIZE));
    }
    s_xfer_state = 0;
    if (HAL_SD_ReadBlocks_DMA(&hsd1, buf, sector, n) != HAL_OK) { note_read_fail(2, sector); return -1; }
    if (wait_xfer_done(SD_READ_TIMEOUT_MS) != 0) { note_read_fail(3, sector); return -1; }
    if (dcache_enabled()) {
        SCB_InvalidateDCache_by_Addr((uint32_t *)buf, (int32_t)(n * SD_SECTOR_SIZE));
    }
    return 0;
}

/* ------------------------------ диск-драйвер FatFs -------------------------- */

static DSTATUS sd_status(BYTE lun)
{
    (void)lun;
    return s_hw_ready ? 0 : STA_NOINIT;
}

static DSTATUS sd_initialize(BYTE lun)
{
    /* Само железо инициализирует SDStorage_Mount(); тут только отдаём статус. */
    return sd_status(lun);
}

static DRESULT sd_read(BYTE lun, BYTE *buff, DWORD sector, UINT count)
{
    (void)lun;
    if (!s_hw_ready) return RES_NOTRDY;
    if (count == 0U) return RES_PARERR;

    while (count > 0U) {
        uint32_t n = (count > SD_DIRECT_MAX_SECTORS) ? SD_DIRECT_MAX_SECTORS : count;

        if (buffer_is_dma_safe(buff, n * SD_SECTOR_SIZE)) {
            if (xfer_read(buff, sector, n) != 0) return RES_ERROR;
        } else {
            n = (count > SD_BOUNCE_SECTORS) ? SD_BOUNCE_SECTORS : count;
            if (xfer_read(s_bounce, sector, n) != 0) return RES_ERROR;
            memcpy(buff, s_bounce, n * SD_SECTOR_SIZE);
        }
        buff   += n * SD_SECTOR_SIZE;
        sector += n;
        count  -= n;
    }
    return RES_OK;
}

/* Диск только для чтения (_FS_READONLY = 1): FatFs сюда не заходит, заглушка нужна для структуры драйвера. */
static DRESULT sd_write(BYTE lun, const BYTE *buff, DWORD sector, UINT count)
{
    (void)lun; (void)buff; (void)sector; (void)count;
    return RES_WRPRT;
}

static DRESULT sd_ioctl(BYTE lun, BYTE cmd, void *buff)
{
    HAL_SD_CardInfoTypeDef info;
    (void)lun;
    if (!s_hw_ready) return RES_NOTRDY;

    switch (cmd) {
    case CTRL_SYNC:
        return RES_OK;      /* записи нет - синхронизировать нечего */
    case GET_SECTOR_COUNT:
        if (HAL_SD_GetCardInfo(&hsd1, &info) != HAL_OK) return RES_ERROR;
        *(DWORD *)buff = info.LogBlockNbr;
        return RES_OK;
    case GET_SECTOR_SIZE:
        if (HAL_SD_GetCardInfo(&hsd1, &info) != HAL_OK) return RES_ERROR;
        *(WORD *)buff = (WORD)info.LogBlockSize;
        return RES_OK;
    case GET_BLOCK_SIZE:
        if (HAL_SD_GetCardInfo(&hsd1, &info) != HAL_OK) return RES_ERROR;
        *(DWORD *)buff = info.LogBlockSize / SD_SECTOR_SIZE;
        return RES_OK;
    default:
        return RES_PARERR;
    }
}

static const Diskio_drvTypeDef s_driver = {
    sd_initialize,
    sd_status,
    sd_read,
    sd_write,
    sd_ioctl,
};

/* ------------------------------ публичный API ------------------------------- */

static int sd_hw_init(void)
{
    /* HAL_SD_DeInit() на необнулённом дескрипторе с Instance == NULL приведёт к HardFault. */
    if (hsd1.State != HAL_SD_STATE_RESET) {
        (void)HAL_SD_DeInit(&hsd1);
    }

    /* Параметры задаём здесь, а не в MX_SDMMC1_SD_Init(): та вызывает Error_Handler()
     * (бесконечный цикл с отключёнными прерываниями), если карты нет. */
    hsd1.Instance                 = SDMMC1;
    hsd1.Init.ClockEdge           = SDMMC_CLOCK_EDGE_RISING;
    hsd1.Init.ClockPowerSave      = SDMMC_CLOCK_POWER_SAVE_DISABLE;
    hsd1.Init.BusWide             = SDMMC_BUS_WIDE_1B;
    hsd1.Init.HardwareFlowControl = SDMMC_HARDWARE_FLOW_CONTROL_DISABLE;
    hsd1.Init.ClockDiv            = SD_CLOCK_DIV;

    s_diag.hal_init = (int)HAL_SD_Init(&hsd1);
    s_diag.hal_error = HAL_SD_GetError(&hsd1);
    if (s_diag.hal_init != (int)HAL_OK) return -1;

    s_diag.hal_wide = (int)HAL_SD_ConfigWideBusOperation(&hsd1, SDMMC_BUS_WIDE_4B);
    s_diag.hal_error = HAL_SD_GetError(&hsd1);
    if (s_diag.hal_wide != (int)HAL_OK) {
        (void)HAL_SD_DeInit(&hsd1);
        return -1;
    }
    return 0;
}

SDStorage_Result SDStorage_Mount(void)
{
    if (s_mounted) return SDS_OK;

    s_diag.result       = SDS_OK;
    s_diag.hal_init     = -1;
    s_diag.hal_wide     = -1;
    s_diag.hal_error    = 0U;
    s_diag.link_ret     = -1;
    s_diag.f_mount_res  = -1;
    s_diag.rd_stage     = 0;
    s_diag.rd_sector    = 0U;
    s_diag.rd_error     = 0U;
    s_diag.rd_card_state = 0U;

    /* Наличие карты не проверяем отдельным датчиком: HAL_SD_Init() сам вернёт ошибку, если карты нет. */
    if (sd_hw_init() != 0) {
        s_diag.result = SDS_ERR_INIT;
        return SDS_ERR_INIT;
    }
    s_hw_ready = 1;

    if (!s_linked) {
        s_diag.link_ret = (int)FATFS_LinkDriver(&s_driver, s_path);
        if (s_diag.link_ret != 0) {
            s_hw_ready = 0;
            (void)HAL_SD_DeInit(&hsd1);
            s_diag.result = SDS_ERR_LINK;
            return SDS_ERR_LINK;
        }
        s_linked = 1;
    }

    s_diag.f_mount_res = (int)f_mount(&s_fs, s_path, 1);
    if (s_diag.f_mount_res != (int)FR_OK) {
        s_hw_ready = 0;
        (void)HAL_SD_DeInit(&hsd1);
        s_diag.result = SDS_ERR_MOUNT;
        return SDS_ERR_MOUNT;
    }

    s_mounted = 1;
    s_diag.result = SDS_OK;
    return SDS_OK;
}

const SDStorage_Diag *SDStorage_GetDiag(void)
{
    return &s_diag;
}

const char *SDStorage_ResultName(SDStorage_Result r)
{
    switch (r) {
    case SDS_OK:          return "OK";
    case SDS_ERR_INIT:    return "INIT (HAL_SD_Init / 4-bit)";
    case SDS_ERR_LINK:    return "LINK (FATFS_LinkDriver)";
    case SDS_ERR_MOUNT:   return "MOUNT (f_mount)";
    default:              return "?";
    }
}

void SDStorage_PrintDiag(void)
{
    fprintf(stderr, "[SD] result=%s\n", SDStorage_ResultName(s_diag.result));
    fprintf(stderr, "[SD] HAL_SD_Init=%d wide4b=%d hsd.ErrorCode=0x%08lX link=%d f_mount=%d\n",
            s_diag.hal_init, s_diag.hal_wide, (unsigned long)s_diag.hal_error,
            s_diag.link_ret, s_diag.f_mount_res);
    if (s_diag.rd_stage != 0) {
        fprintf(stderr, "[SD] first read failure: stage=%d sector=%lu hsd.ErrorCode=0x%08lX card_state=%lu\n",
                s_diag.rd_stage, (unsigned long)s_diag.rd_sector,
                (unsigned long)s_diag.rd_error, (unsigned long)s_diag.rd_card_state);
    }
    if (s_hw_ready) {
        fprintf(stderr, "[SD] card type=%lu blocks=%lu\n",
                (unsigned long)hsd1.SdCard.CardType, (unsigned long)hsd1.SdCard.LogBlockNbr);
    }
}

void SDStorage_ListRoot(void)
{
    DIR dir;
    FILINFO fno;
    FRESULT fr;
    unsigned shown = 0U;

    fr = f_opendir(&dir, s_path);
    if (fr != FR_OK) {
        fprintf(stderr, "[SD] f_opendir('%s') failed: FRESULT=%d\n", s_path, (int)fr);
        return;
    }
    fprintf(stderr, "[SD] root directory '%s':\n", s_path);
    for (;;) {
        fr = f_readdir(&dir, &fno);
        if (fr != FR_OK || fno.fname[0] == 0) break;
        const char *name = fno.fname;   /* в этой версии FatFs тут длинное имя (при _USE_LFN != 0) */
        fprintf(stderr, "[SD]   %s%s  (%lu bytes)\n", name,
                (fno.fattrib & AM_DIR) ? "/" : "", (unsigned long)fno.fsize);
        if (++shown >= 24U) {
            fprintf(stderr, "[SD]   ...\n");
            break;
        }
    }
    if (shown == 0U) fprintf(stderr, "[SD]   (empty)\n");
    (void)f_closedir(&dir);
}

void SDStorage_Unmount(void)
{
    if (s_mounted) {
        (void)f_mount(NULL, s_path, 0);
        s_mounted = 0;
    }
    if (s_hw_ready) {
        s_hw_ready = 0;
        (void)HAL_SD_DeInit(&hsd1);
    }
}

bool SDStorage_IsMounted(void)
{
    return s_mounted != 0U;
}
