purrrock/purrmidi/Engine/synth/violin_synth.h

#ifndef VIOLIN_SYNTH_H
#define VIOLIN_SYNTH_H

#include <stdint.h>
#include <stdbool.h>

/**
 * @file    violin_synth.h
 * @brief   Полифонический синтезатор скрипки на физической модели смычкового инструмента.
 *
 * Модель (J. O. Smith, «Physical Modeling Using Digital Waveguides», 1992; по структуре совпадает с классом
 * Bowed из Synthesis ToolKit, Cook & Scavone):
 *   - струна = два цифровых волновода («гриф» — от смычка к порожку, «подставка» — от смычка к подставке),
 *     замкнутых в петлю; на концах — инвертирующее отражение (порожек) и однополюсный фильтр нижних частот
 *     с потерями (подставка);
 *   - смычок = нелинейная «таблица трения» (прилипание/проскальзывание), которая по разности скоростей смычка и
 *     струны определяет, сколько энергии вводится в обе ветви волновода (движение Гельмгольца);
 *   - дека = банк резонансов корпуса (воздушный резонанс, резонансы верхней/нижней деки, «горб подставки»);
 *     общая для всех голосов, считается после сложения голосов (физически корпус один), L/R слегка расстроены;
 *   - вибрато (задержка включения + плавное нарастание), шум смычка (канифоль) и всплеск шума при атаке.
 *
 * Голосов 8: скрипка сама одноголосна, но с клавиатуры играют легато и аккордами, поэтому ноты могут
 * перекрываться. При нехватке голосов вытесняется самый тихий затухающий, затем самый старый голос;
 * вытесняемый голос предварительно гасится за ~2,7 мс (без щелчка), и только потом в нём стартует новая нота.
 *
 * Память голосов (≈5 КБ на голос) берётся из общей арены (synth_arena.h).
 *
 * Управление по MIDI:
 *     - Note On / Off:   velocity задаёт скорость смычка (громкость, яркость, быстроту атаки);
 *     - Pitch Bend:      ±2 полутона;
 *     - Channel Pressure (aftertouch): подъём скорости смычка (крещендо на удерживаемой ноте);
 *     - CC 1:            мод-колесо: ПРИБАВЛЯЕТ вибрато к умолчанию (в нуле — прежняя глубина, вверх — до максимума);
 *     - CC 2 / CC 11:    экспрессия — общая скорость смычка (динамика);
 *     - CC 64:           педаль сустейна;
 *     - CC 120:          All Sound Off (быстрое гашение всех струн);
 *     - CC 70:           положение смычка (0 — у подставки sul ponticello, ярко; 127 — над грифом sul tasto, мягко).
 *                        Действует на ноты, взятые ПОСЛЕ изменения (длина ветви волновода фиксируется на ноте);
 *     - CC 71:           прижим смычка (мало — флажолетный свист, много — жёсткий, скрипучий звук);
 *     - CC 72:           время отпускания смычка (затухание после Note Off);
 *     - CC 73:           время атаки (скорость «разгона» смычка);
 *     - CC 74:           яркость (потери струны на подставке);
 *     - CC 75:           шум смычка (шорох канифоли).
 *
 * Контракт вызовов (как у остальных движков):
 *   ViolinSynth_Init / NoteOn / NoteOff / ControlChange / PitchBend / ChannelPressure — из main / MIDI-потока;
 *   ViolinSynth_FillStereoBuffer — из PendSV (STM32) или аудио-потока (ПК).
 *   Связь между контекстами — lock-free FIFO событий (synth_common.h) и атомарные параметры.
 *
 * Диапазон нот: G1 (MIDI 31) … C8 (MIDI 108). Ноты за пределами диапазона сворачиваются на целое число октав
 * внутрь (модель не может построить слишком длинную или слишком короткую струну).
 */

#ifdef __cplusplus
extern "C" {
#endif

/** Число голосов. */
#define VIOLIN_VOICES 8

/** Инициализация или сброс синтезатора: голоса создаются в общей арене заново, параметры — по умолчанию. */
void ViolinSynth_Init(void);

/**
 * @brief Нажатие ноты (Note On).
 * @param midi_note Номер MIDI-ноты (0..127).
 * @param velocity  Сила нажатия (1..127; 0 трактуется как Note Off).
 */
void ViolinSynth_NoteOn(uint8_t midi_note, uint8_t velocity);

/** @brief Отпускание ноты (Note Off): смычок снимается со струны, струна затухает. */
void ViolinSynth_NoteOff(uint8_t midi_note);

/** @brief MIDI Control Change (список контроллеров — в описании файла). */
void ViolinSynth_ControlChange(uint8_t control, uint8_t value);

/** @brief Колесо высоты тона: bend = -8192..+8191 (0 — центр), диапазон ±2 полутона. */
void ViolinSynth_PitchBend(int16_t bend);

/** @brief Channel Pressure (aftertouch), 0..127: усиливает смычок звучащих нот. */
void ViolinSynth_ChannelPressure(uint8_t pressure);

/**
 * @brief Блочная генерация стерео-PCM (48 кГц, 16 бит, L R L R ...).
 * Если арену забрал другой движок или Init() ещё не вызывался — выдаёт тишину.
 */
void ViolinSynth_FillStereoBuffer(int16_t *buffer, uint32_t num_frames);

/** @brief Звучит ли сейчас нота (включая затухание после отпускания). Безопасно, если арена чужая (вернёт false). */
bool ViolinSynth_IsNoteActive(uint8_t midi_note);

/** @brief Сколько событий Note On отброшено из-за переполнения очереди (для диагностики и тестов). */
uint32_t ViolinSynth_GetDroppedEventsCount(void);

#ifdef __cplusplus
}
#endif

#endif /* VIOLIN_SYNTH_H */
