purrrock/purrmidi/(commit log)

2026-09-21 printf Removed
2026-09-21 printf Restored, notes count added
2026-09-21 NAK storm prevent, SOF added
    [main.c, usbh_midi.c]
2026-09-22 Fix MIDI event drops by correctly handling URB_NOTREADY on Bulk IN endpoints.
    When the device returns a NAK (`USBH_URB_NOTREADY`), the hardware USB Host controller automatically resubmits the IN token for Bulk endpoints. We should not manually reset the URB state to `MIDI_RECEIVE_DATA`, as doing so disrupts the ongoing transaction and leads to dropped events. We now store the IN endpoint type during initialization and only manually resubmit for Interrupt endpoints.
    [usbh_midi.c, usbh_midi.h]
2026-09-23 Prepare to move on WeAct STM32H743VIT6
2026-09-23 Moved to WeAct STM32H743VIT6 Mini
2026-09-23 Migrate USB MIDI Host logic to STM32H743VIT6
    Adapted the PurrMidi USB Host from OLD_NUCLEO_FILES to current STM32H743VIT6 config.
    - Updated main.c to support MIDI event queuing.
    - Adapted `usb_host.c/h` to initialize the custom USB MIDI class while bypassing default CubeMX.
    - Included usbh_midi.c in CMakeLists.txt and removed older `stm32f4` header dependencies.
    - Added `<stdio.h>` to source files relying on it to prevent build warnings.
    [main.c, usbh_midi.c, usbh_midi.h]
2026-09-23 Fix USB MIDI Endpoint handling and cleanup diagnostics
    * Narrowed endpoint search strictly to the matched MIDI streaming interface to avoid conflicting endpoints.
    * Validated that BOTH IN and OUT endpoints exist; else fail initialization gracefully.
    * Kept track of endpoint types and correctly routed reception via `USBH_InterruptReceiveData` or `USBH_BulkReceiveData` instead of unconditionally using Bulk.
    * Removed redundant tracking variables and consolidated diagnostic printing.
    [main.c, usbh_midi.c]
2026-09-23 Fix USB-MIDI event parsing based on CIN
    - Implemented proper parsing of Cable Number/CIN in the USB-MIDI packet buffer according to the USB-MIDI specification.
    - MIDI event fields (data1, data2) are properly zeroed out when the message is shorter than 3 bytes.
    - 0x0 CIN messages are skipped.
    - Ensured modifications are safely enclosed within CubeMX user blocks.
    [main.c]
2026-09-23 Fix USB MIDI receive handling and avoid infinite UART blocking
    - Replaced HAL_MAX_DELAY in `_write` with a finite 10 ms timeout.
    - Added `midi_receive_errors` diagnostic counter.
    - Checked `USBH_MIDI_Receive` result against `USBH_OK` in `main` and `USBH_MIDI_ReceiveCallback`.
    - Expanded UART stats format to include `RX errors`.
    [main.c]
2026-09-24 Fix: respect RxDataLength in MIDI_ProcessReception
    Calculate rx_length taking RxDataLength into account up to InEpSize,
    and use it for USBH_InterruptReceiveData and USBH_BulkReceiveData.
    [usbh_midi.c]
2026-09-24 Fix USBH_MIDI_Receive behavior on invalid parameters
    - Return `USBH_FAIL` immediately if `pbuff` is `NULL` or `length` is `0`.
    - Preserve internal state of `MIDI_Handle` under these failure conditions.
    [usbh_midi.c]
2026-09-24 Fix USB MIDI receive logic to prevent rx restart
    Prevent a running RX transfer from being restarted if it is
    currently waiting for the receive to complete.
    Specifically, in USBH_MIDI_Receive, if the rx state is
    MIDI_RECEIVE_DATA_WAIT and not MIDI_RECEIVE_DATA, return
    USBH_BUSY without modifying existing state variables.
    [usbh_midi.c]
2026-09-24 Fix USB MIDI reception on URB_NOTREADY
    [usbh_midi.c]
2026-09-24 Fix RX STALL recovery in USB MIDI driver
    Added MIDI_RECEIVE_DATA_STALL state to gracefully handle USBH_URB_STALL by calling USBH_ClrFeature to clear the stall and USBH_LL_SetToggle to reset the data toggle. Also removed printf from the error handling and made sure URB errors return to MIDI_IDLE instead of looping.
    [usbh_midi.c, usbh_midi.h]
2026-09-24 fix: check USB MIDI IN pipe allocation and open results
    Verify result of `USBH_AllocPipe` and `USBH_OpenPipe` for the MIDI IN pipe
    during interface initialization. Free resources and return `USBH_FAIL` if
    an error occurs. Skip `USBH_LL_SetToggle` if the pipe is not opened.
    [usbh_midi.c]
2026-09-24 Make USBH_MIDI_Transmit a stub
    USB MIDI transmission is not used in this project as it only
    receives data from the MIDI keyboard. This commit replaces the
    USBH_MIDI_Transmit implementation with a stub returning USBH_FAIL.
    Unused parameter warnings are suppressed using `(void)` casts.
    [usbh_midi.c]
2026-09-24 Remove unused TX fields from MIDI_HandleTypeDef
    Removes `pTxData`, `TxDataLength`, and `data_tx_state` from the `MIDI_HandleTypeDef` struct in `usbh_midi.h`. These fields were left over from the deleted MIDI TX processor and are no longer necessary, as the PurrMidi project operates unidirectionally (MIDI keyboard to STM32). References in `usbh_midi.c` were already cleaned up previously.
    [usbh_midi.h]
2026-09-24 Remove unused MIDI TX prototypes from Core/Inc/usbh_midi.h
    Removed unused prototypes `USBH_MIDI_Transmit` and `USBH_MIDI_TransmitCallback` from `Core/Inc/usbh_midi.h`. Verified that there are no actual calls to these functions in the repository. All other functions, RX state machine, MIDI parser, main.c, and other configurations are left unchanged as requested.
2026-09-24 Fix USB MIDI RX state machine and prevent race conditions
    - USBH_MIDI_Receive() now strictly checks MIDI_IDLE state to avoid overriding active transfers.
    - Removed redundant re-arm calls from USBH_MIDI_ReceiveCallback() in main.c.
    - MIDI_ProcessReception() now safely delegates re-arming by automatically setting state to MIDI_RECEIVE_DATA after URB_DONE.
    - Added NULL pointer checks in USBH_MIDI_InterfaceDeInit() to prevent hard faults during device detachment.
    [main.c, usbh_midi.c]
2026-09-24 feat: add basic wavetable synth module
    Implements a standalone software synthesizer module that generates
    a monophonic 48kHz sine wave in int16_t PCM format. It uses a phase
    accumulator and wavetable to avoid floating-point math overhead during
    sample generation. Includes minimal API for init, start, stop, frequency,
    and amplitude control.
    Added to CMake build system.
    [synth.c, synth.h]
2026-09-25 Added HAL Drivers
2026-09-26 Fix DaisySP Pluck linker error and build LGPL sources
    Root cause: Core/Src/pluck_synth.cpp included DaisySP-LGPL/Source/PhysicalModeling/pluck.h using a relative path, but CMakeLists.txt only compiled sources from DaisySP/Source/*.cpp into libDaisySP.a. As a result, pluck.cpp was omitted from libDaisySP.a, causing an undefined reference to daisysp::Pluck::Init at link time.
    Fix:
    - Update CMakeLists.txt to include DaisySP-LGPL/Source/*.cpp, headers, and include directories in the DaisySP static library target.
    - Define USE_DAISYSP_LGPL compile definition on the DaisySP target.
    - Update Core/Src/pluck_synth.cpp to include PhysicalModeling/pluck.h without relative path hacks.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
    [pluck_synth.cpp]
2026-09-26 Fix USB MIDI IN endpoint selection and URB error recovery
    [usbh_midi.c]
2026-09-26 Fix damp parameter handling in PluckSynth
    Separated user-configured damp from velocity-dependent effective damp
    and moved all string_voice parameter updates strictly to the audio context.
    [pluck_synth.cpp]
2026-09-26 pluck_synth: replace params_dirty flag with sequence counter
    Replaces the boolean params_dirty flag with a sequence (generation)
    counter mechanism (params_sequence and applied_sequence).
    Control context updates parameter variables before incrementing
    params_sequence, and PluckSynth_NextSample checks if params_sequence
    differs from applied_sequence before applying parameters to string_voice
    and updating applied_sequence to the snapshot sequence value.
    This eliminates race conditions where parameter updates could be lost if
    an interrupt updated parameters while applied_sequence was being updated.
    [pluck_synth.cpp]
2026-09-26 Replace trigger_pending with lock-free SPSC FIFO
    Replace single trigger_pending boolean in Core/Src/pluck_synth.cpp
    with a lock-free SPSC ring buffer for NoteOn events. Each queued event
    captures frequency, amplitude, damping, and decay, ensuring fast
    consecutive NoteOn triggers are processed individually without loss.
    [pluck_synth.cpp]
2026-09-26 feat: implement amplitude release envelope in PluckSynth
    Decouples physical string decay from amplitude release behavior.
    Introduces a 0.25-second exponential amplitude release envelope applied
    post-string_voice.Process() and before int16_t sample scaling. Handles
    sustain pedal logic, NoteOn interrupt, and envelope threshold cutoff.
2026-09-26 Fix fast MIDI NoteOn/NoteOff state handling in PluckSynth
    Separates MIDI event control state and audio rendering state to prevent
    envelope and active note inconsistencies during rapid MIDI sequences.
    Uses atomic operations for cross-thread variables and manages release
    envelope decay dynamically in the audio thread context.
    [pluck_synth.cpp]
2026-09-26 Fix single-voice release tracking for rapid MIDI events in PluckSynth
    Decouples active audio voice release state from current_note by introducing
    atomic per-note key state tracking (note_pressed[128]). The audio thread
    evaluates release for active_audio_note using note_pressed[active_audio_note]
    and sustain_pedal status, ensuring rapid NoteOn/NoteOff sequences and sustain
    pedal transitions do not trigger spurious releases on active notes.
    Applies release-acquire memory ordering to parameter sequence updates.
    [pluck_synth.cpp]
2026-09-26 fix(synth): lock-free parameter snapshot in pluck_synth
    Replace volatile floats with a lock-free double-buffered parameter snapshot mechanism (SynthParams) published via std::atomic<uint32_t> with acquire-release ordering.
    This ensures parameter updates from control context to audio context conform strictly to C++ memory model rules while remaining lock-free, realtime-safe, and deterministic.
    [pluck_synth.cpp]
2026-09-26 fix(synth): lock-free triple-buffer parameter synchronization for PluckSynth
    Implement lock-free triple buffering with single atomic state exchange for SynthParams snapshots.
    Control context and audio context maintain separate buffer indices (control_write_idx and audio_read_idx) and exchange indices atomically via std::atomic<uint8_t> shared_state (storing NEW_SNAPSHOT_FLAG in bit 7 and buffer index in bits 0..1) with acq_rel memory ordering. This guarantees that control context can never overwrite a buffer slot currently being read by audio context, while ensuring audio context always receives the latest published parameters without mutexes or blocking.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
    [pluck_synth.cpp]
2026-09-26 fix(synth): lock-free bounded SPSC FIFO parameter synchronization for PluckSynth
    Implement a bounded lock-free SPSC FIFO for SynthParams snapshots with explicit slot ownership rules.
    Producer (Control context) writes to params_fifo[head & MASK] only when (head - tail < PARAMS_FIFO_SIZE), ensuring Consumer slots [tail ... head-1] are never overwritten. Consumer (Audio context) reads the latest published snapshot at (head - 1) & MASK and advances params_tail directly to head in O(1) time with acquire-release memory barriers.
    [pluck_synth.cpp]
2026-09-26 Fix USBH_MIDI_Stop pipe and state reset
    Reset data_rx_state to MIDI_IDLE and re-open InPipe after closing it
    in USBH_MIDI_Stop so that subsequent USBH_MIDI_Receive calls can safely
    restart MIDI reception.
    [usbh_midi.c]
2026-09-30 Display SPI enabled
2026-09-30 Display SPI settings change
2026-09-30 Display SPI dup init remove
2026-09-30 Display SPI update settings
2026-09-30 Debug LED configured
2026-09-30 Debug LED notes press added
2026-10-01 Proposed new display driver
2026-10-01 Display driver update
2026-10-02 Add USB MIDI interrupt-IN endpoint diagnostics
    - Add InEpInterval and diagnostic fields to MIDI_HandleTypeDef and MIDI_Diag_t
    - Store bInterval and HCD channel index in USBH_MIDI_InterfaceInit()
    - Output one-time endpoint discovery diagnostic line [USBEP]
    - Implement MIDI_PrintHCDDiagnostics() and capture HCD channel state after every URB result
    - Extend periodic [USBDIAG] logs with interval, HCD ch, and toggle_in fields
2026-10-02 Add USB MIDI interrupt-IN endpoint diagnostics
    - Capture HCD channel state after every URB result in MIDI_ProcessReception()
    - Remove redundant MIDI_PrintHCDDiagnostics helper per request
    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
2026-10-04 USB diag: split output, live HCD fields, UART timeout by length
2026-10-07 I have added USB enumeration diagnostics to `usbh_core.c`:
    - Enabled `USBH_DEBUG_LEVEL` to `3U` in `USB_HOST/Target/usbh_conf.h`.
    - Added static helper functions for converting status codes, enumeration states, control states, host states, request states, URB states, and step names to strings.
    - Added additive diagnostic logging (START, SUCCESS, FAIL, throttled BUSY, control setup parameters, control states, and HCD/URB info) inside `usbh_core.c` while leaving all original if/else control flow, retry logic, and state transitions 100% intact.
2026-10-07 Add minimal HCD-level diagnostics
    Add rate-limited diagnostic logging to stm32h7xx_hal_hcd.c for diagnosing HCD-level USB host channel events, interrupt flags, and CHH processing results.
2026-10-07 Add read-only HAINTMSK diagnostics to USB LL
    Add read-only diagnostic logging to USB_HostInit() and
    USB_HC_StartXfer() in Drivers/STM32H7xx_HAL_Driver/Src/stm32h7xx_ll_usb.c:
    - [HCDINIT] snapshot in USB_HostInit() logging GINTSTS, GINTMSK, HAINT,
    HAINTMSK, HFNUM, and HPRT.
    - [HCDXFER] ENTER, CONFIG, and EXIT logs in USB_HC_StartXfer() capturing
    channel parameters and register states.
    - Rate-limited per channel with static counters to prevent log flooding
    during high-frequency transfers.
    - Purely read-only with no modification to registers, interrupt masks,
    control flows, or USB behavior.
2026-10-07 Log HAINTMSK changes and initial USB transfers
    Update USB LL diagnostics in Drivers/STM32H7xx_HAL_Driver/Src/stm32h7xx_ll_usb.c:
    - Maintain mandatory read-only [HCDINIT] snapshot in USB_HostInit().
    - Track HAINTMSK changes using s_last_haintmsk and a change counter
    s_haintmsk_change_count (capped at 50 messages).
    - Log [HCDXFER] ENTER, CONFIG, and EXIT in USB_HC_StartXfer() when HAINTMSK
    changes or on initial channel transfers.
    - Strictly read-only; no modification to registers, interrupt masks, control
    flow, or USB behavior.
2026-10-07 Add HCD dispatch diagnostic logging for USB control transfer debug
    Add HCD_LogDispatch to log GINTSTS, HAINT, HAINTMSK, channel HCINT,
    HCINTMSK, HCCHAR, and HCTSIZ on channel interrupt dispatch in
    HAL_HCD_IRQHandler. Update HCD_LogHAINT to report old/new bitmap transitions.
2026-10-07 Add HCD launch and dispatch diagnostic logging for USB control transfer
    Add HCDLAUNCH diagnostic in USB_HC_StartXfer() to log register state
    before and after enabling host channel. Add HCDDISPATCH in HAL_HCD_IRQHandler()
    including Case B handling (when HAINT=0) and update HCDHAINT to log old and
    new bitmap values.
2026-10-08 CubeMX HAL drivers restored
2026-10-08 Display active MIDI notes and detected chords on TFT screen
    - Add ChordDetector module (`chord_detector.h` / `chord_detector.c`) to detect musical chords using pitch-class bitmasks, slash notation inversions, and tie-breaking.
    - Extend Display API with `Display_SetNoteState` to clear note display when no keys are pressed, render single notes when 1-2 keys are pressed, and render `ch <chord>` when 3+ keys are pressed.
    - Update `main.c` Note On/Off processing to update display state using existing `active_notes` array and `active_note_count`.
    - Add host unit test `test_chord_detector.cpp` covering inversions, octave duplications, and standard chord types.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
2026-10-08 Fix display note selection on Note Off events
    - Maintain active note press order stack in `main.c` so `Display_SetNoteState()` receives the most recently pressed active note.
    - Fix bug where releasing a note displayed the released inactive note name.
    - Remove redundant `snprintf` in `display.c`.
    - Add unit test coverage in `test_chord_detector.cpp` for Note Off and velocity=0 release order tracking.
    [display.c, main.c]
2026-10-09 Integrate bfreeOrgan2 Tonewheel Organ as MIDI Program 3
    Vendor bfreeOrgan2 and flexynth DSP sources into Third_Party/bfreeOrgan2/
    and adapt them to PurrMidi's synthesis engine interface.
    - Vendor required organ DSP files and create Third_Party/bfreeOrgan2/README.md
    - Implement Core/Inc/organ_synth.h and Core/Src/organ_synth.cpp with lock-free SPSC event queue and stereo PCM output
    - Register SYNTH_ENGINE_ORGAN as MIDI Program 3 in synth_engine.h and synth_engine.cpp
    - Support 9 drawbars (CC 20..28), chorus (CC 70..72), envelopes (CC 77..78), and All Notes Off (CC 120/123)
    - Update CMakeLists.txt for STM32 firmware and platform/windows/CMakeLists.txt for host build
    - Add test_organ_host and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
2026-10-09 Fix organ voice management, real-time audio block limits, and licensing
    - Fix voice allocation on NOTE_ON to re-use active voice playing same pitch
    - Update NOTE_OFF and CC 120/123 to deactivate all matching pitch voices
    - Bound event processing per audio block (16 events) in OrganSynth_FillStereoBuffer
    - Add atomic SPSC FIFO queue overflow panic recovery (flushes FIFO and deactivates all voices to prevent stuck notes)
    - Add LICENSE.txt (Apache 2.0) and NOTICE in Third_Party/bfreeOrgan2/
    - Record exact commit SHAs (bfreeOrgan2: 79e2ad9, flexynth: d3694bf) in README.md
    - Add unit tests for repeated Note On, All Notes Off with duplicate voices, and queue overflow recovery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
    [organ_synth.cpp, organ_synth.h]
2026-10-09 Fix 32-bit overflow in voice_organ, clean build-host from git, and expand polyphony tests
    - Fix potential signed int32_t integer overflow in voice_organ::get_sample() by performing envelope multiplication in int64_t and clamping result to int32_t range
    - Remove build-host/ build outputs from git tracking and add build-host/ to .gitignore
    - Expand test_organ_host with test_max_drawbars_full_polyphony() verifying full 12-voice polyphony rendering with all drawbars at 127 stays strictly within 16-bit PCM bounds [-32768, 32767]
    - Re-verify all 8 CTest host unit tests pass 100%
2026-10-09 Fix synth_organ::init voice reset to clear envelopes immediately
    - Implemented reset() across env_base, env_ar, env_click, and voice_organ
    - Updated synth_organ::init() to perform a full reset so active voice state and envelopes are immediately zeroed out without release tails
    - Updated Core/Src/organ_synth.cpp to perform a full reset on CC 120/123 and queue overflow recovery
    - Added test_init_clears_active_notes_immediately() verifying 0 output on the first block after OrganSynth_Init()
    [organ_synth.cpp]
2026-10-09 Add TinySoundFont SF2 synth with bounded 64KB RAM streaming cache
    - Integrate TinySoundFont in Middlewares/Third_Party/TinySoundFont/tsf.h
    - Implement sf2_cache for lock-free 64KB RAM sample cache and SD file backend
    - Create soundfont_synth engine and register as MIDI Program Change 4
    - Update main.c, CMakeLists.txt, tests/test_synth_switch.cpp, and tests
    - Add docs/SOUNDFONT_SYNTH.md and update README.md
2026-10-09 Fix SF2 cache slot race condition during sample reading
    Add atomic active reader counter and state protection to SF2 cache blocks.
    Audio thread registers active reads and re-verifies slot state and block
    index before reading samples in SF2Cache_GetSample(). Evictor context
    transitions candidate slots to SF2_BLOCK_EVICTING and verifies zero
    active readers in SF2Cache_ProcessRequests() before overwriting.
    [sf2_cache.cpp, sf2_cache.h]
2026-10-09 Fix SF2 cache block loading verification and retry handling
    Ensure SF2Cache_ProcessRequests strictly validates file seeking, read result, and exact byte count matching expected size (accounting for trailing partial sample blocks). On failure, transition target cache slot to SF2_BLOCK_EMPTY without publishing READY state or block_index, and safely re-queue valid block requests with deferred retry.
    [sf2_cache.cpp]
2026-10-09 Fix host file error clearing before read in SF2Cache_ProcessRequests
    Explicitly call std::clearerr(g_host_file) prior to fseek and fread operations in host mode to ensure std::ferror reflects the status of the current read operation rather than stale error indicators from prior reads.
    [sf2_cache.cpp]
2026-10-09 test: add unit tests for SF2 cache block load error handling
    Add unit test scenarios in test_soundfont_host to verify SF2Cache_ProcessRequests error handling and retry logic:
    - Successful load of full block (1024 samples)
    - Successful load of last partial block
    - Seek error handling and slot reusability
    - Short read error handling
    - Read error handling
    - Single-pass non-infinite loop verification and retry on subsequent calls
2026-10-09 test: refine SF2 cache block load error handling unit tests
    Refine test_soundfont_host unit tests for SF2Cache_ProcessRequests:
    - Verify successful loading of full cache block (1024 samples)
    - Verify successful loading of trailing partial block (e.g. 476 samples)
    - Verify short read handling ensures partial data is NOT published as ready and slot remains reusable
    - Replace time-based assertions with deterministic queue/state assertions for single-pass processing and retries
    - Document stdio seek boundary behaviors in test comments
2026-10-10 test: overhaul and update unit test suite
    Overhaul test files in tests/ directory to match current decoding logic,
    queue dispatch behavior, synthesizer engines, and chord detector rules.
2026-10-10 Refactor Pluck Synth polyphony with lock-free thread safety and robust tests
2026-10-10 Fix Pluck Synth event FIFO overflow architecture
    Eliminate data race and event reordering by removing in-place slot eviction in Pluck Synth event FIFO. Implement slot reservation (NOTE_ON_FIFO_LIMIT = 28) for critical release events and restore press counts on enqueue failure. Update overflow host unit tests accordingly.
    [pluck_synth.cpp]
2026-10-10 Fix critical event delivery during full FIFO saturation in Pluck Synth
    Add lock-free atomic fallback registers for Note Off and CC64 events when the main 32-slot event FIFO is 100% full. Ensures zero stuck notes or stuck sustain without violating SPSC queue invariants, modifying published entries, or introducing audio thread locks. Update host unit tests to verify 100% saturation release delivery.
    [pluck_synth.cpp]
2026-10-10 Implement emergency overflow recovery for Pluck Synth critical events
    Replace fallback registers with atomic event_overflow_recovery_requested flag. When a critical release event fails to enqueue into a 100% full FIFO, the audio consumer thread performs a single unified state reset (clears sustain pedal, transitions active voices to damper decay, resets press counters, and flushes FIFO) without audio locks or race conditions.
    [pluck_synth.cpp]
2026-10-10 Implement lock-free recovery state machine protocol for Pluck Synth FIFO overflow
    Implement atomic state machine protocol (RECOVERY_NORMAL, RECOVERY_REQUESTED, RECOVERY_IN_PROGRESS) and active_producer_ops counter in Pluck Synth. Ensures producer operations enter/exit atomically, rejecting new events without count mutations during recovery. Audio thread defers reset until active_producer_ops reaches 0, flushing FIFO monotonically (fifo_tail = fifo_head) and clearing held notes/sustain without locks or data races.
    [pluck_synth.cpp]
2026-10-10 Add ARM build to GitHub Actions
2026-10-12 feat: Add instrument switching via User Key K1 (PC13)
    - Expose SynthEngine_SelectNext() in synth_engine.h/cpp to cycle to the next available instrument, skipping unavailable engines.
    - Refactor MIDI_Dispatch() in midi_dispatch.c to call SynthEngine_SelectNext() for Program Change 127.
    - Implement non-blocking software debounced processing for User Key K1 (PC13) in Core/Src/main.c.
    - Update display patch name via Display_SetPatch() on startup and program change.
    - Add host unit test for SynthEngine_SelectNext() in test_synth_switch.cpp.
    - Update README.md with K1 button switching documentation.
2026-10-12 docs: improve code formatting and add Russian technical documentation
    Safely improved code formatting uniformity and added technical comments in Russian
    explaining thread safety, lock-free SPSC queues, synth DSP algorithms, and hardware constraints.
2026-10-12 docs: update Russian comments and preserve full API details and include order
    - Restored detailed technical Russian documentation in Core/Inc/diag.h, Core/Inc/display.h, and Engine/synth/soundfont_synth.h
    - Preserved exact API constraints, string limits, NULL handling, lazy loading semantics, and stack frame layouts
    - Restored original `#include` order across header and source files
2026-10-12 docs: restore full technical details in Russian across synth, core, and platform headers
    - Restored read-ahead rationale, loop sample constraints, threading rules, and counter meanings in sf2_cache.h
    - Restored float calculation, zero malloc, lock-free, and FIFO processing notes in epiano_synth.h
    - Restored CubeMX regeneration rationale for usb_port_recover.h location outside Middlewares/
    - Preserved exact original #include order and API constraints across all modified files
2026-10-13 Add polyphonic subtractive Lead synthesizer based on DaisySP
    Replace Sine synth on Program Change 2 (SYNTH_ENGINE_LEAD) with
    a polyphonic subtractive analog Lead synthesizer using DaisySP
    components (Oscillator WAVE_POLYBLEP_SAW, Svf LPF filter, and Adsr
    amplitude/cutoff envelopes). Retain existing sine_synth.c/h in the
    project as unconnected code. Update CMake build files and README.
2026-10-13 Fix firmware compilation issue and add polyphonic subtractive Lead synth
    Fix reference to SYNTH_ENGINE_SINE in Core/Src/main.c. Replace Sine synth
    on Program Change 2 (SYNTH_ENGINE_LEAD) with a polyphonic subtractive analog
    Lead synthesizer using DaisySP components (Oscillator WAVE_POLYBLEP_SAW, Svf LPF
    filter, and Adsr amplitude/cutoff envelopes). Retain existing sine_synth.c/h
    in the project as unconnected code. Update CMake build files and README.
2026-10-13 Refine Lead synth FIFO architecture and add host test suite
    Refine Lead synth FIFO mechanics and emergency recovery state machine to
    match Pluck synth architecture. Map CC1 to filter envelope depth, CC71 to
    resonance, CC72 to release time, CC73 to attack time, and CC74 to cutoff.
    Replace magic numbers with named constants. Add dedicated host unit test
    suite in tests/test_lead_host.cpp and integrate it into CMake/CTest.
2026-10-14 Fix control key auto-repeat filtering and CLI argument validation
2026-10-14 fix(win): fix virtual keyboard event polling and ConPTY focus
    Check stdin character device type on initialization and update
    VirtualKeyboard::Poll() to verify window visibility before checking foreground
    window focus. Handle FOCUS_EVENT and drain console input events with
    ReadConsoleInputW to prevent key press spillover and ensure virtual keyboard
    works in Windows Terminal/ConPTY environments.
2026-10-14 Integrate Dulcimer Modal Resonator synth into PurrMidi engine
    - Register Dulcimer instrument as SYNTH_ENGINE_DULCIMER in synth_engine.h/cpp and main.c display patch names
    - Fix voice stealing isolation so Note Off for stolen notes does not mute reassigned voice
    - Ensure single-pulse EXCITER_FLAG_RISING_EDGE triggering per note attack
    - Maintain lock-free SPSC queue thread safety and D2 SRAM (.ram_d2) static voice placement
    - Expand test_dulcimer_host.cpp with 10 comprehensive regression scenarios (TEST_ASSERT)
    - Update existing synth switch and soundfont host tests for 6 synth engines
    - Verify 100% CTest pass rate across all 14 host test units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
2026-10-14 Add physical modeling Flute synthesizer engine (STK Flute model)
    Implement polyphonic physical modeling Flute synthesizer based on the STK
    Flute architecture (breath pressure generator with xorshift turbulence noise,
    non-linear cubic Jet Table exciter, jet delay line, bore delay line with
    1-pole lowpass wall damping filter, and vibrato LFO).
    - Add public API: FluteSynth_Init, FluteSynth_NoteOn, FluteSynth_NoteOff,
    FluteSynth_ControlChange, FluteSynth_FillStereoBuffer, FluteSynth_IsNoteActive,
    FluteSynth_GetDroppedEventsCount.
    - Register SYNTH_ENGINE_FLUTE = 6 in SynthEngineId (SYNTH_ENGINE_COUNT = 7)
    and integrate into synth engine dispatcher and display patch names.
    - Update root, pl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
2026-10-14 Fix memory region overflow in STM32H7 firmware build for Flute synth
    Optimize FluteVoice memory layout by parameterizing DelayLine buffer sizes
    (1024 floats for bore delay, 512 floats for jet delay) and statically
    allocating the voice structures in D2 SRAM (.ram_d2 section) on ARM targets.
    This eliminates AXI SRAM (.axi_heap) overflow during firmware linking.
2026-10-14 Optimize Flute synth DSP, memory section, and add test coverage
    - Refine physical waveguide Flute synth DSP model with pre-computed MIDI
    note frequency lookup table, precalculated envelope rates, and safe delay bounds.
    - Place FluteVoice memory array in .ram_d2 section (D2 SRAM) to avoid AXI SRAM
    and DTCMRAM link-time section overflow in STM32 firmware builds.
    - Implement thread-safe SPSC FIFO queue with reserved slots, saturating press
    counter, and non-blocking 100% saturation emergency recovery state machine.
    - Add comprehensive host unit tests in test_flute_host.cpp covering FIFO overflow,
    critical event reserved delivery, emergency recovery, overlapping note presses,
    sustain pe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
2026-10-14 Eliminate data races on CC envelope rates and place FluteVoice in D2 SRAM
    Fix data races between MIDI control thread and audio ISR context by making all
    CC parameter variables atomic and computing envelope attack and release rates
    strictly within the audio rendering thread (FluteSynth_NextSample).
    Allocate FluteVoice array in D2 SRAM (.ram_d2 section) on ARM targets, freeing
    ~50 KB in AXI SRAM (RAM) to eliminate section .axi_heap link-time overflow in
    STM32H7 firmware builds. All 15 host CTest unit tests pass.
2026-10-14 Fix data race on cached_release_rate in FluteSynth and optimize memory layout
    Eliminate cross-thread data race between MIDI Control Change handling
    and audio ISR processing by removing non-atomic cached_release_rate/cached_attack_rate
    globals and deriving envelope rates within FluteSynth_NextSample using relaxed
    atomic loads of cc_release_sec and cc_attack_sec.
    Voice memory array FluteVoice voices[8] is placed in section .ram_d2 (D2 SRAM)
    on ARM targets, keeping AXI SRAM (.axi_heap) free and preventing linker memory
    region overflow on STM32H7. All 15 host CTest unit tests pass.
2026-10-14 Add single-reed physical modeling Saxophone synth engine
    Implement Saxophone / Clarinet single-reed physical modeling synthesizer
    based on STK digital waveguide model. Includes breath turbulence generator,
    non-linear reed table exciter, bore delay line resonator with lowpass
    damping filter, MIDI CC parameter mapping, lock-free SPSC event queueing,
    D2 SRAM memory placement for ARM target, CMake integration, and host tests.
2026-10-14 Enhance Saxophone synth host tests with float sample stability checks
    - Expose SaxophoneSynth_FillFloatBuffer() for inspecting raw float output
    - Verify raw float samples with std::isfinite() and [-1.0f, +1.0f] amplitude checks
    - Add tests for re-triggering stolen notes, repeated NoteOff calls, and velocity 0
    - Validate Single-Producer Single-Consumer (SPSC) FIFO call contract
    - Pass 100% of host CTest unit test suite (16/16 tests)
2026-10-21 PCM5102 board sizes added
2026-10-21 DAC board sizes update
2026-10-21 BOARD_CHECKLIST.md updated
2026-10-22 Enclosure selecting
2026-10-22 Enclosure print task
2026-10-22 working on enclosure
2026-10-23 Enclosure draft ready
2026-10-23 Place logo on top of enclosure
2026-10-23 STM32H7xx_BoardShape Board Shape 外形 V12.pdf
2026-10-23 PCB sizes
